hutscape/oak/readme.md

# Oak

> 🌳 Outdoor LoRa-GPS tracker with E-Ink display  🔑

Visit [hutscape.com/oak](https://hutscape.com/oak) for more details.

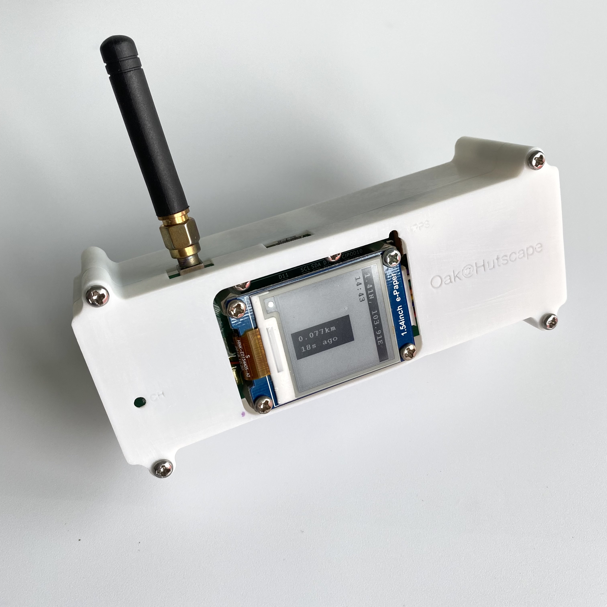
[picture p1: images/prototype/front.jpg]
