hutscape/oak/others.md

---
layout: others
title: Others
permalink: /others
sequence: 7

# Lessons
lessons:
  - title: Lessons learnt
    subtitle: Good practices to continue for future projects
    list:
      - name: Add functional logical blocks in schematic to use similar circuits in future versions or other projects
      - name: Use stencil SMD soldering with SMD components only if it is necessary. Else, use a PCB assembly service.
      - name: Use minimum number of through-hole components
      - name: Check Gerber file format with the PCB manufacturer before rendering them
      - name: Check <code>F.Paste</code> and <code>B.Paste</code> layers for SMD stencil pattern
      - name: Pull out every single MCU pin as a test point for the first version of the project.
      - name: Always buy buffer number of components. Image is from the book Designing Electronics That Work by Hunter Scott.
        image: buffer-components.png

  - title: Enclosure
    subtitle: Next iteration improvements
    list:
      - name: Make the PCB routing symmetrical for LED positions and connector slots
      - name: Ensure the length is not too long to prevent bending of the material
      - name: Use wider ventilation holes with wider spacing between each of them
      - name: Use less clearance for connector slots. Take note of finger access
      - name: Use other shapes for connector slots E.g. rounded corner or trapezoid
      - name: Use shape binder for seperation plane bends
      - name: Use a counter sunk screw head
      - name: Make the screw lug's initial length be wider to contain the screw head so that it can sink into the surface
      - name: Try a snap-fit enclosure

  - title: V2.0
    subtitle: For next iteration
    list:
      - name: Use SMD components only on top layer for one-step manual SMD stencil soldering process
      - name: Place a writable area on the silkscreen to note down LoRa node address, PCB number, frequency or other info
      - name: Add a <a href="https://sg.element14.com/c/test-measurement/test-connectors-ic-clips/pcb-test-points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">surface mount PCB test point</a> for <code>VBAT</code>, <code>VBUS</code>, <code>3.3V</code>, <code>5V</code>, <code>GND</code> and SPI points.
      - name: Use a smaller <code>SSD1306</code> I2C OLED display instead of E-Ink. It's cheaper and easier to source and buy.

  - title: Board bring-up
    list:
      - name: Check with 3 PCBs to conclude whether it is a design issue or a soldering / manufacturing / assembly issue
      - name: Power it with current limiting power supply unit only. Check all the power test points such as <code>VBAT</code>, <code>VBUS</code>, <code>3.3V</code>, <code>5V</code>, <code>GND</code>.

# References
similar:
  - name: LilyGO TTGO T-Beam
    url: https://github.com/Xinyuan-LilyGO/LilyGO-T-Beam
    type: developer
    year: 2019
    cost: 25
    components:
      - type: LoRa
        name: SX1262
        url: https://semtech.my.salesforce.com/sfc/p/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
      - type: battery
        name: 18650
        url: https://datasheetspdf.com/pdf-file/1408721/TENERGY/18650/1
      - type: mcu
        name: ESP32
        url: https://www.espressif.com/en/products/socs/esp32
      - type: GPS
        name: ublox NEO 6M
        url: https://www.u-blox.com/en/product/neo-6-series
      - type: Display
        name: OLED SSD1306
        url: https://cdn-shop.adafruit.com/datasheets/SSD1306.pdf
  - name: a LoraWAN GPS tracker
    url: https://notes.iopush.net/how-to-make-a-lorawan-gps-tracker/
    type: developer
    year: 2016
    components:
      - type: LoRa
        name: RFM95
        url: https://cdn.sparkfun.com/assets/learn_tutorials/8/0/4/RFM95_96_97_98W.pdf
      - type: battery
        name: 18650
        url: https://datasheetspdf.com/pdf-file/1408721/TENERGY/18650/1
      - type: software
        name: node red
        url: https://nodered.org/
  - name: LoRaSensorTile
    url: https://hackaday.io/project/35169-hackable-cmwx1zzabz-lora-devices
    type: developer
    year: 2018
    components:
      - type: LoRa (with MCU STM32L082)
        name: CMWX1ZZABZ-078
        url: https://wireless.murata.com/pub/RFM/data/type_abz.pdf
      - type: mcu
        name: STM32L082
        url: https://www.st.com/resource/en/datasheet/dm00141132.pdf
      - type: accelerometer
        name: BMA280
        url: https://www.bosch-sensortec.com/products/motion-sensors/accelerometers/bma280.html#tab_module_16_1_2
      - type: pressure sensor
        name: BME280
        url: https://www.bosch-sensortec.com/products/environmental-sensors/humidity-sensors-bme280/
      - type: RGBW light sensor
        name: VEML6040
        url: https://www.vishay.com/ppg?84276
      - type: flash memory
        name: MX25L12835FZNI
        url: https://www.macronix.com/Lists/Datasheet/Attachments/7397/MX25L12835F,%203V,%20128Mb,%20v1.6.pdf
  - name: GPS Live Tracking
    type: developer
    url: https://kokonatt.com/embedded/gps-live-tracking
    components:
      - type: microcontroller
        name: ESP8266
        url: https://www.espressif.com/en/products/socs/esp8266
      - type: GPS
        name: u-blox Neo-6M
        url: https://www.u-blox.com/en/product/neo-6-series
      - type: visualization
        name: Grafana
        url: https://grafana.com/docs/grafana/latest/administration/configuration/
      - type: database
        name: Influx DB
        url: https://www.influxdata.com/
      - type: LoRa
        name: SX1278
        url: https://cdn-shop.adafruit.com/product-files/3179/sx1276_77_78_79.pdf
  - name: LoRaWAN GPS Tracker with 9-axis accelerometer-LGT92- 868MHz
    type: developer
    url: https://www.seeedstudio.com/LoRaWAN-GPS-Tracker-with-9-axis-accelerometer-LGT92-p-2922.html
    cost: 39.50
    year: 2020
    components:
      - type: microcontroller
        name: STM32L072
      - type: LoRa
        name: SX1276 / 1278
      - type: battery
        name: 1000mA Li-on
      - type: accelerometer
        name:  MPU-9250
        url: https://invensense.tdk.com/wp-content/uploads/2015/02/PS-MPU-9250A-01-v1.1.pdf
  - name: SAMD21 LoRa Development Board with GPS
    url: https://hackaday.io/project/165646-samd21-lora-development-board-with-gps
    year: 2018
    type: developer
    components:
      - type: microcontroller
        name: ATSAMD21E18A-AU
      - type: GPS
        name: Quectel L80 GPS module
      - type: LoRa
        name: RFM95W
      - type: battery
        name: LiOn

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

  - topic: LoRa Antenna
    list:
      - name: Testing LoRa Antennas at 915MHz
        url: https://medium.com/home-wireless/testing-lora-antennas-at-915mhz-6d6b41ac8f1d

  - topic: GPS
    list:
      - name: Calculate distance between two latitude-longitude points? (Haversine formula)
        url: https://stackoverflow.com/a/27943/496797
      - name: Haversine formula
        url: https://en.wikipedia.org/wiki/Haversine_formula
      - name: Testing out an upcoming STEMMA GPS board for STEMMA SUNDAY
        url: https://www.youtube.com/watch?v=JhquVC3RbZU
      - name: Adafruit Mini GPS PA1010D - UART and I2C - STEMMA QT
        url: https://www.adafruit.com/product/4415
      - name: Adafruit GPS Arduino firmware
        url: https://github.com/adafruit/Adafruit_GPS
      - name: CD-PA1010D GNSS patch antenna module Data Sheet V.02
        url: http://docs.mirifica.eu/CDtop-tech.com/CD-PA1010/CD-PA1010D-datasheet-v02.pdf
      - name: CDTop Technology PA1010Dv2 (CD-PA1010D2)
        url: https://www.mirifica.de/101067-1/cdtop-technology/pa1010daa19220027
      - name: NEO-6M GPS Module — An Introduction
        url: https://www.electroschematics.com/neo-6m-gps-module/
      - name: GPS Nixie Alarm Clock with Ublox NEO-6M GPS module
        url: https://hackaday.io/project/9417-gps-nixie-alarm-clock
      - name: Mini GSM/GPRS GPS Breakout SIM808
        url: http://wiki.seeedstudio.com/Mini_GSM_GPRS_GPS_Breakout_SIM808/
      - name: SIM808 GPS Application Note V1.00
        url: https://cdn-shop.adafruit.com/datasheets/SIM808_GPS_Application_Note_V1.00.pdf
      - name: 66-Channel LS20031 GPS Receiver Module (MT3329 Chipset)
        url: https://www.pololu.com/product/1249
      - name: Adafruit ultimate GPS with MTK3339 chipset
        url: https://www.adafruit.com/product/746
      - name: MEDIATEK - 3329 Datasheet
        url: https://www.puntoflotante.net/MEDIATEK-3329.pdf
      - name: GSM & GPS Car Diagnosis System with MEDIATEK MT3329
        url: https://hackaday.io/project/711-gsm-gps-car-diagnosis-system
      - name: Quectel L30 Compact GPS Module with Super Sensitivity
        url: https://www.quectel.com/UploadFile/Product/Quectel_L30_GPS_Specification_V2.0.pdf
      - name: NEO-7 series u-blox 7 GNSS modules
        url: https://www.u-blox.com/en/product/neo-7-series
      - name: NEO-6 series Versatile u-blox 6 GPS modules
        url: https://www.u-blox.com/en/product/neo-6-series
      - name: NEO-6 u-blox 6 GPS Modules Data Sheet
        url: https://www.u-blox.com/sites/default/files/products/documents/NEO-6_DataSheet_%28GPS.G6-HW-09005%29.pdf
      - name: SkyTraq Venus838LPx-T Timing GPS module breakout
        url: https://www.tindie.com/products/nsayer/skytraq-venus838lpx-t-timing-gps-module-breakout/
      - name: Venus838LPx-T 1cm2 Precision Timing GPS Receiver
        url: https://www.skytraq.com.tw/homesite/Venus838LPx-T_PB_v2.pdf
      - name: MAX-7 series u-blox 7 GNSS modules
        url: https://www.u-blox.com/en/product/max-7-series

  - topic: E-Ink
    list:
      - name: Waveshare 1.54inch e-Paper Module
        url: https://www.waveshare.com/wiki/1.54inch_e-Paper_Module
      - name: Waveshare 200x200, 1.54inch E-Ink raw display panel
        url: https://www.waveshare.com/product/modules/oleds-lcds/e-paper/1.54inch-e-paper.htm
      - name: Waveshare 200x200, 1.54inch E-Ink raw display panel schematic to module
        url: https://www.waveshare.com/w/upload/5/5b/1.54inch_e-Paper_Schematic.pdf
      - name: Waveshare 1.54inch e-Paper Module datasheet
        url: https://www.waveshare.com/w/upload/7/77/1.54inch_e-Paper_Datasheet.pdf

  - topic: Firmware
    list:
      - name: Arduino Core for STM32L0 with LoRaWAN connectivity
        url: https://github.com/GrumpyOldPizza/ArduinoCore-stm32l0

  - topic: SPI
    list:
      - name: How to access multiple SPI interfaces on Arduino
        url: https://arduino.stackexchange.com/questions/8425/how-to-access-multiple-spi-interfaces-on-arduino
      - name: Better SPI BUS design in 3 steps
        url: https://dorkbotpdx.org/blog/paul/better_spi_bus_design_in_3_steps/
      - name: Serial Peripheral Interface (SPI)
        url: https://learn.sparkfun.com/tutorials/serial-peripheral-interface-spi

  - topic: Manufacturing
    list:
      - name: How to Solder Castellated Mounting Holes
        url: https://learn.sparkfun.com/tutorials/how-to-solder-castellated-mounting-holes/all

# Schedule
design_start: '2019-11-05'
design_end: '2021-05-20'
manufacturing_start: '2021-05-24'
manufacturing_end: '2021-06-10'
integration_start: '2021-06-21'
integration_end: '2021-12-31'
deployment_start: '2022-01-01'
deployment_end: '2022-02-15'
---
