hutscape/oak/case/case.md

---
layout: case
title: Case
permalink: /case
sequence: 3
photos:
  - name: case-front.png
    caption: Case front
  - name: case-back.png
    caption: Case back
  - name: case-details-1.png
    caption: Case details 1
  - name: case-details-2.png
    caption: Case details 2
threedprint: true

manufacturing_params_image: manufacturing_params_case.png
manufacturing_params:
  - name: Manufacturer
    value: PCBWay
  - name: Build time
    value: 5 days
  - name: Size
    value: 132.40 mm × 55.80 mm × 23.20 mm
  - name: Material
    value: Resin Standard white material (UTR 8360)
  - name: Color
    value: Matte White
  - name: Process
    value: SLA
---
