hutscape/oak/examples.md

---
layout: default
title: Examples
permalink: /examples
sequence: 2
---

{% if site.examples %}
<section class="section is-small">
  <div class="container">
    <h2 class="title is-1">Examples</h2>
    <div class="content is-medium">
      <ol type="1">
        {% for example in site.examples %}
        <li>
          <a href="{{ site.url }}{{ example.url }}">{{ example.title }}</a>
          <div class="tags is-pulled-right">
            {% for feat in example.features %}
            <span class="tag is-warning is-light">{{ feat }}</span>
            {% endfor %}
            {% for v in example.versions %}
            <span class="tag is-link is-light">{{ v.name }} v{{v.version}}</span>
            {% endfor %}
            <span class="tag">{{ example.difficulty }}</span>
            <!-- TODO -->
            {% if jekyll.environment == "development" %}
            {% if example.images.prototype %}
            {% else %}
            <span class="tag is-danger">TODO Prototype image</span>
            {% endif %}
          {% endif %}
          </div>
        </li>
        {% endfor %}
      </ol>
    </div>
  </div>
</section>
{% endif %}
