hutscape/oak/images/case/case-3dprint-1.jpg

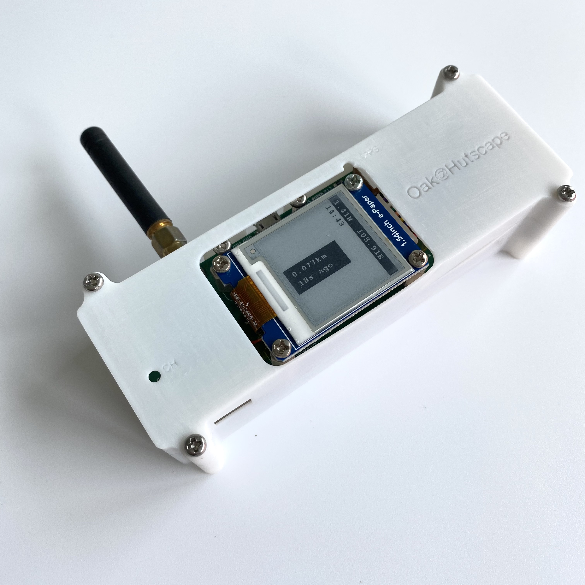
images/case/case-3dprint-1.jpg
