hutscape/oak/images/case/case-3dprint-2.jpg

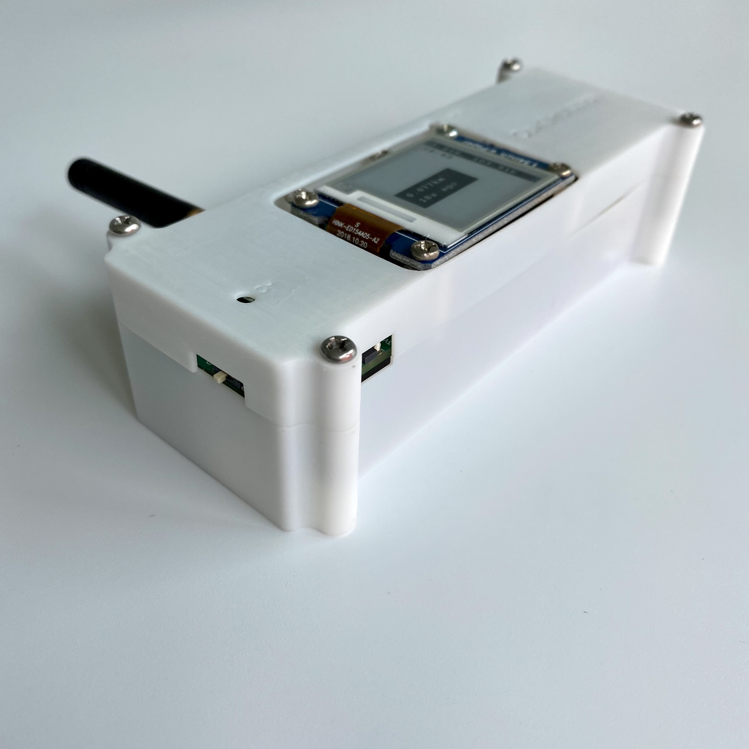
images/case/case-3dprint-2.jpg
