hutscape/oak/images/case/case-3dprint-4.jpg

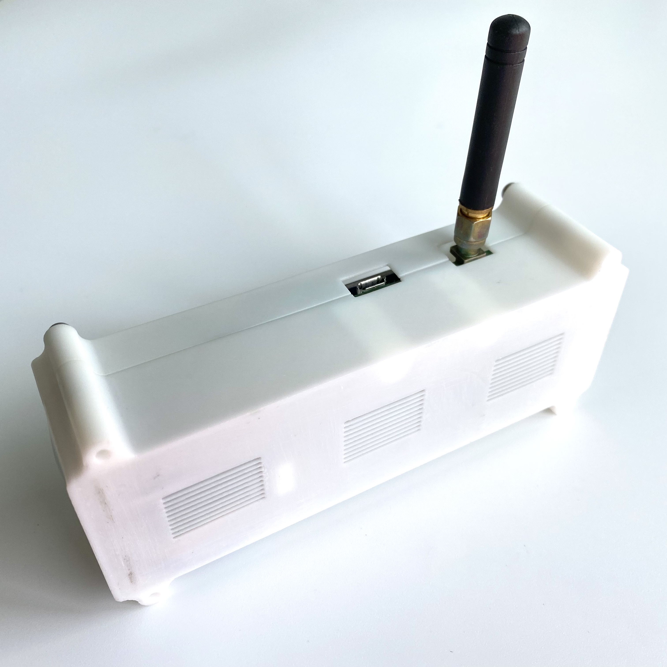
images/case/case-3dprint-4.jpg
