hutscape/oak/images/case/case-electronics.png

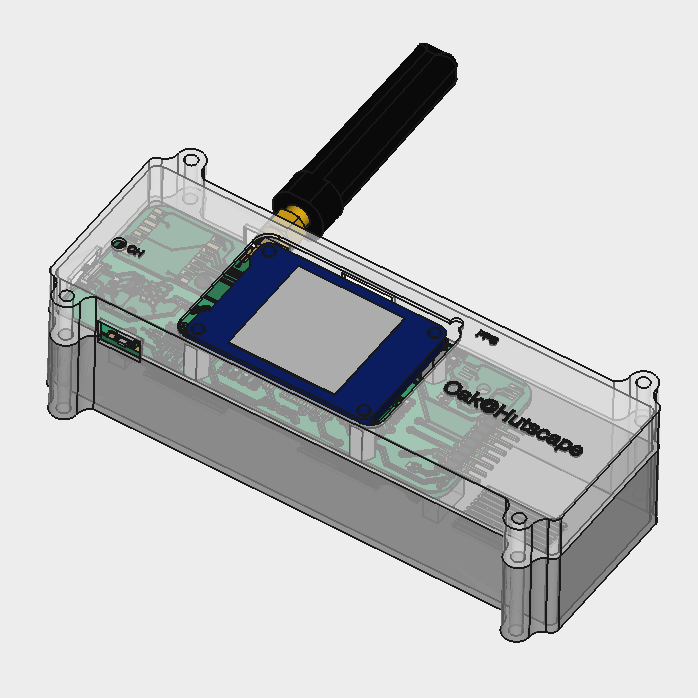
images/case/case-electronics.png
