hutscape/oak/images/case/case.png

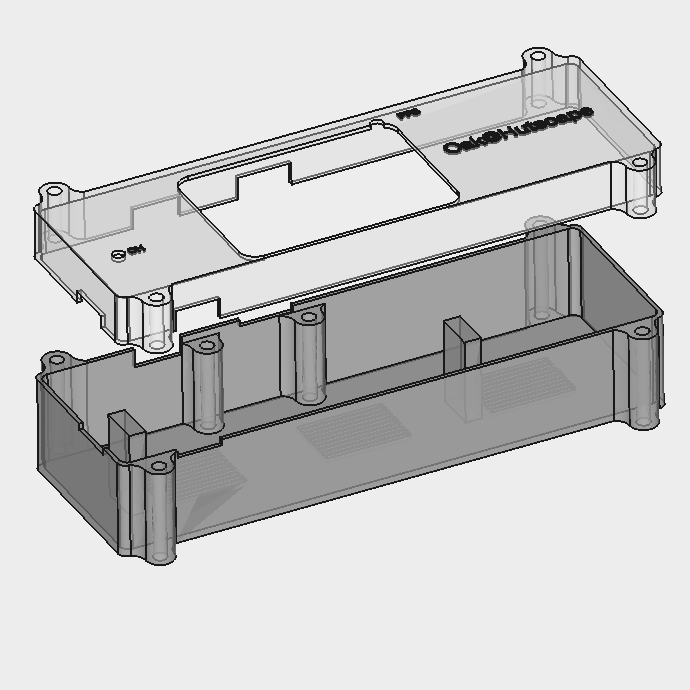
images/case/case.png
