hutscape/oak/images/code/arduino-ide-board.png

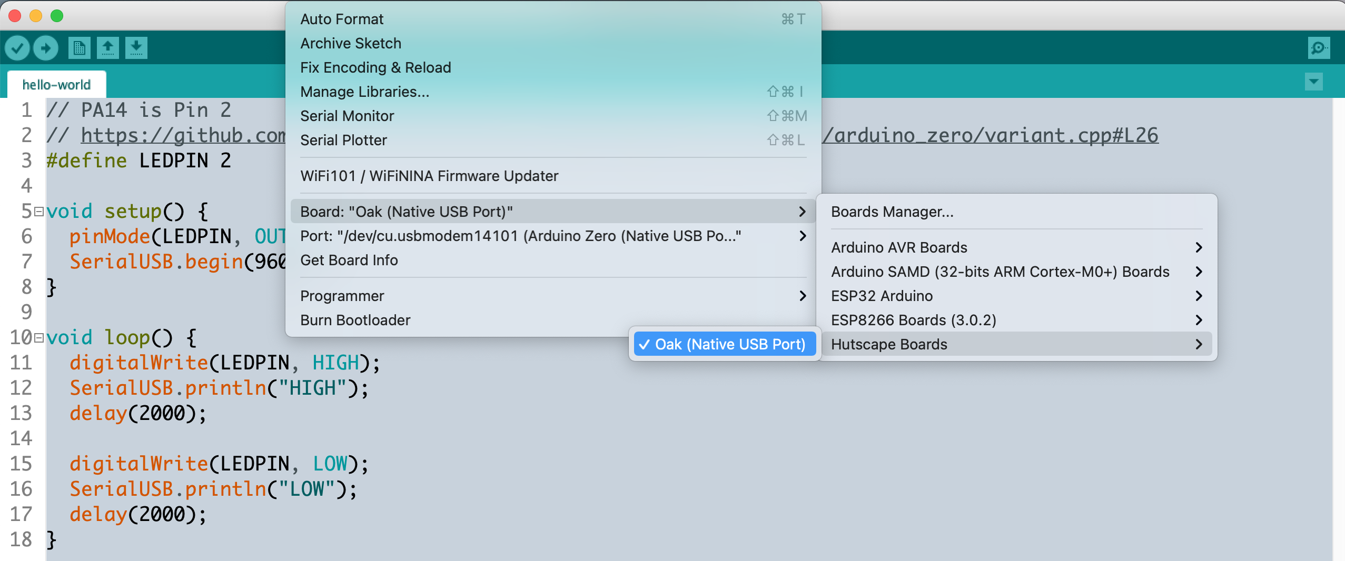
images/code/arduino-ide-board.png
