hutscape/oak/images/code/bootloader-prototype.jpg

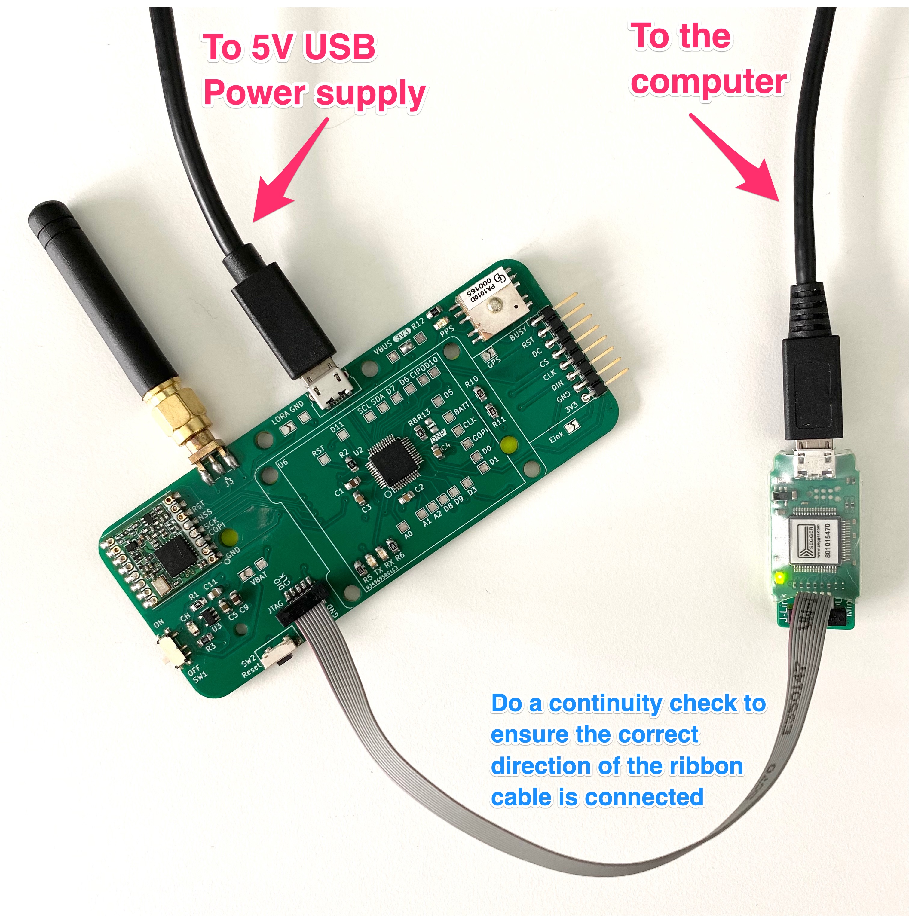
images/code/bootloader-prototype.jpg
