hutscape/oak/images/code/bootloader-schematic.png

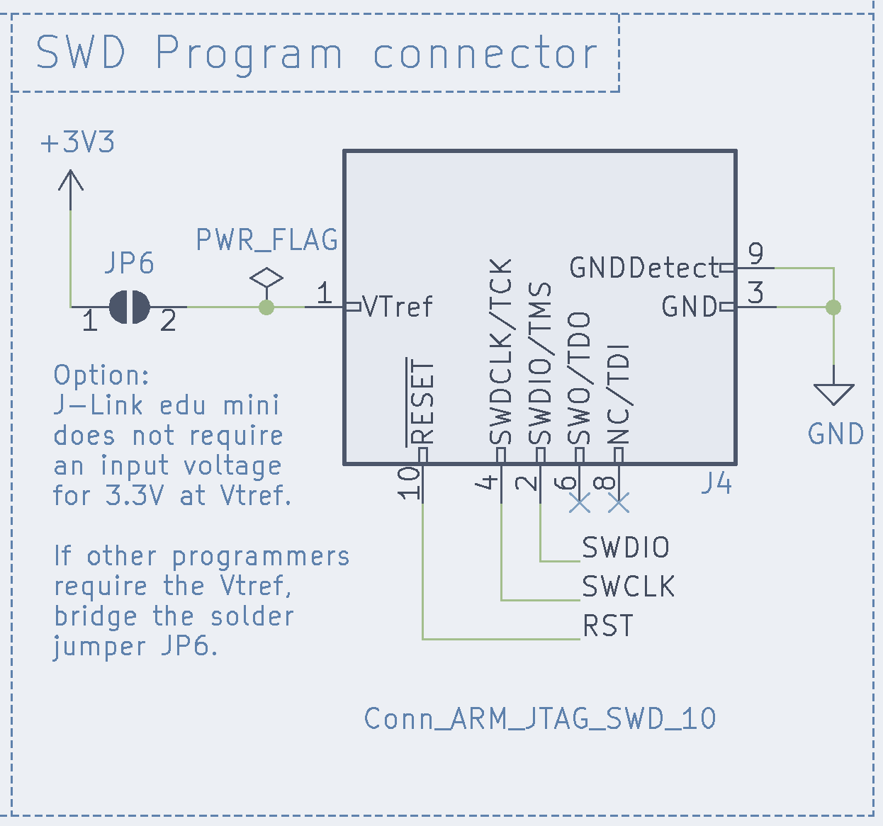
images/code/bootloader-schematic.png
