hutscape/oak/images/code/custom-arduino-prototype.jpg

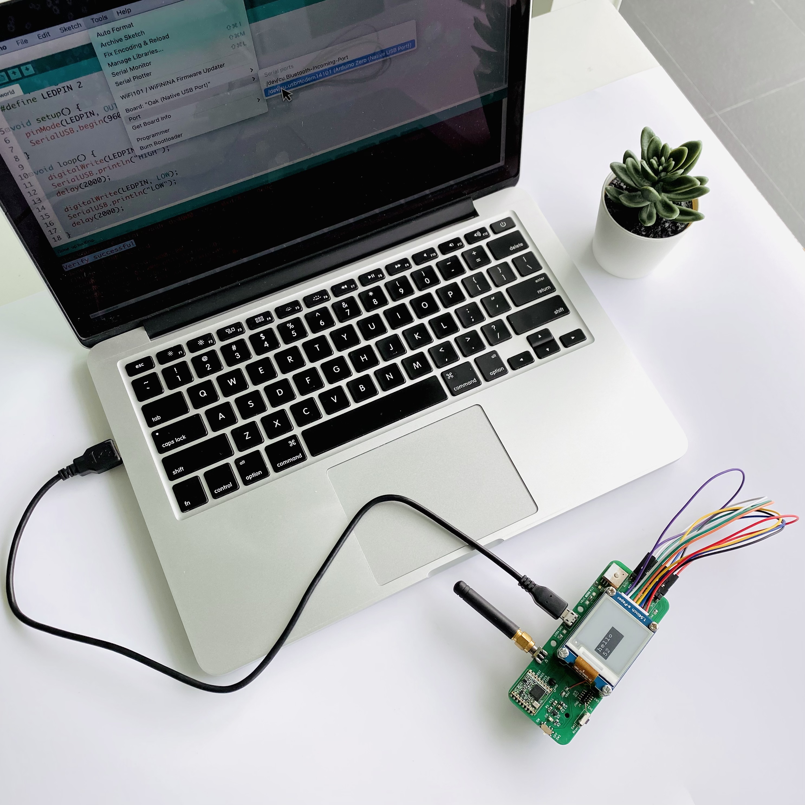
images/code/custom-arduino-prototype.jpg
