hutscape/oak/images/code/demo-console.png

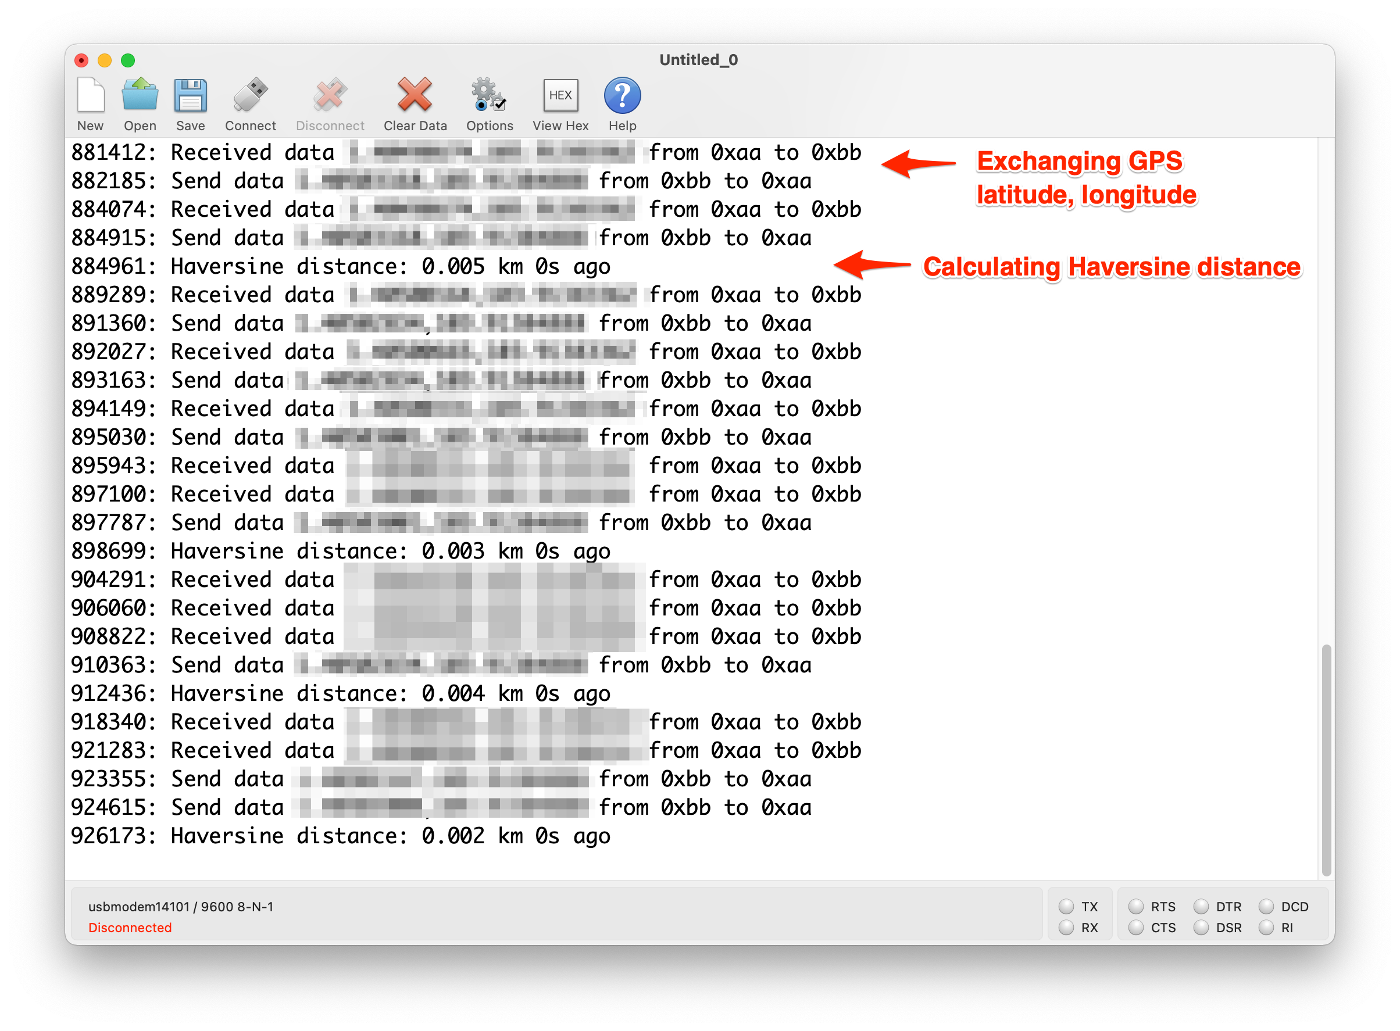
images/code/demo-console.png
