hutscape/oak/images/code/demo-prototype.jpg

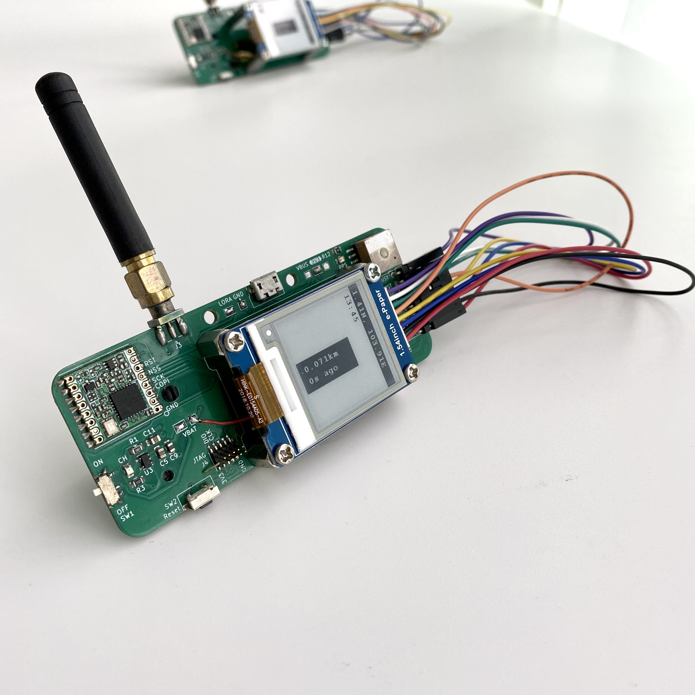
images/code/demo-prototype.jpg
