hutscape/oak/images/code/demo-waiting.jpg

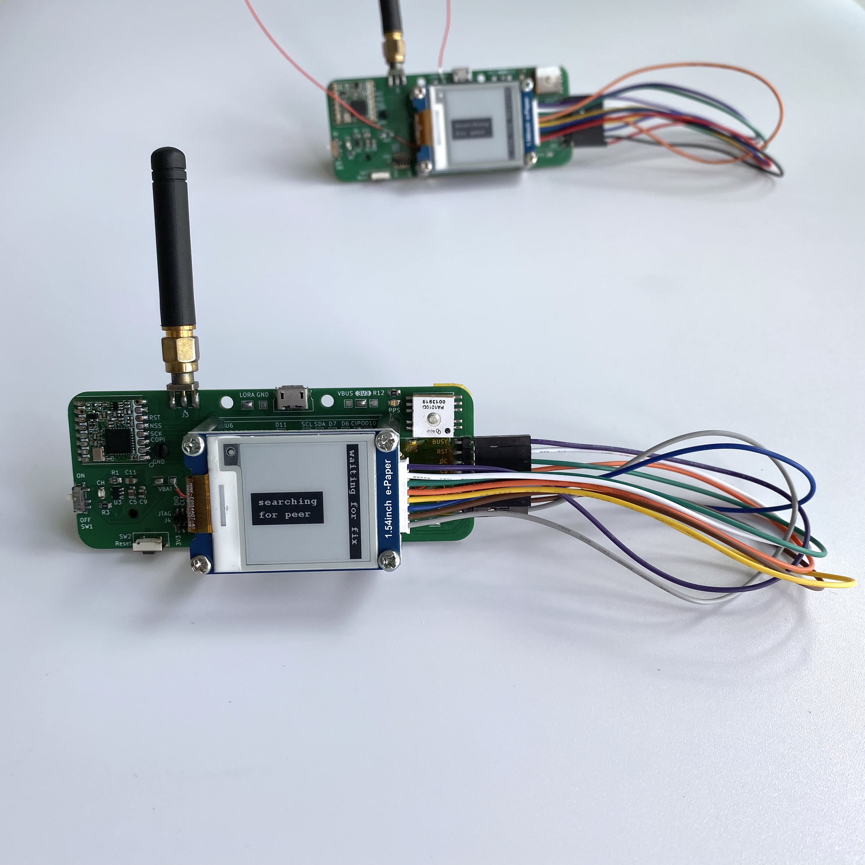
images/code/demo-waiting.jpg
