hutscape/oak/images/code/eink-console.png

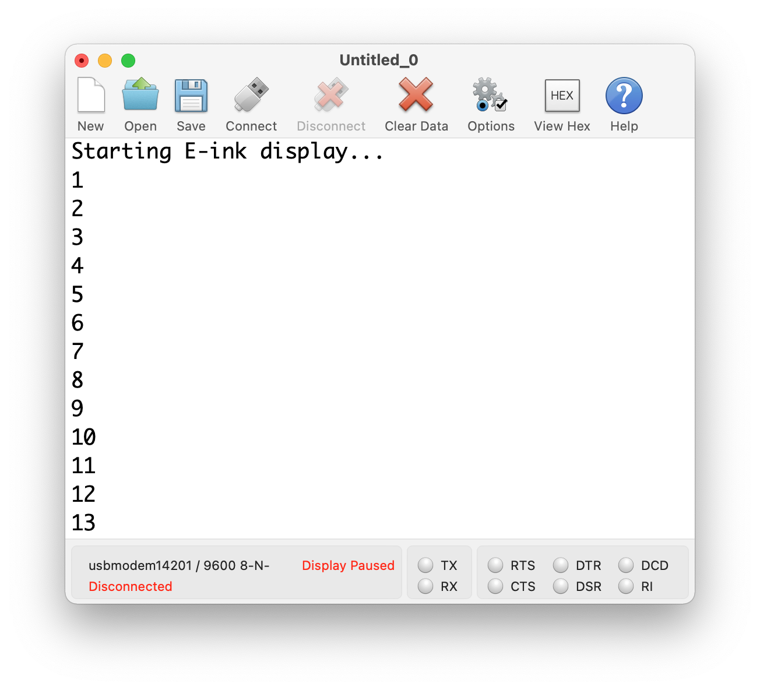
images/code/eink-console.png
