hutscape/oak/images/code/eink-rotated-console.png

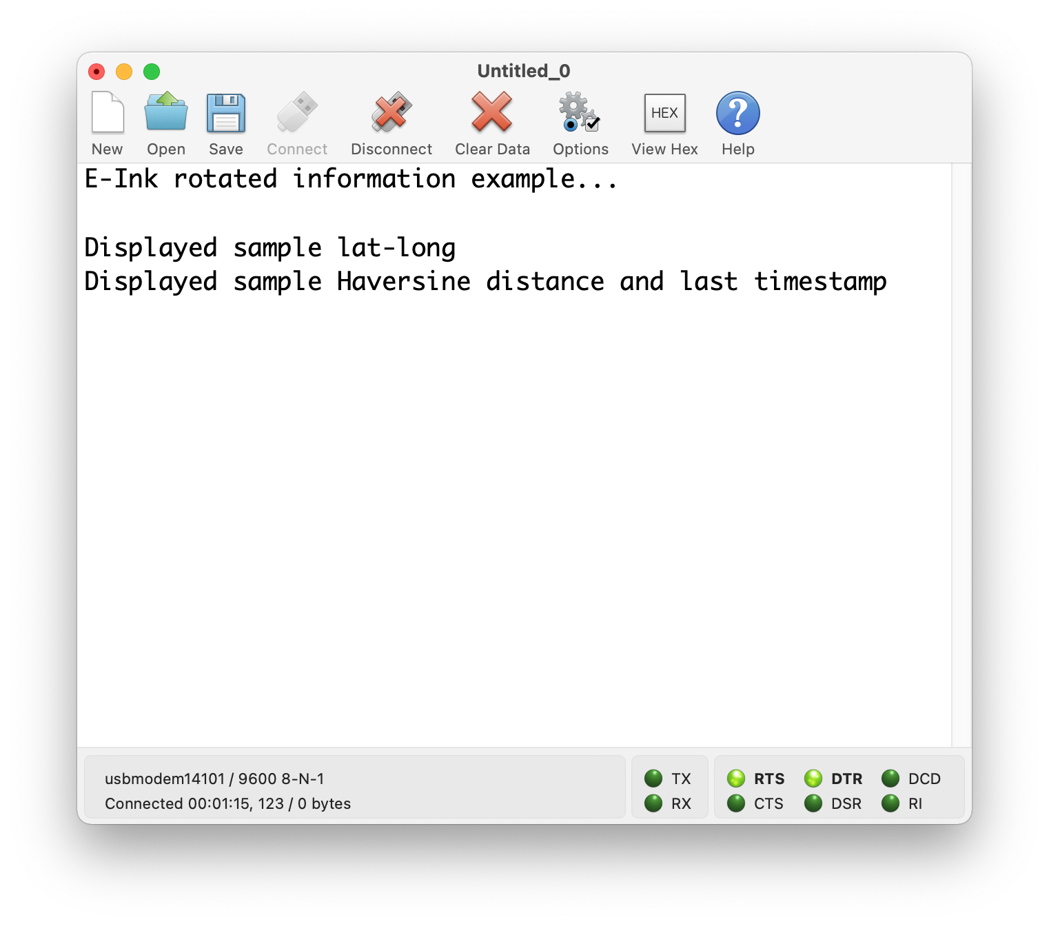
images/code/eink-rotated-console.png
