hutscape/oak/images/code/eink-rotated-prototype.jpg

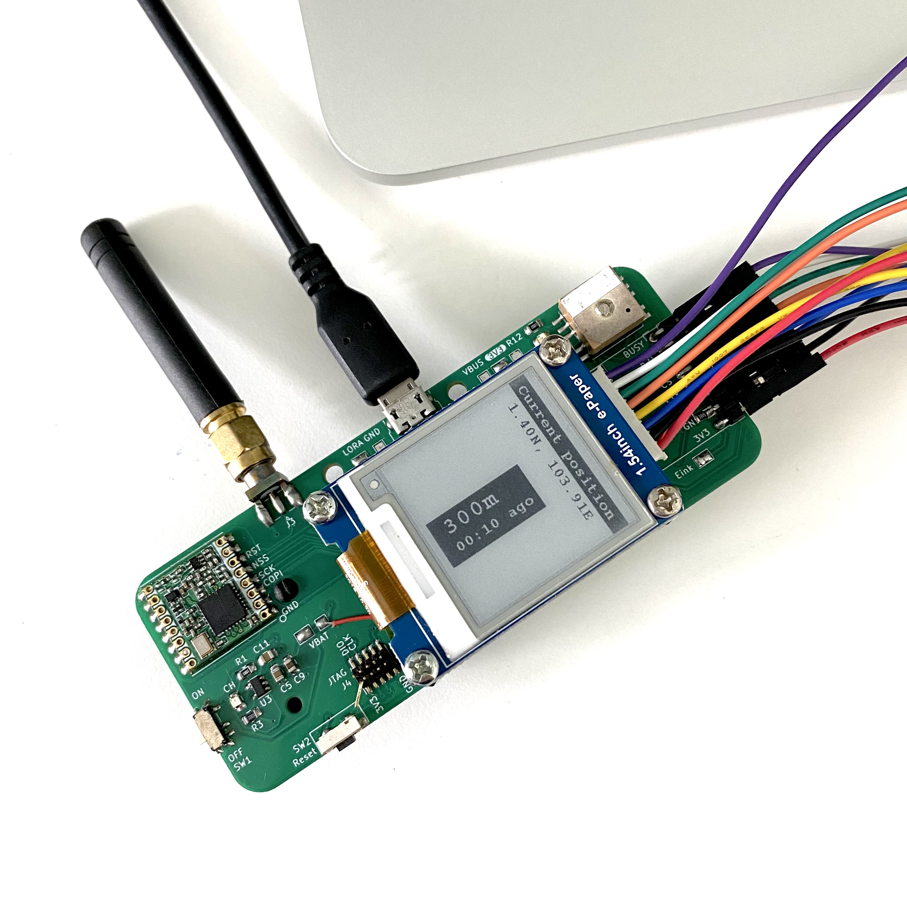
images/code/eink-rotated-prototype.jpg
