hutscape/oak/images/code/eink-schematic.png

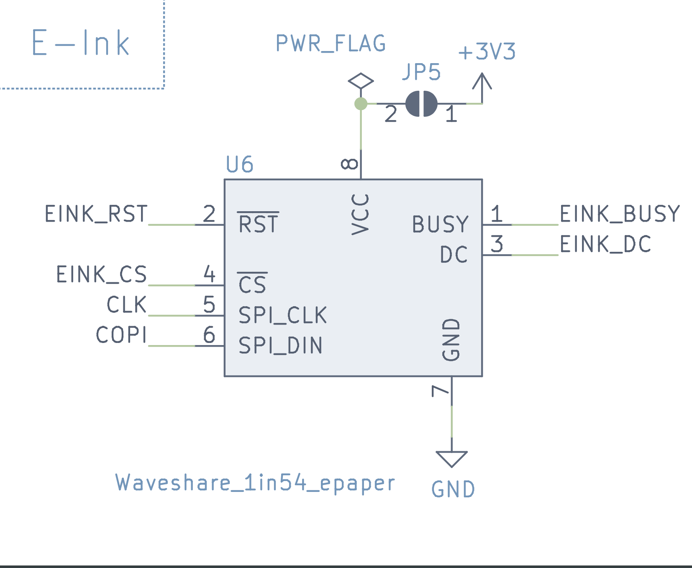
images/code/eink-schematic.png
