hutscape/oak/images/code/eink-v2-console.png

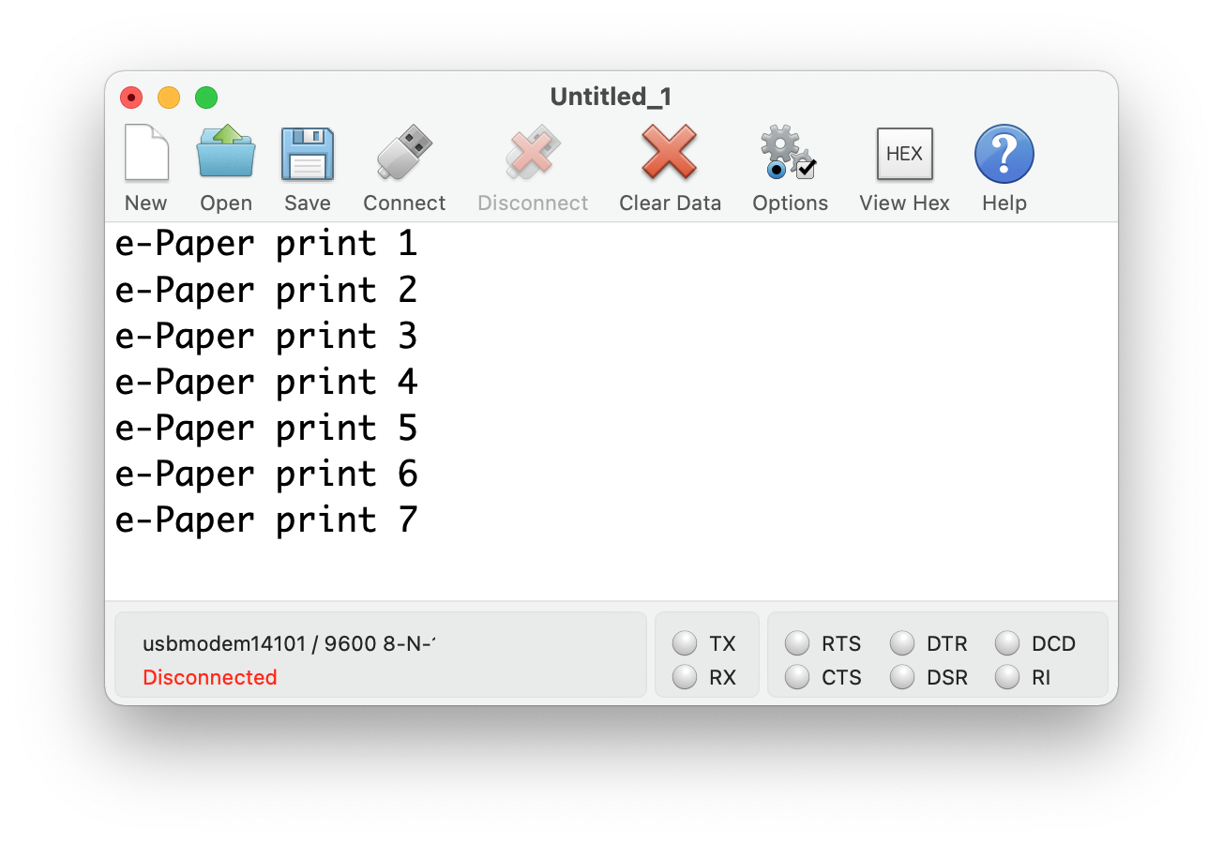
images/code/eink-v2-console.png
