hutscape/oak/images/code/eink-v2-prototype.jpg

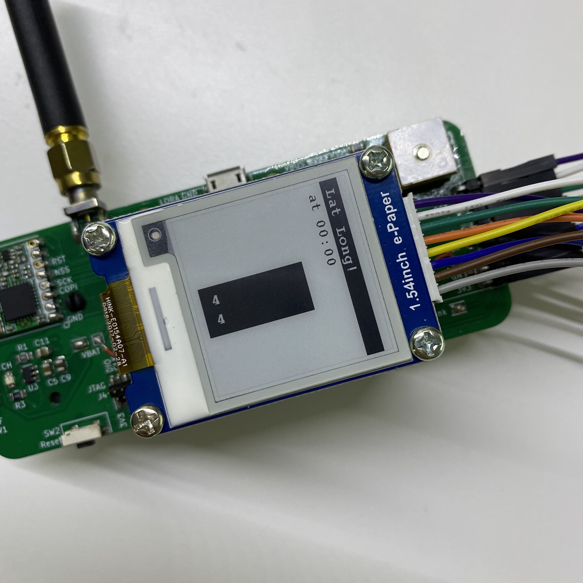
images/code/eink-v2-prototype.jpg
