hutscape/oak/images/code/flash-console.png

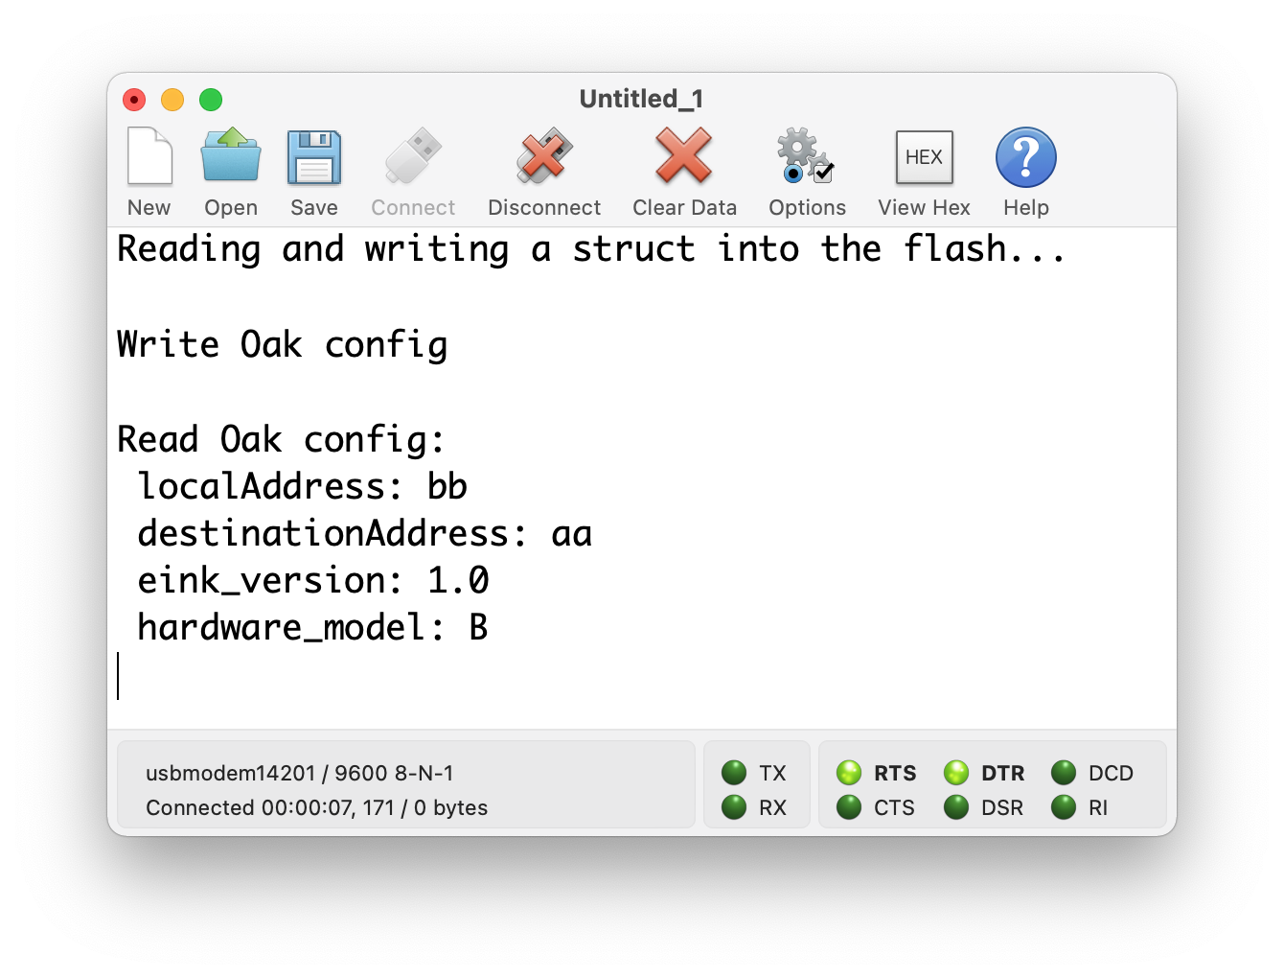
images/code/flash-console.png
