hutscape/oak/images/code/gps-console.png

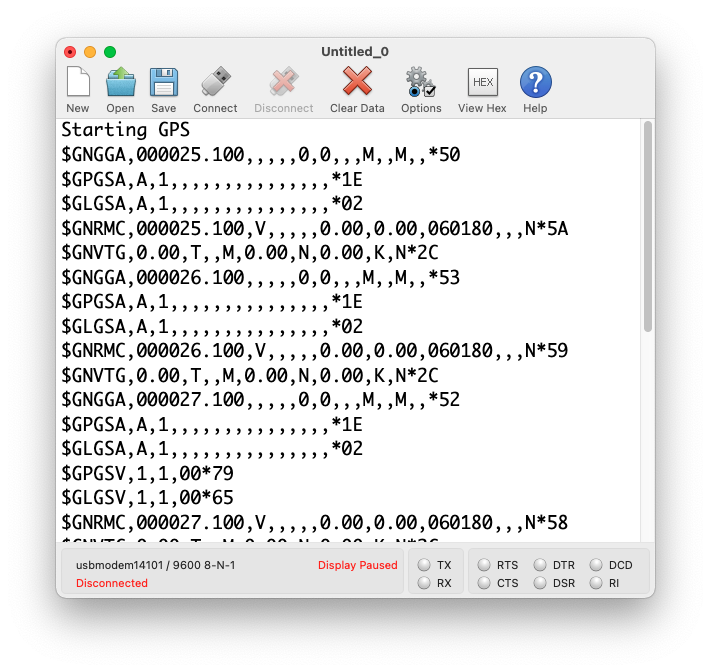
images/code/gps-console.png
