hutscape/oak/images/code/gps-prototype.jpg

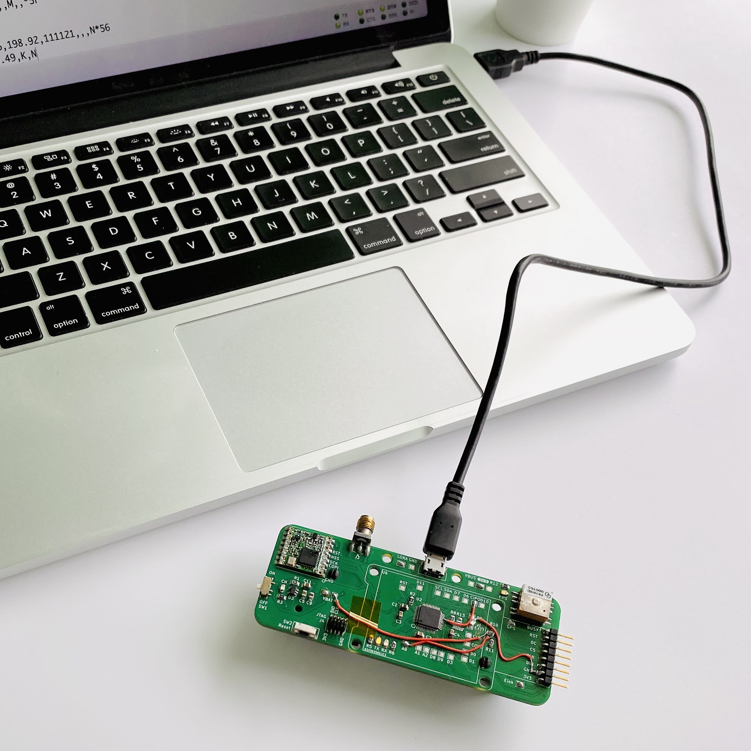
images/code/gps-prototype.jpg
