hutscape/oak/images/code/gps-schematic.png

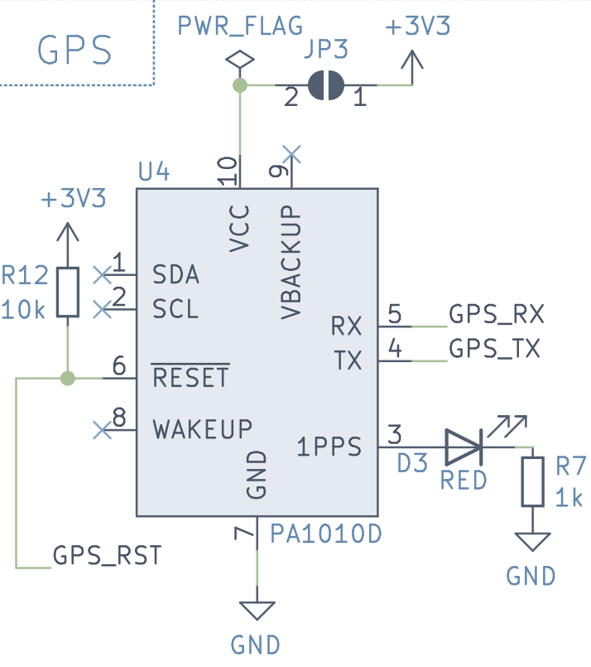
images/code/gps-schematic.png
