hutscape/oak/images/code/hello-world-1.jpg

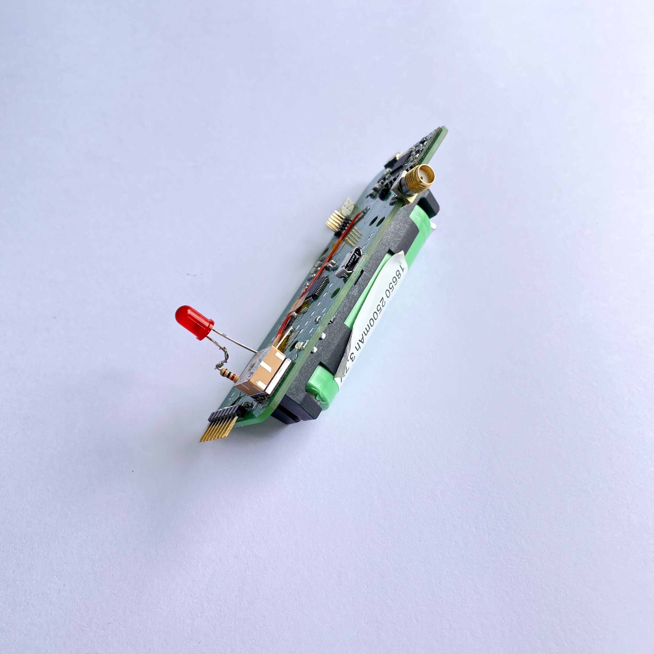
images/code/hello-world-1.jpg
