hutscape/oak/images/code/hello-world-2.jpg

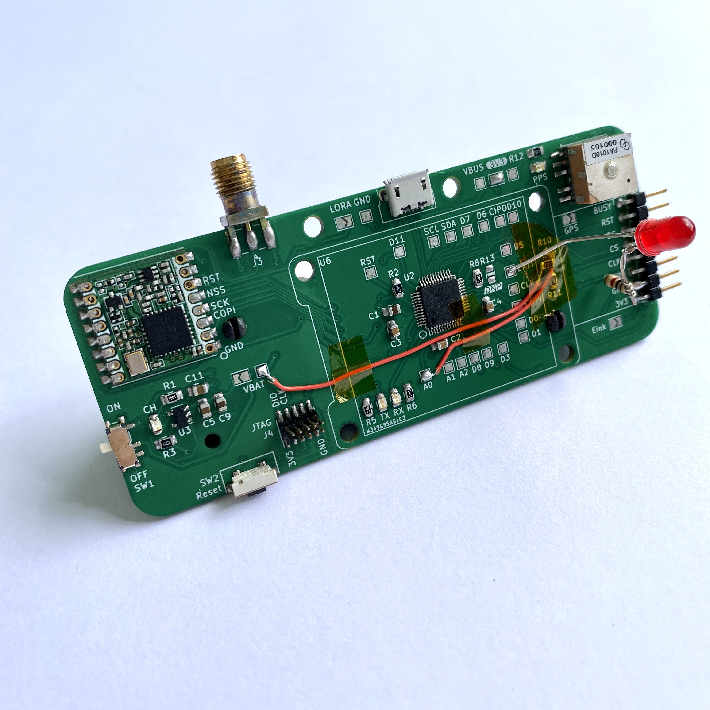
images/code/hello-world-2.jpg
