hutscape/oak/images/code/hello-world-3.jpg

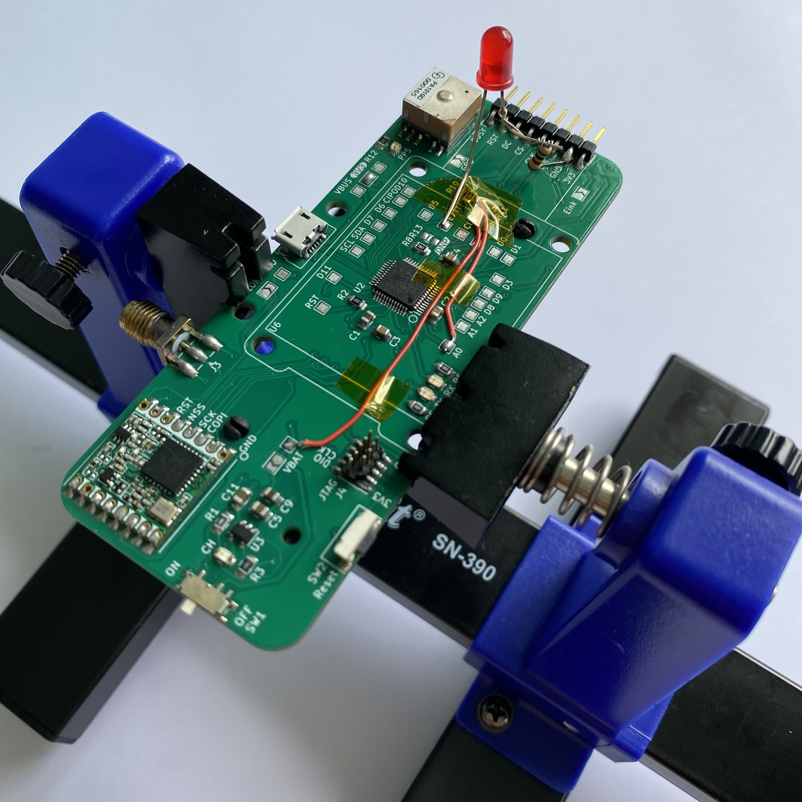
images/code/hello-world-3.jpg
