hutscape/oak/images/code/hello-world-console.png

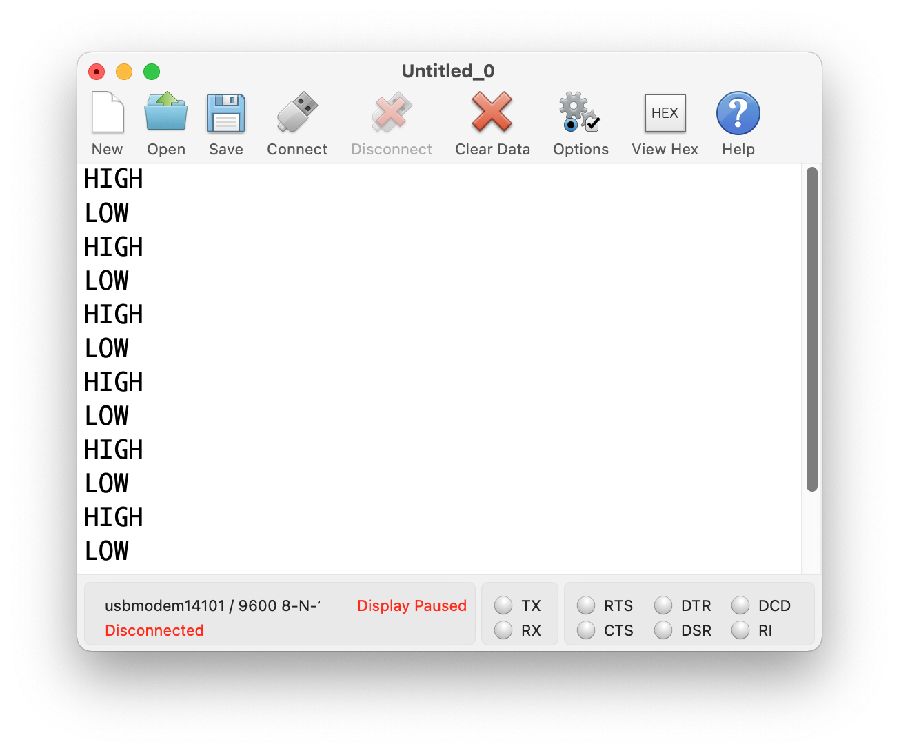
images/code/hello-world-console.png
