hutscape/oak/images/code/hello-world-prototype.jpg

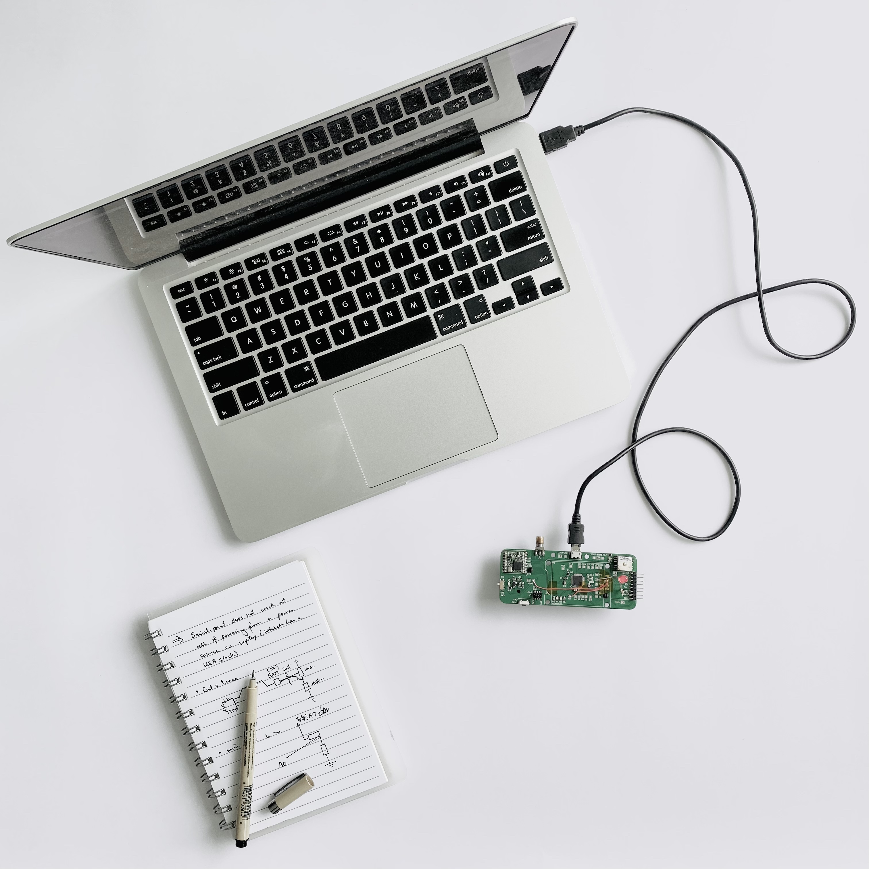
images/code/hello-world-prototype.jpg
