hutscape/oak/images/code/latlong-conversions-console.png

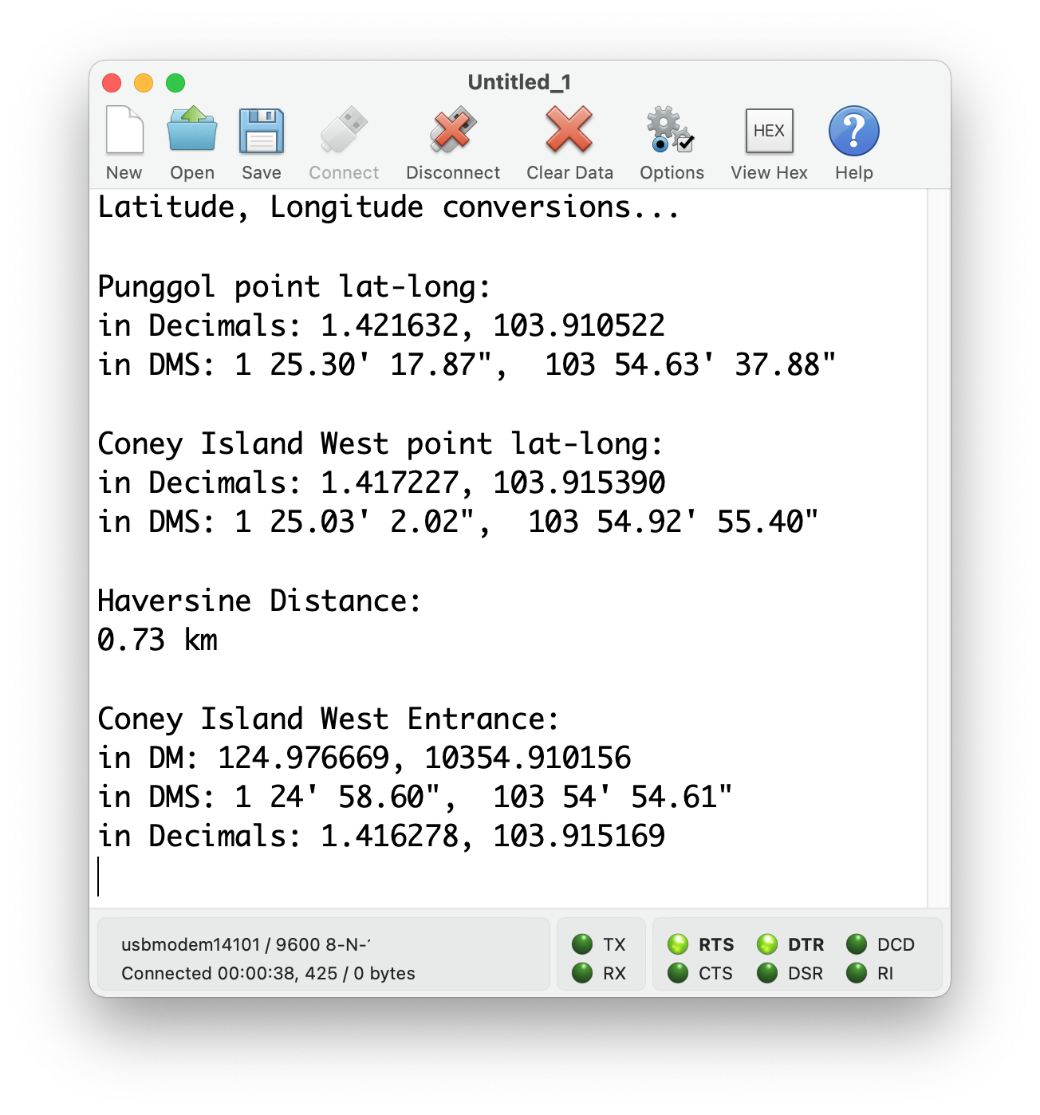
images/code/latlong-conversions-console.png
