hutscape/oak/images/code/lora-duplex-console.png

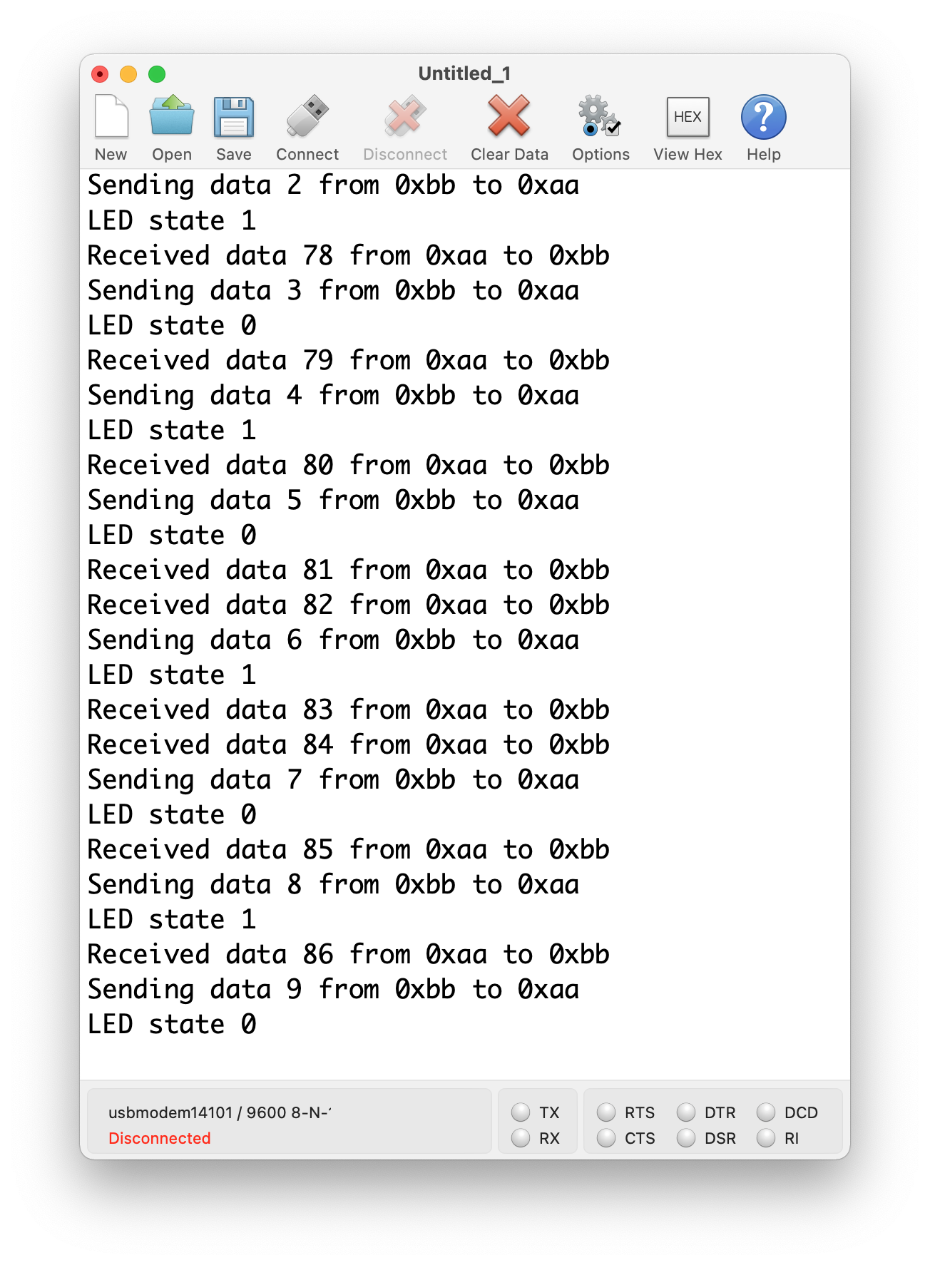
images/code/lora-duplex-console.png
