hutscape/oak/images/code/lora-gps-duplex-console.png

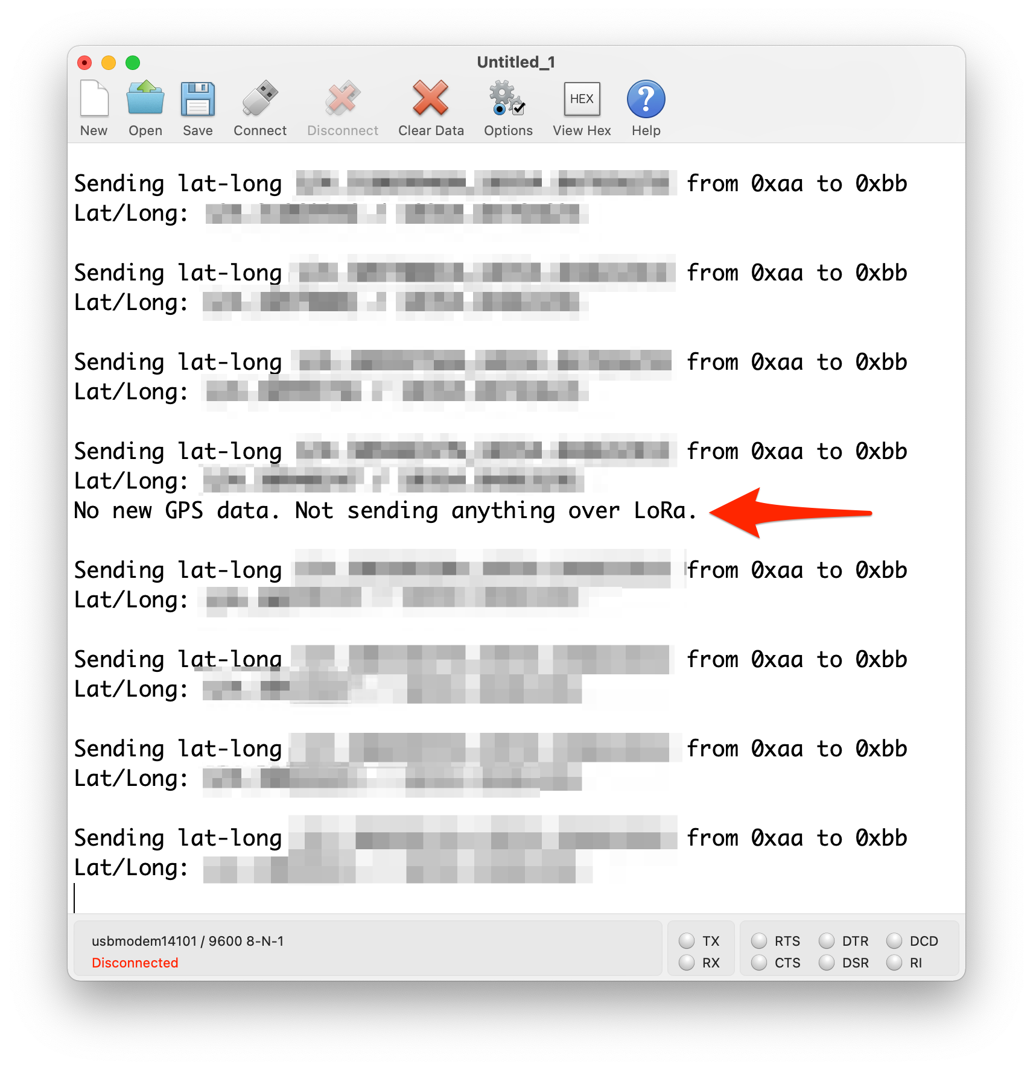
images/code/lora-gps-duplex-console.png
