hutscape/oak/images/code/lora-prototype.jpg

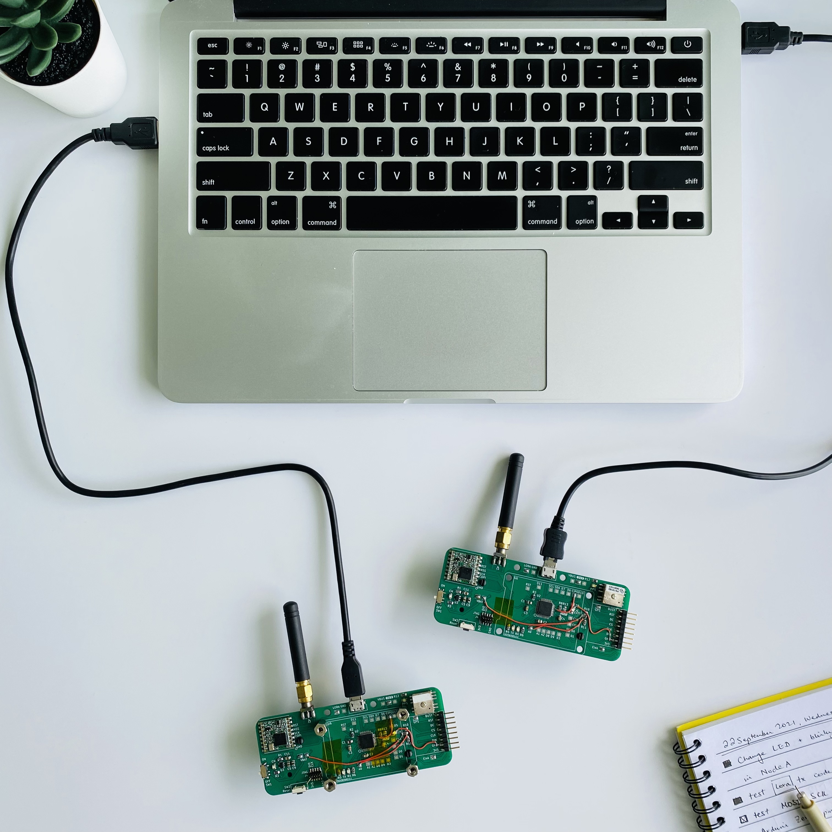
images/code/lora-prototype.jpg
