hutscape/oak/images/code/lora-rx-console.png

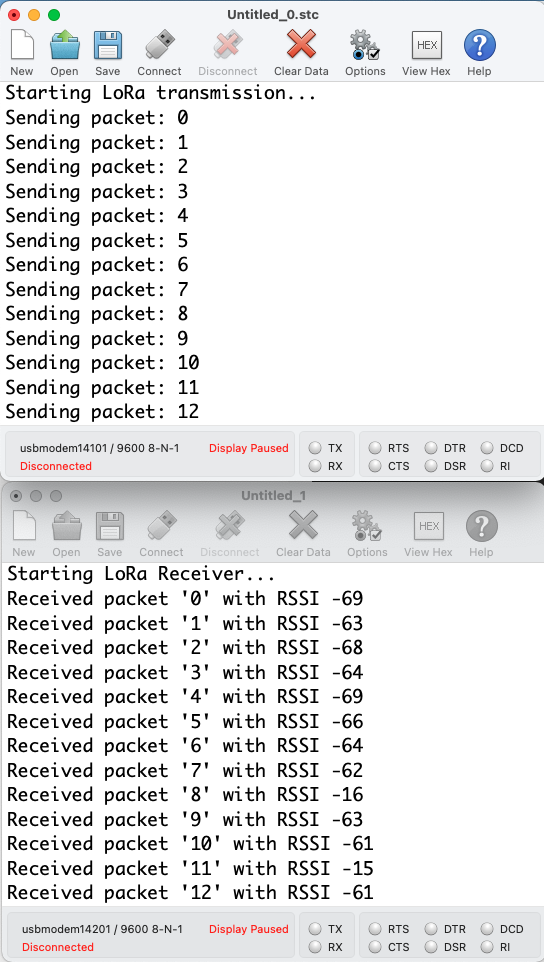
images/code/lora-rx-console.png
