hutscape/oak/images/code/lora-tx-console.png

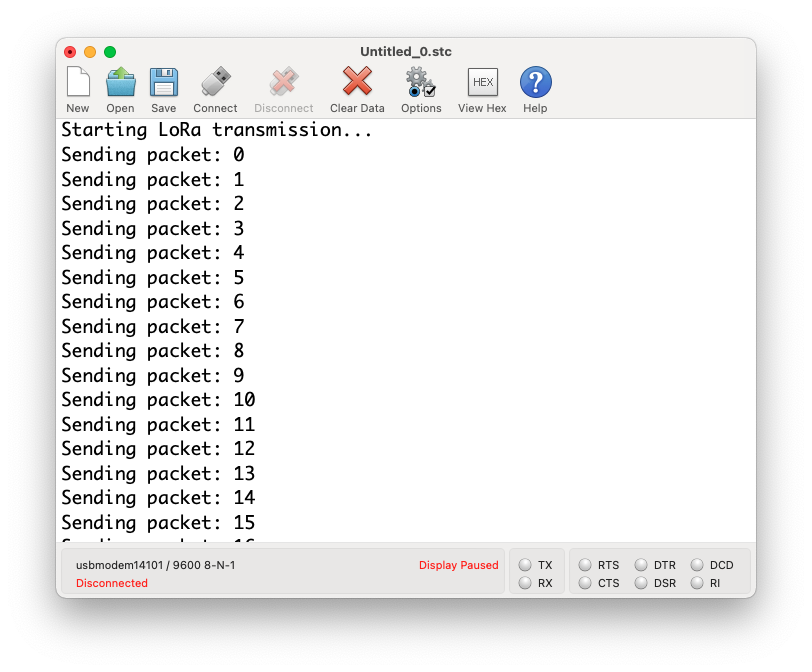
images/code/lora-tx-console.png
