hutscape/oak/images/design/subsystem.png

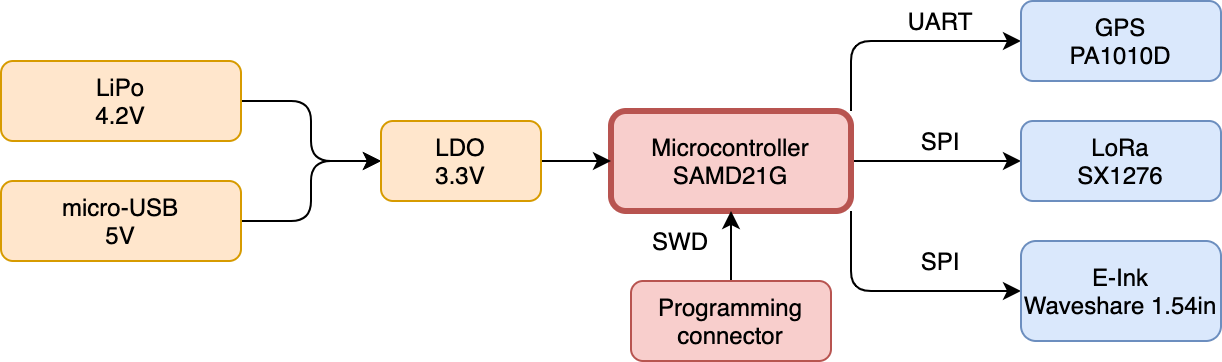
images/design/subsystem.png
