hutscape/oak/images/pcb/3dview-side2.png

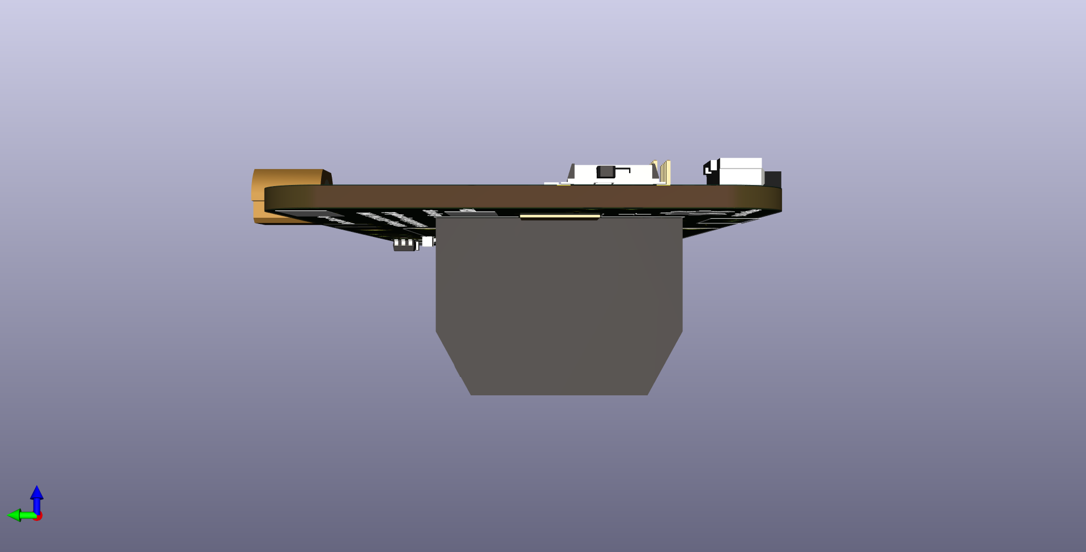
images/pcb/3dview-side2.png
