hutscape/oak/images/pcb/3dview-side3.png

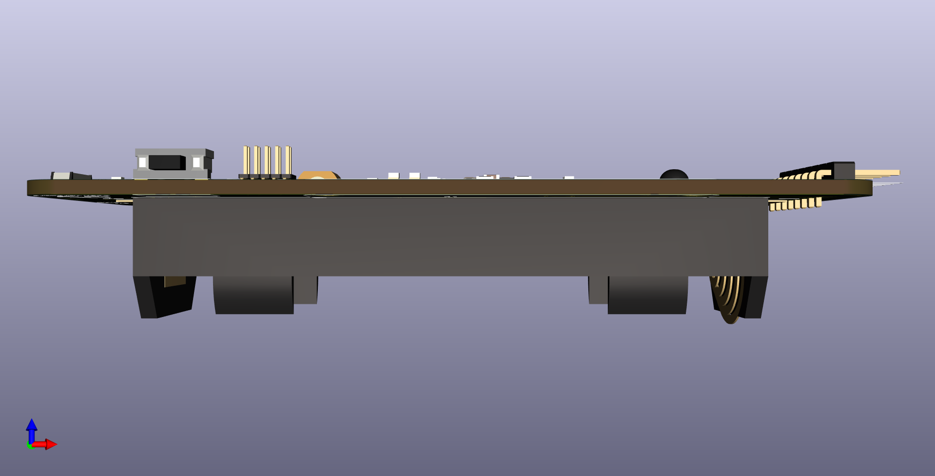
images/pcb/3dview-side3.png
