hutscape/oak/images/pcb/layout-back.png

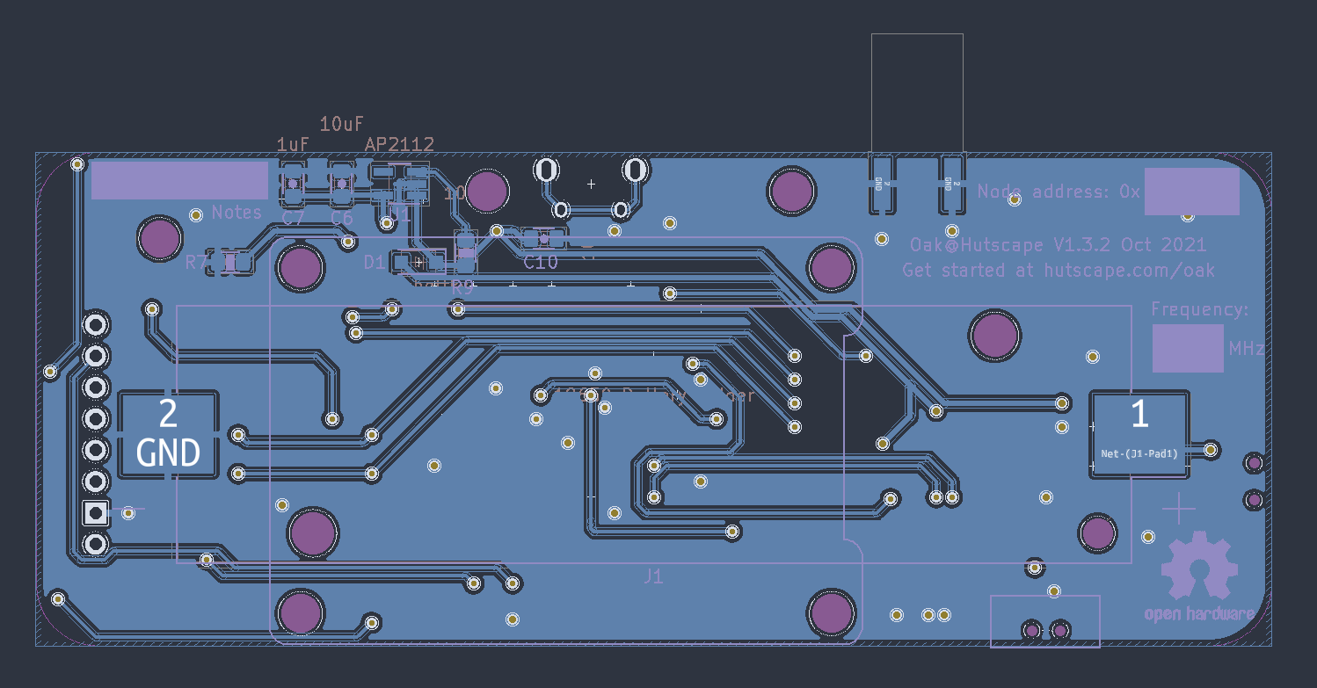
images/pcb/layout-back.png
