hutscape/oak/images/pcb/pcbway.png

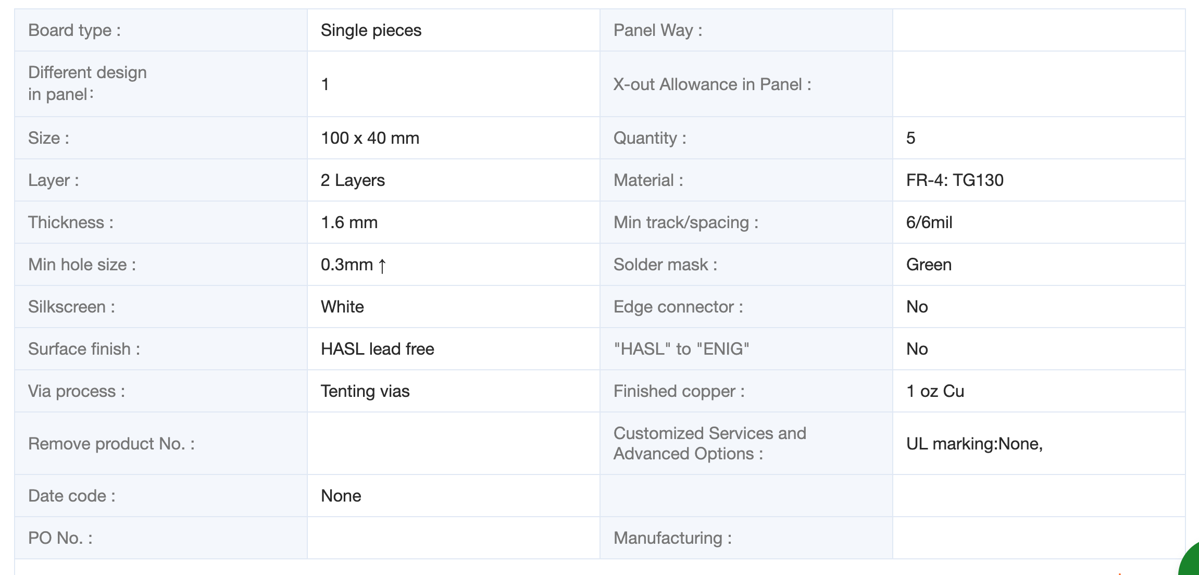
images/pcb/pcbway.png
