hutscape/oak/images/pcb/schematic.png

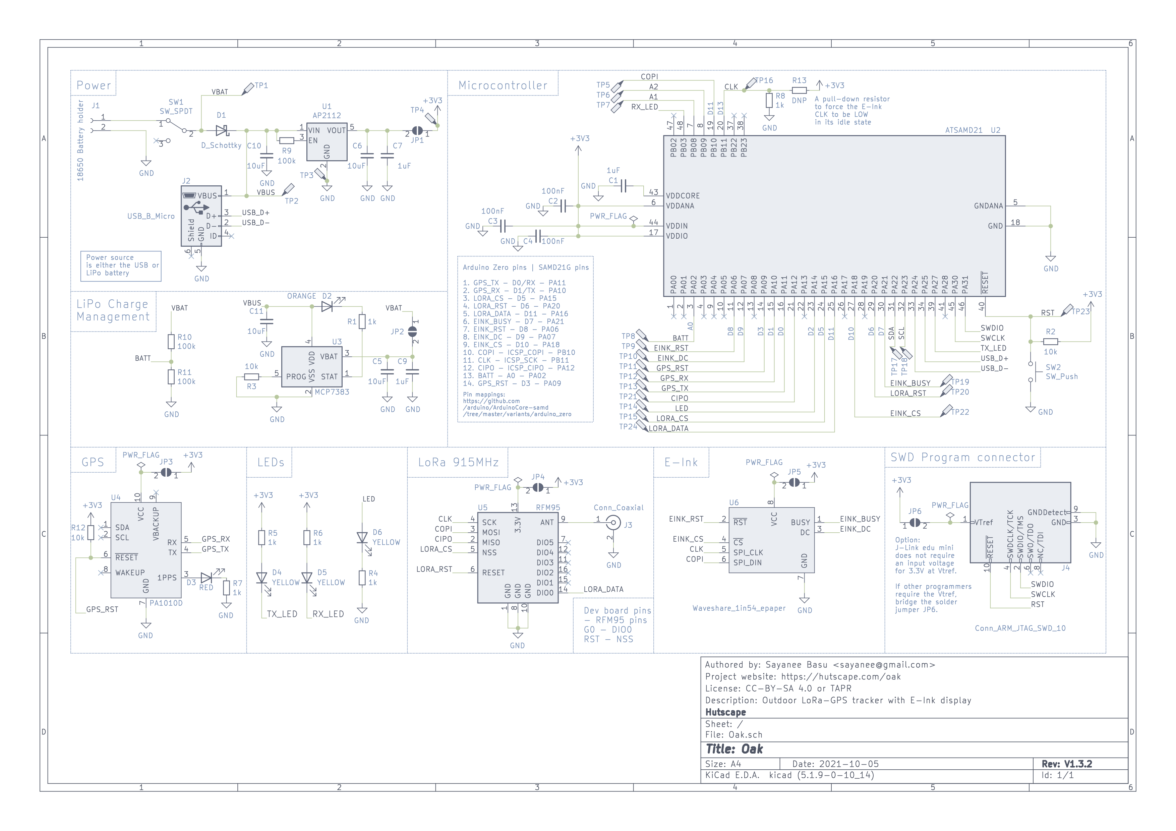
images/pcb/schematic.png
