hutscape/oak/images/prototype/side.jpg

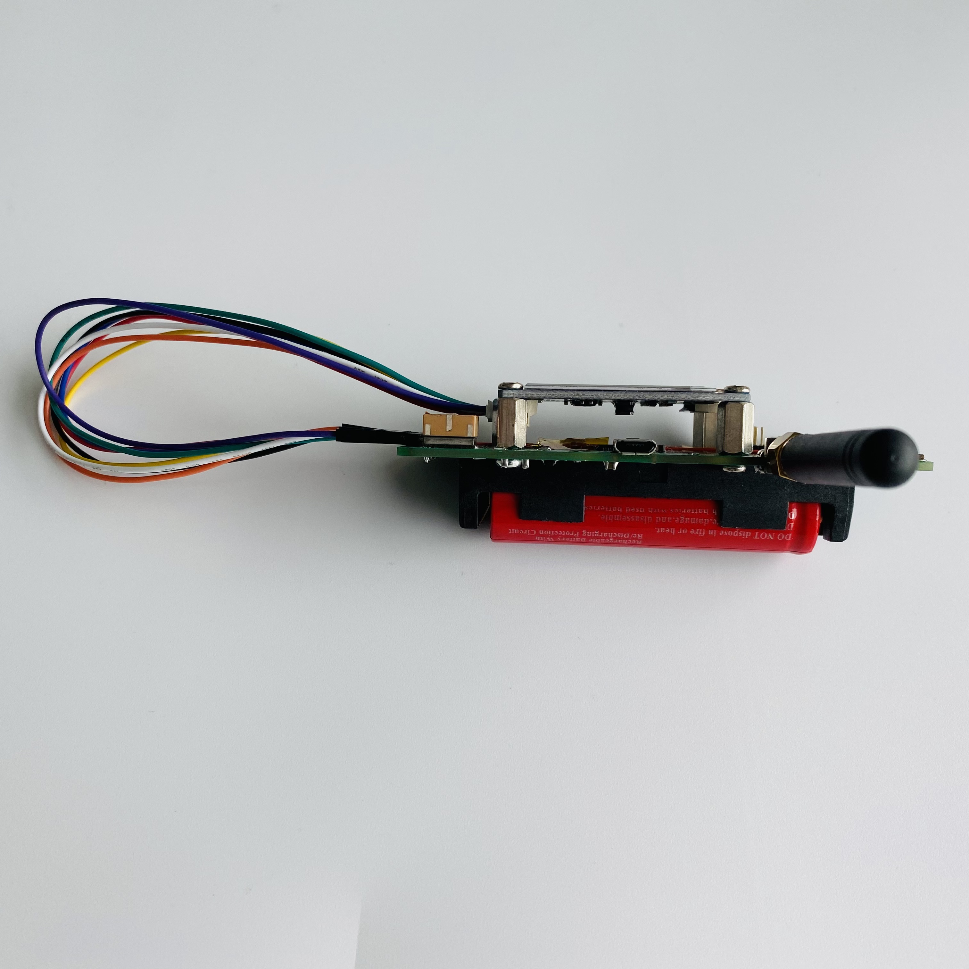
images/prototype/side.jpg
