hutscape/oak/images/prototype/top.jpg

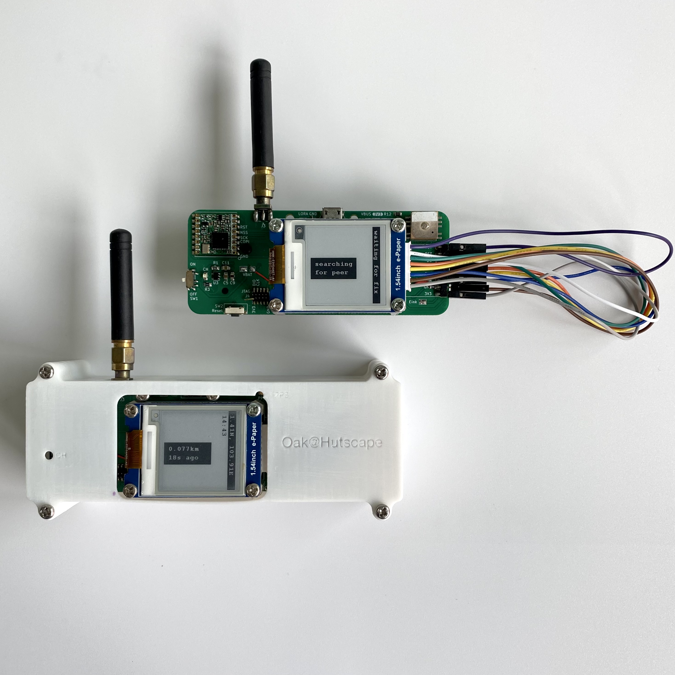
images/prototype/top.jpg
