hutscape/oak/images/lessons/buffer-components.png

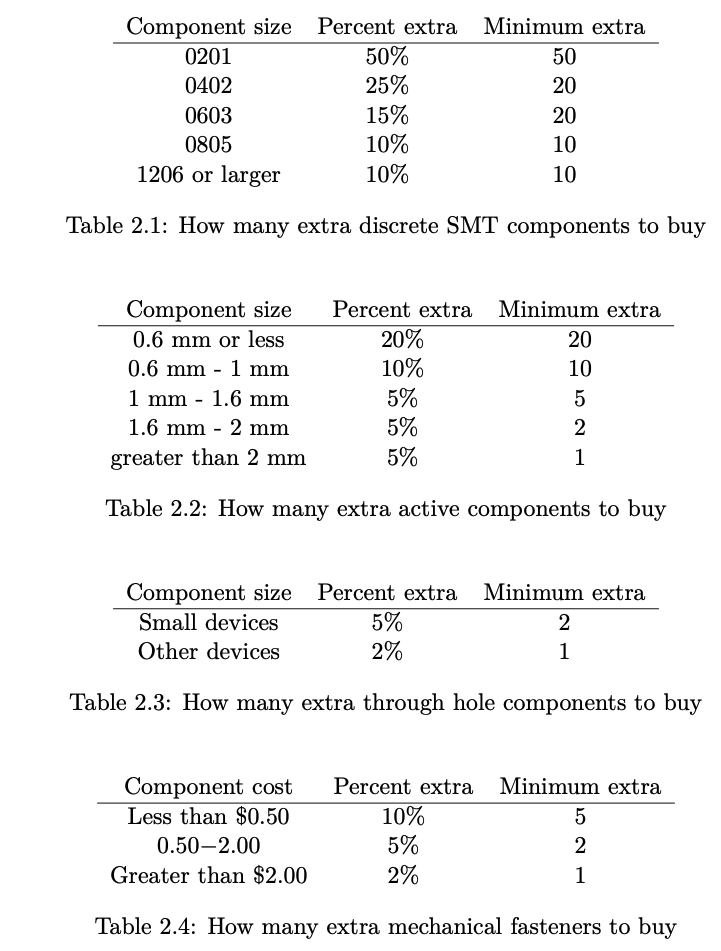
images/lessons/buffer-components.png
