hutscape/oak/case/exports/bottom.stl

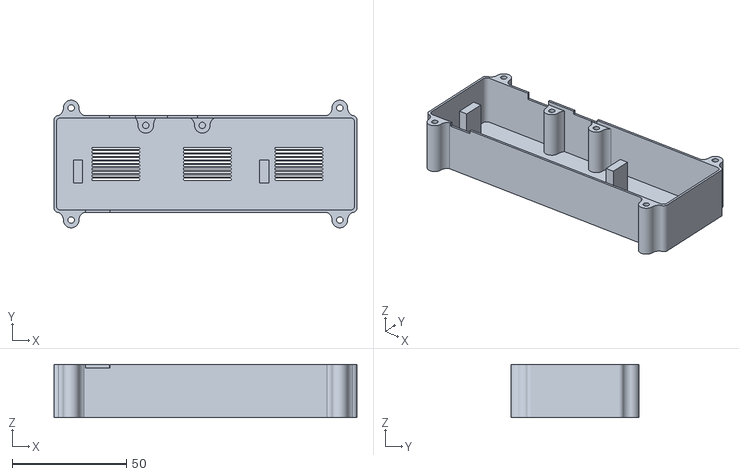
[picture p73: CAD file, 2022-06-06]
case/exports/bottom.stl
132.4 x 55.8 x 23.2
