hutscape/oak/mechanical/oak_case.FCStd

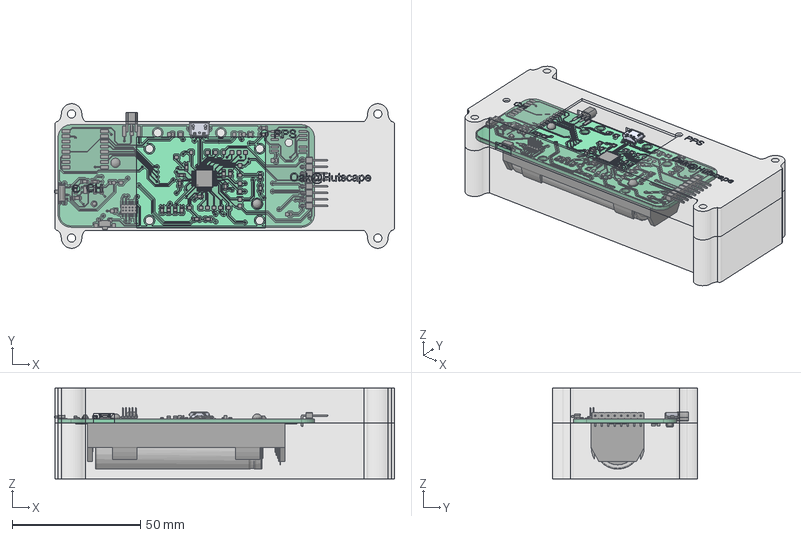
[picture p74: CAD file, 2022-05-18]
mechanical/oak_case.FCStd
132.6 x 56.3 x 35.4 mm
top x 2
bottom x 2
Pcb_d44a
topPads_d44a_cut
topTracks_d44a
topZones_d44a
botPads_d44a
botTracks_d44a
botZones_d44a
C1_C_0805_2012Metric_000060ab49ef x 10
D2_LED_0805_2012Metric_000060ab4be4 x 5
J2_molex_0473460001_000060ab4d59
J3_MMCX_Molex_73415-0961_Horizontal_000060ab4dbf
R1_R_0805_2012Metric_000060ab4f99 x 13
U3_SOT_23_5_000060ab5276 x 2
U2_TQFP_48_7x7mm_P05mm_000060ab539b
SW2_1TS003B v7_000060ab5508
U6_PinHeader_1x08_P254mm_Horizontal_000060ab5610
SW1_Fusion_sp_000060ab5b9a
J4_PinHeader_2x05_P127mm_Vertical_SMD_000060df08b5
D1_D_SOD_123F_0000608a719a
J1_Keystone_1042_1x18650_000060ab4cef
J1_18650_Generic_000060ab4cef[2]
