hutscape/oak/case/exports/case.stl

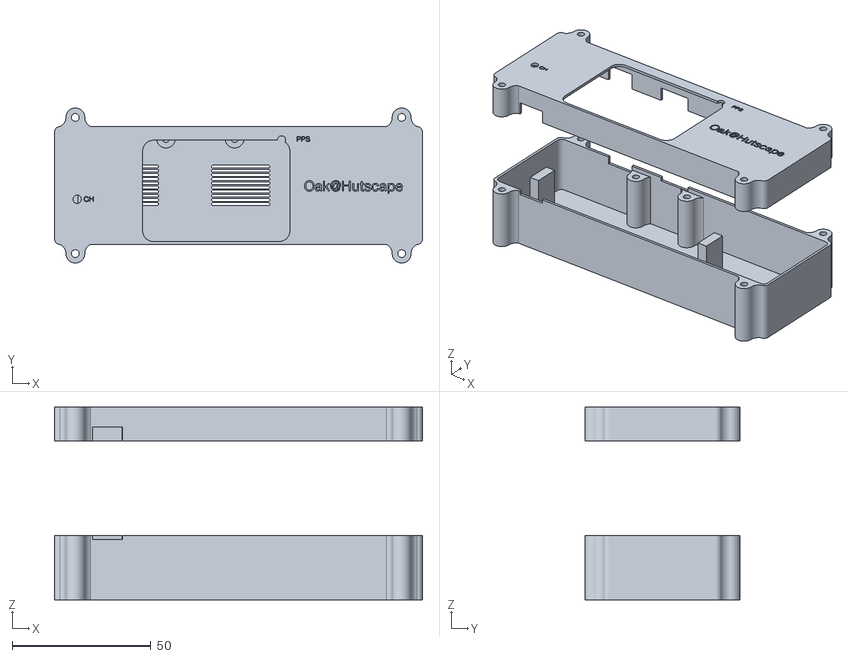
[picture p75: CAD file, 2022-06-03]
case/exports/case.stl
132.4 x 55.8 x 69.4
