hutscape/oak/case/exports/top.stl

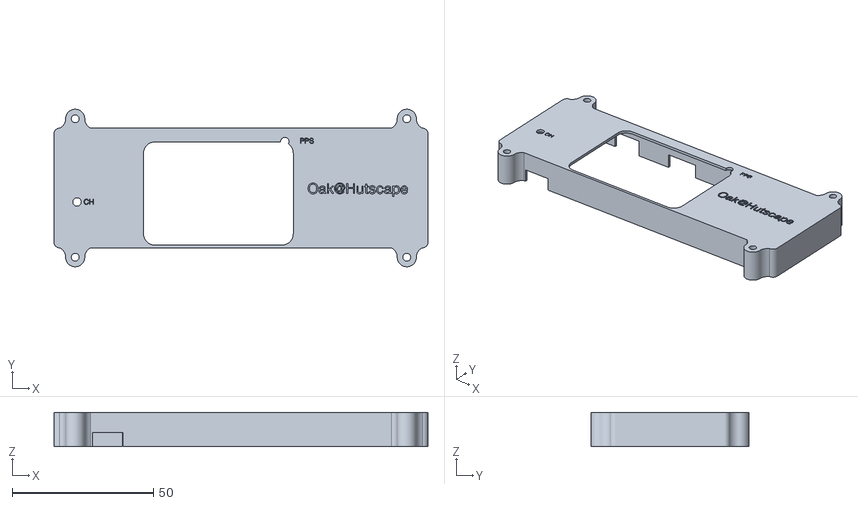
[picture p76: CAD file, 2022-06-03]
case/exports/top.stl
132.4 x 55.8 x 12.2
