hutscape/oak/start/step1.md

## Assemble the components

Screw in the E-Ink screen, the LoRa antenna and insert the 18650 battery at the back.

Final assembly

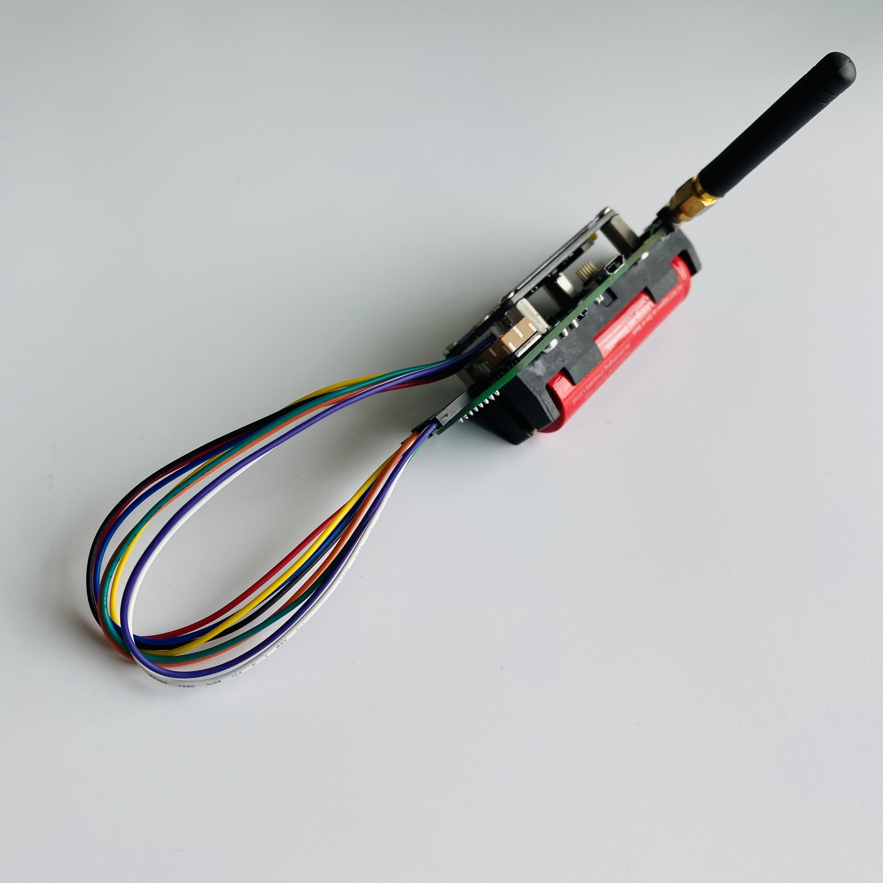
[picture p77: images/prototype/back.jpg]
With the battery
