hutscape/oak/start/step2.md

**[Option A]: Install new board in Arduino IDE**

[Copy and paste the JSON URL](https://raw.githubusercontent.com/hutscape/arduino-board-index/main/package_hutscape_index.json) into the File > Preferences > "Additional Boards Manager" textbox in Arduino IDE

Paste board URL

Restart Arduino IDE. Go to Tools > Boards Manager > Search for Hutscape or Oak

Install custom board

Installation of custom board is successful

**[Option B]: Use Makefile**

Run `make` to upload the sketch to the board.

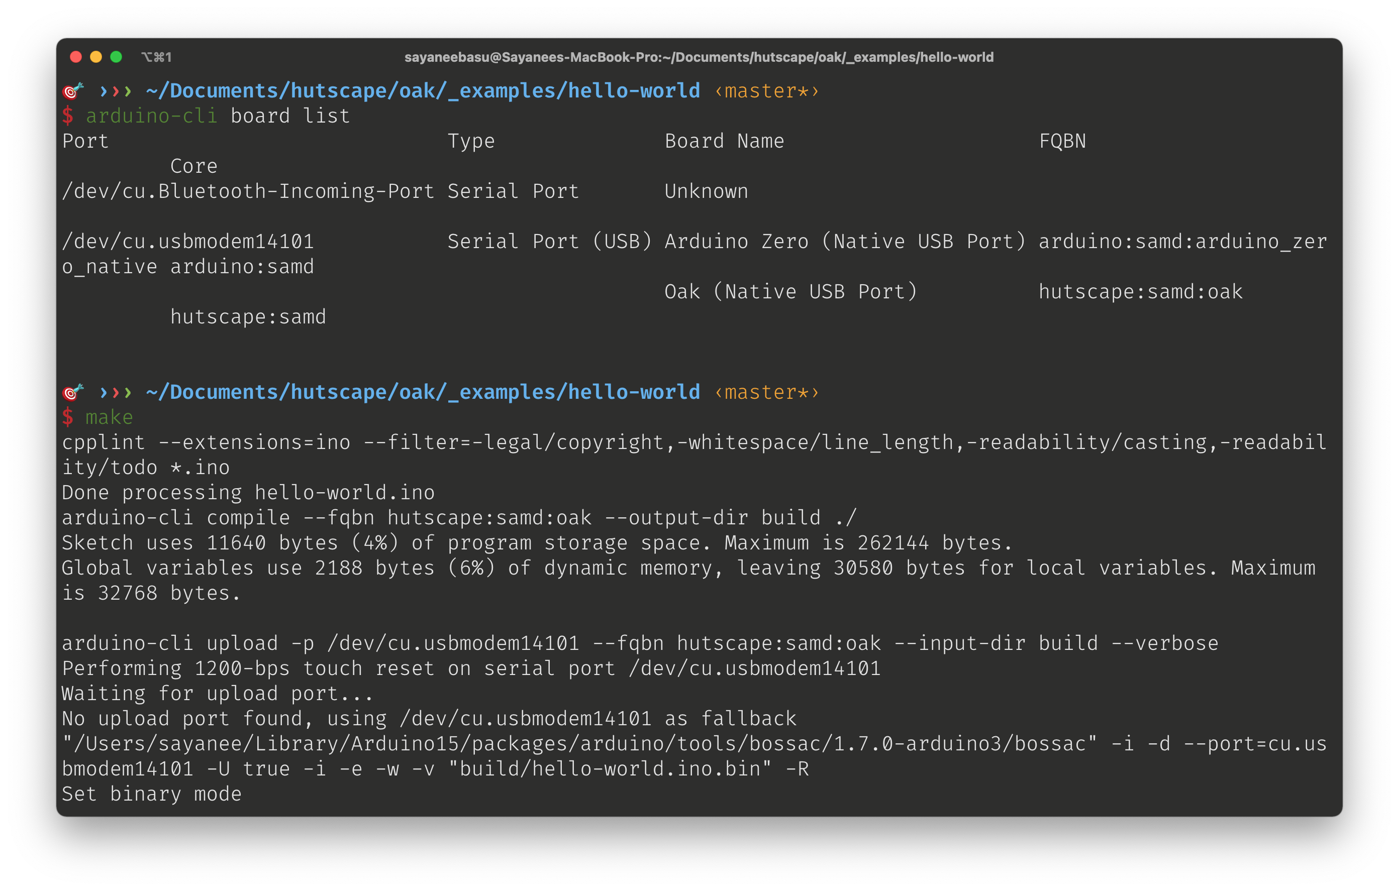
[picture p78: images/code/make-to-install.png]
Run the command make to upload the code to the board


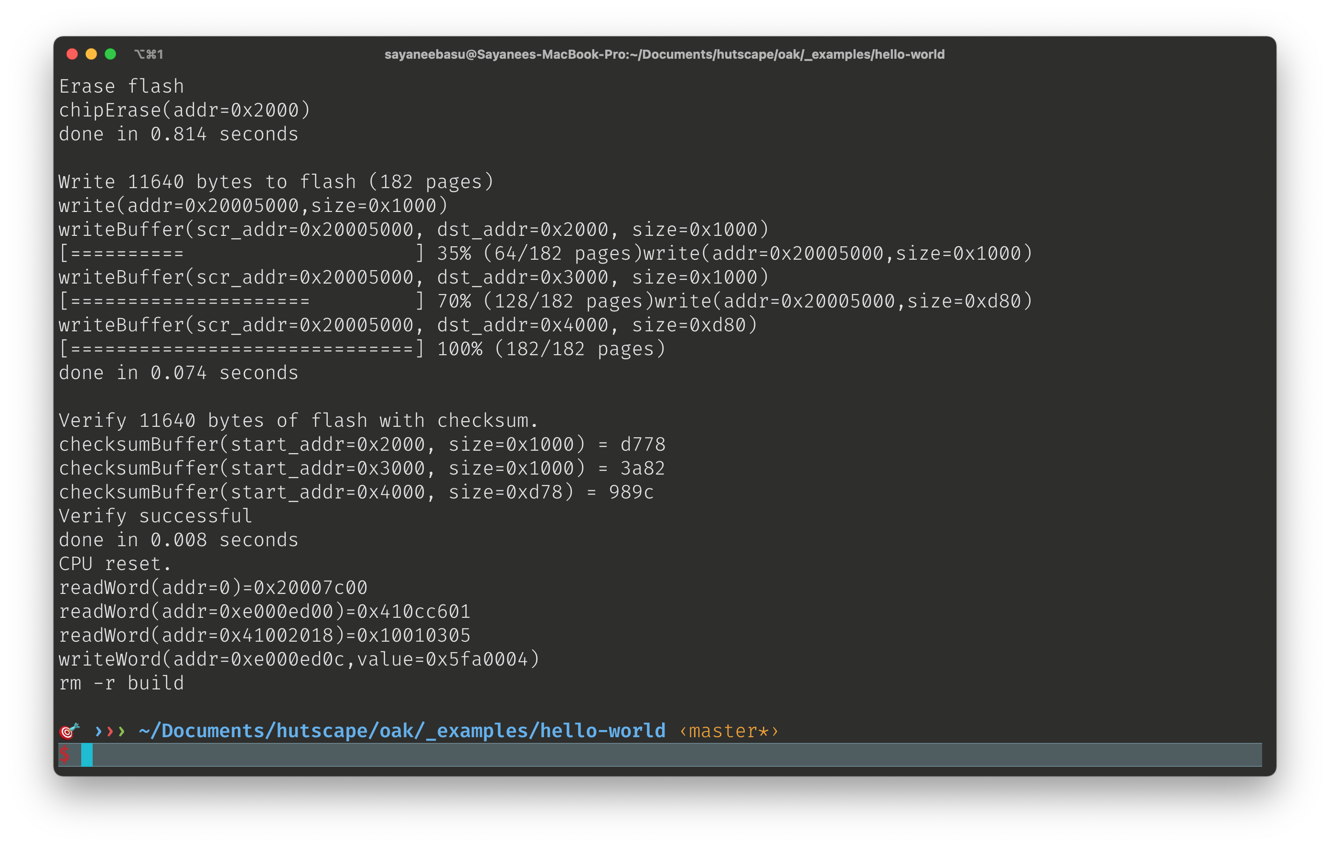
[picture p79: images/code/make-successful.png]
Successfully uploaded the code to the board
