hutscape/oak/start/step3.md

Try the [Blinky LED code]({{ site.url }}/code/hello-world) or other [code examples]({{ site.url }}/code).

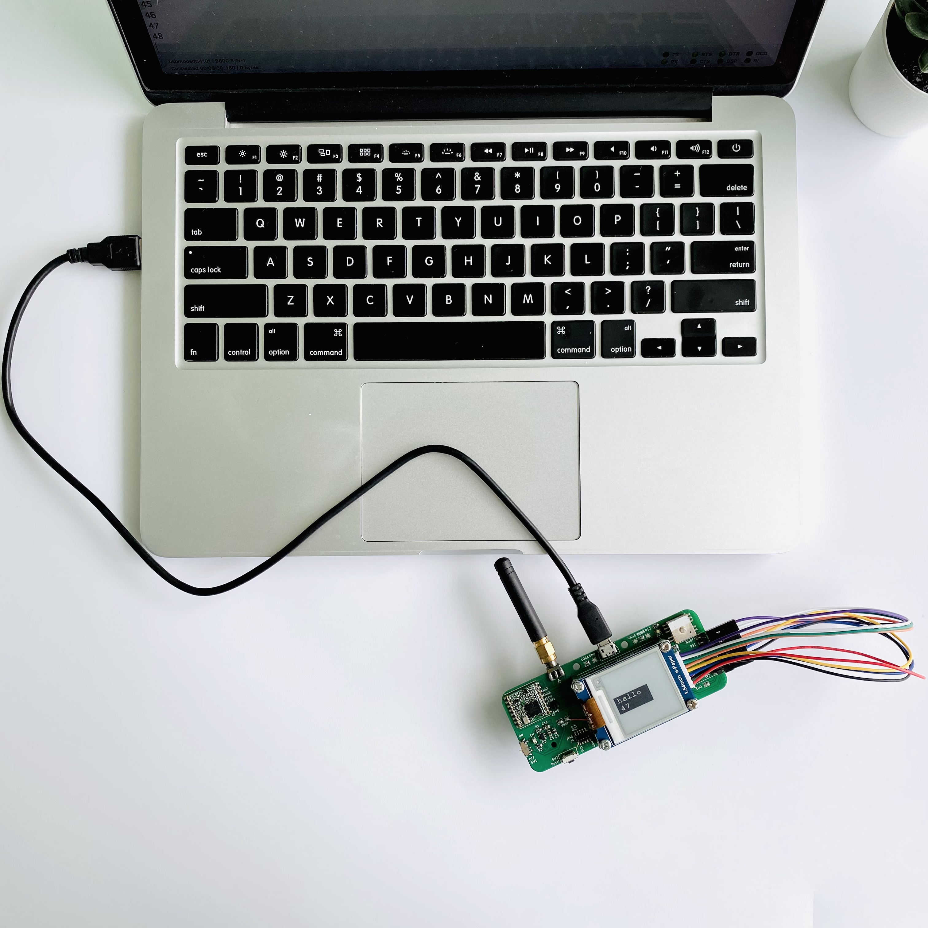
[picture p80: images/code/eink-prototype.jpg]
Typical setup


**[Option A]: Use Arduino IDE**

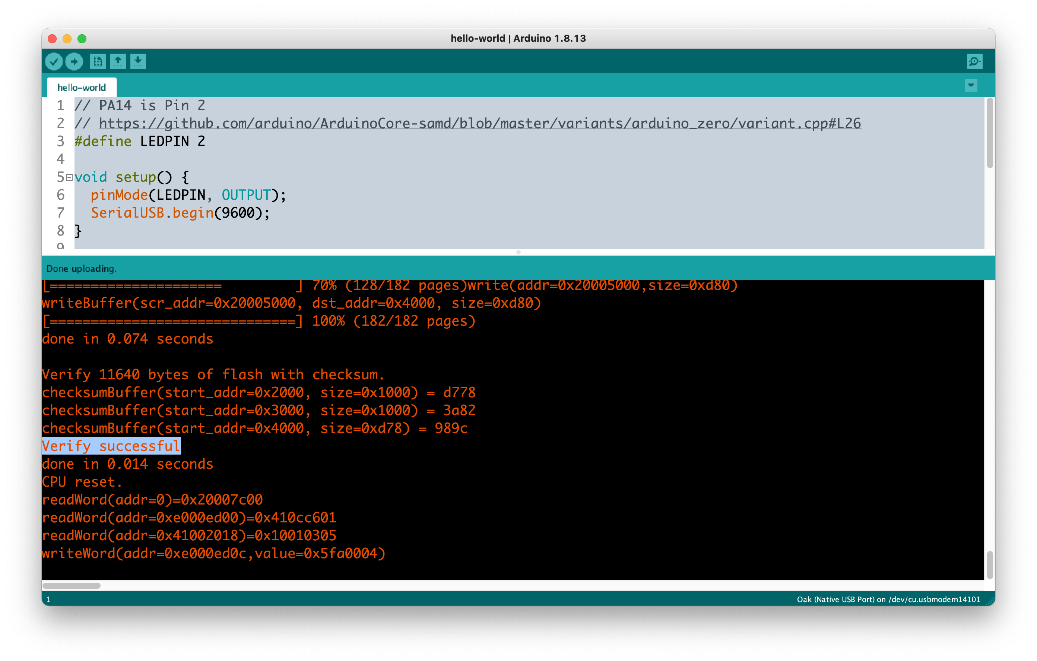
[picture p81: images/code/option-a-ide-blinky.png]
Use Arduino IDE to upload blinky firmware


**[Option B]: Use Makefile**

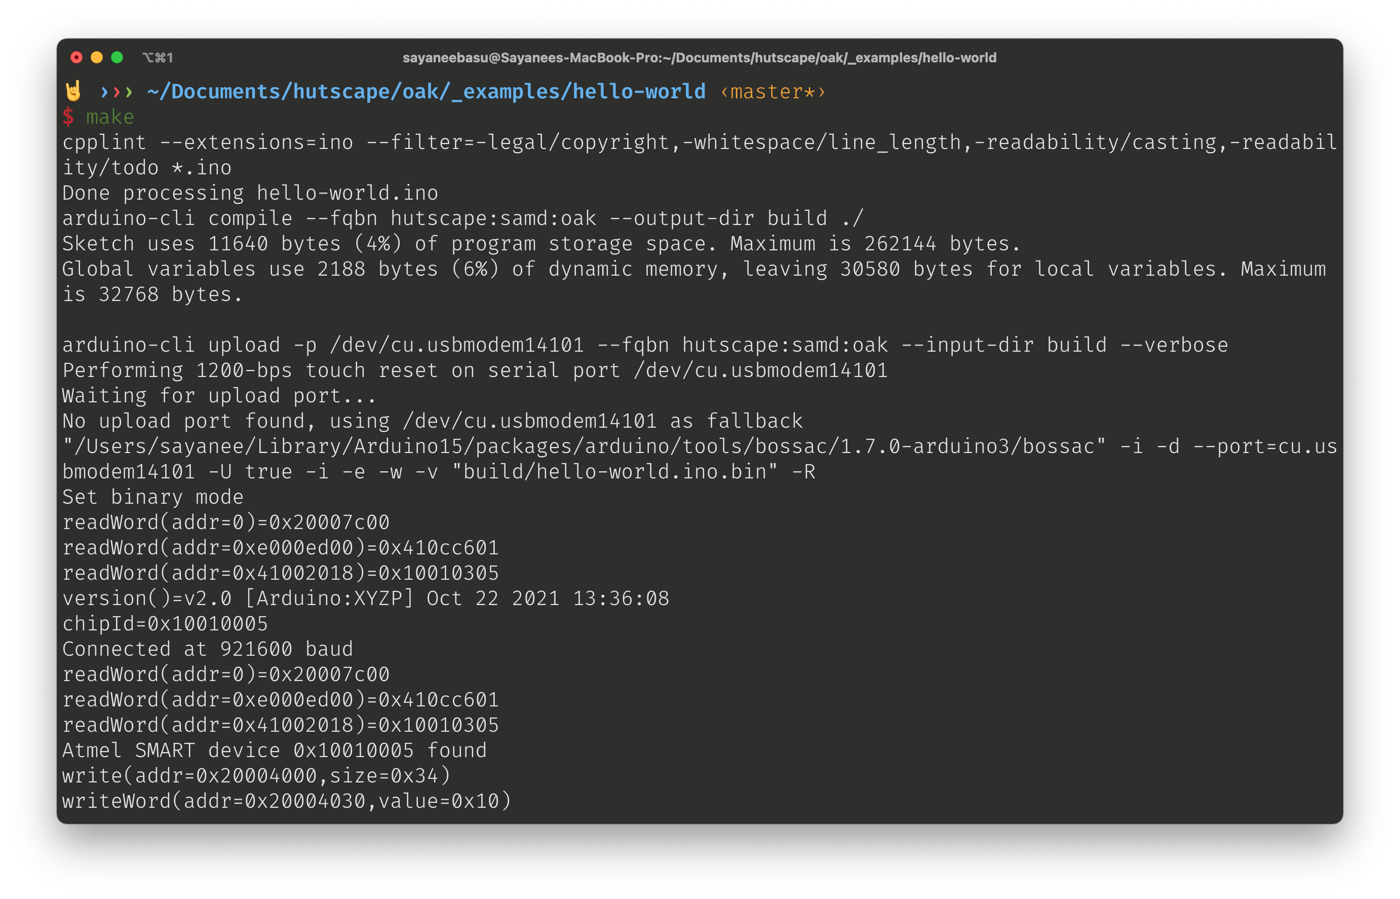
[picture p82: images/code/option-b-makefile-blinky.png]
Use Makefile to upload the blinky firmware
