hutscape/oak/images/case/manufacturing_params_case.png

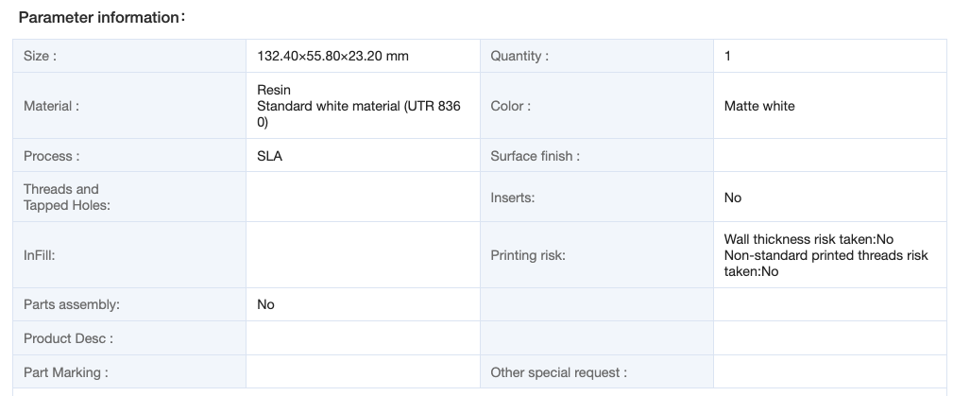
images/case/manufacturing_params_case.png
