hutscape/oak/images/code/print-hello-check.png

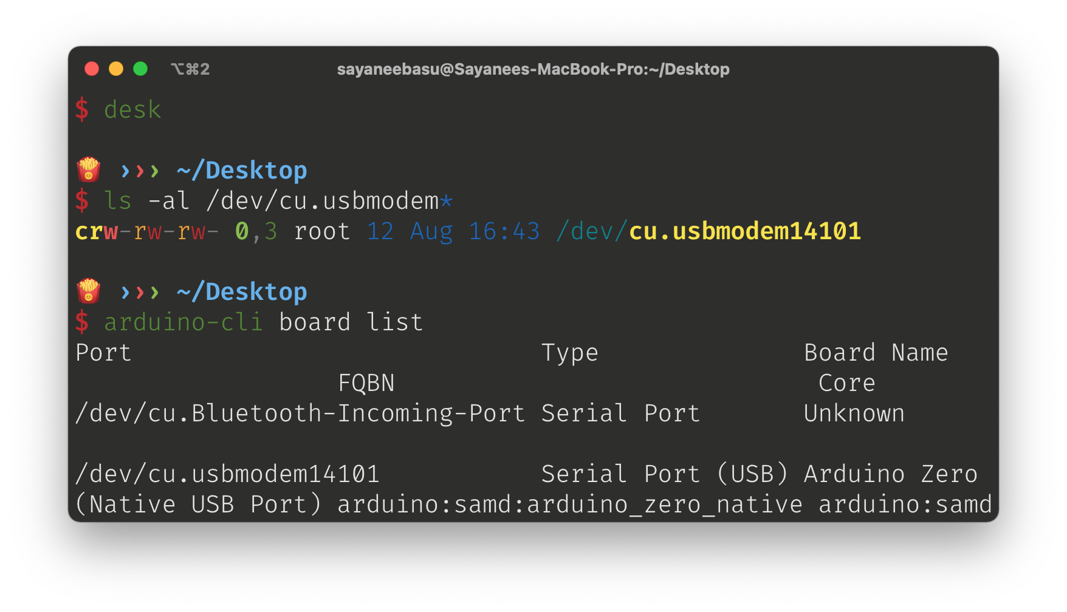
images/code/print-hello-check.png
