hutscape/oak/images/code/print-hello-console.jpg

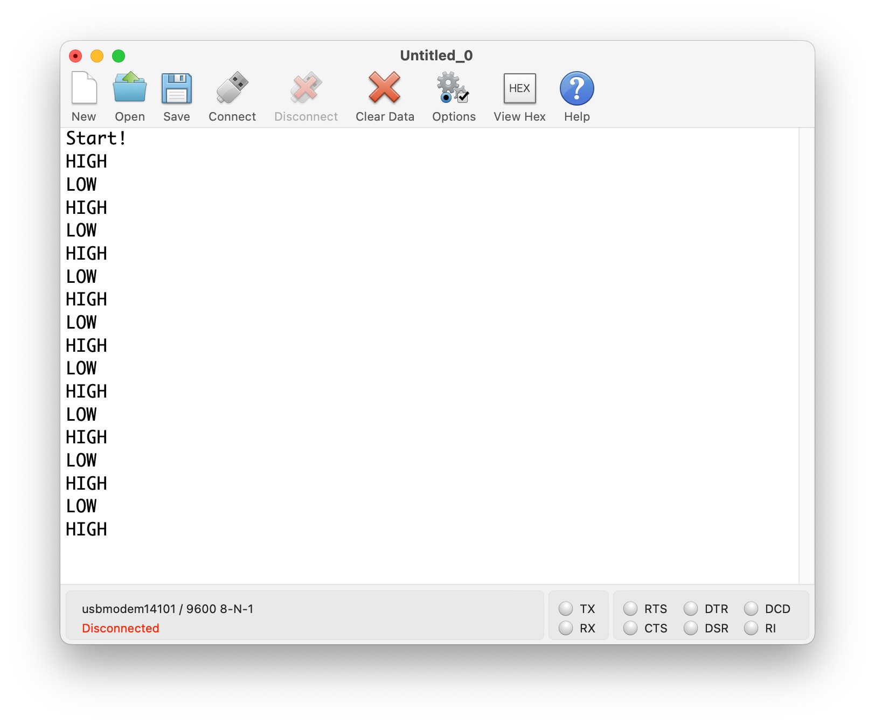
images/code/print-hello-console.jpg
