hutscape/oak/images/code/print-hello-prototype.jpg

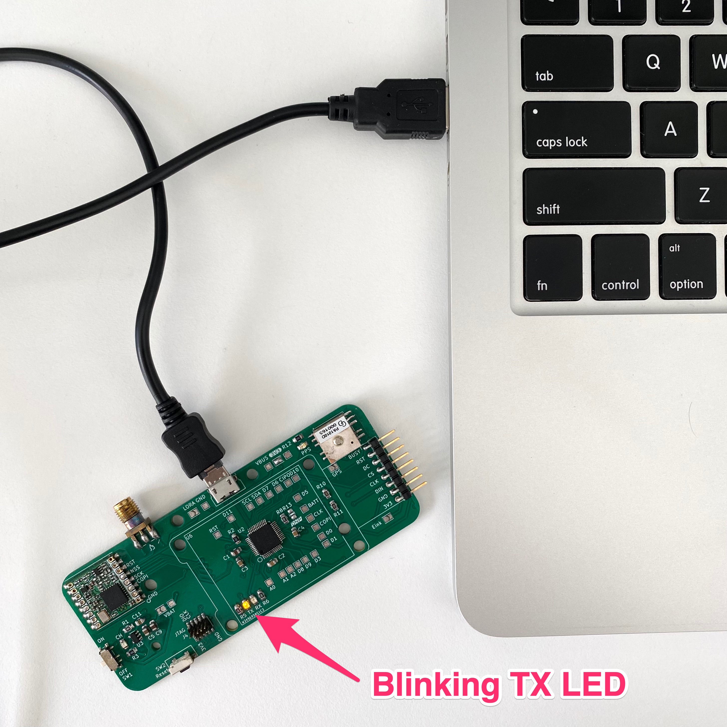
images/code/print-hello-prototype.jpg
