hutscape/oak/images/code/measure-batt-console.png

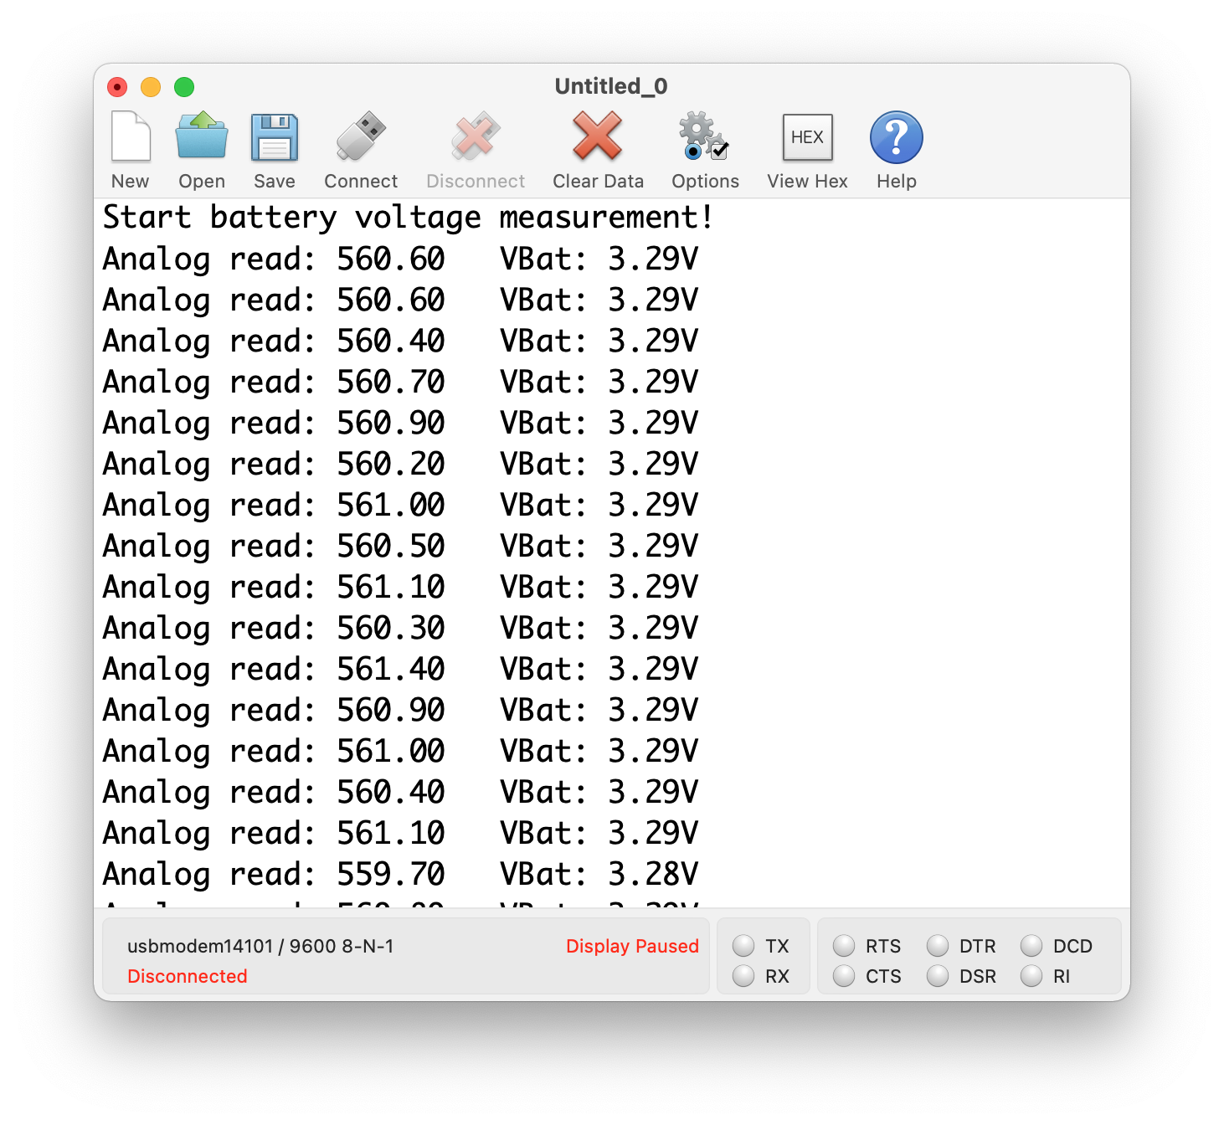
images/code/measure-batt-console.png
