hutscape/oak/images/code/measure-batt-prototype.jpg

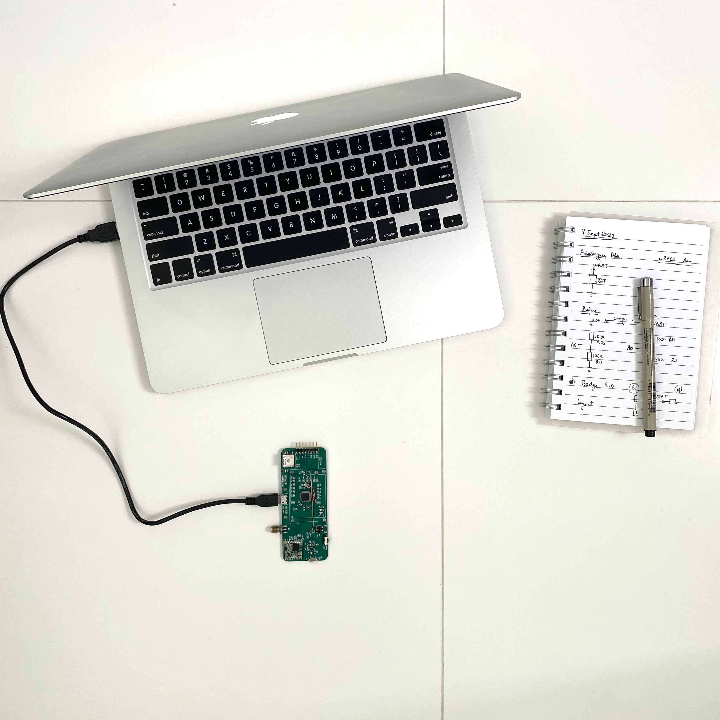
images/code/measure-batt-prototype.jpg
