hutscape/oak/images/code/demo-fix.jpg

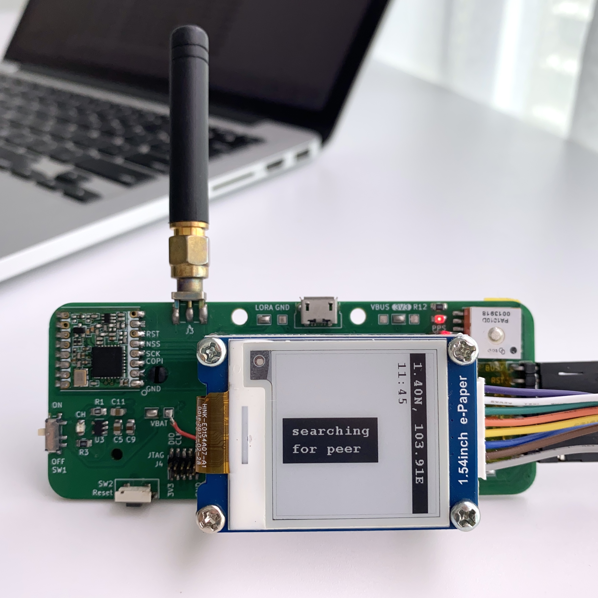
images/code/demo-fix.jpg
