hutscape/oak/images/code/gps-fix-parsed-console.png

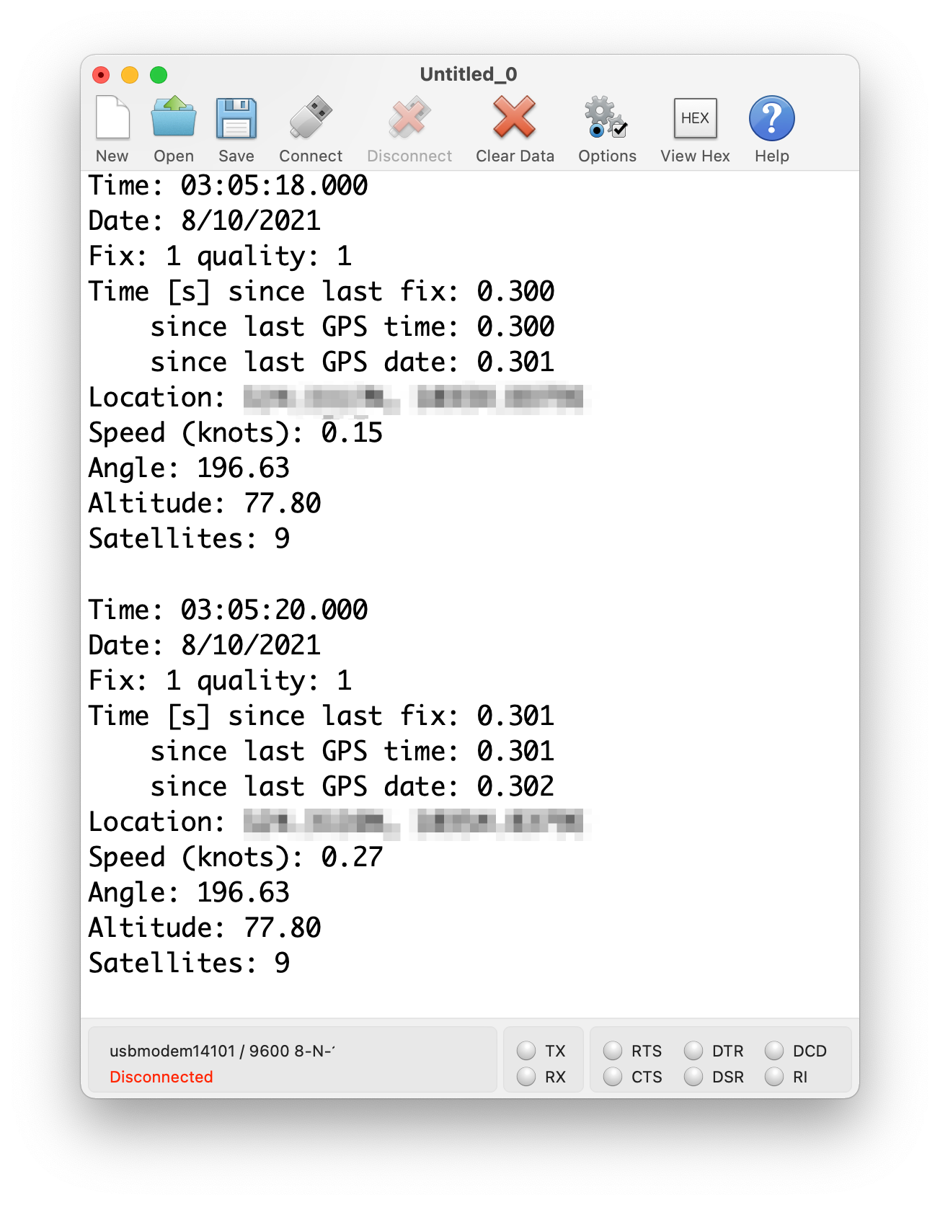
images/code/gps-fix-parsed-console.png
