hutscape/oak/images/code/gps-fix-pps-prototype.jpg

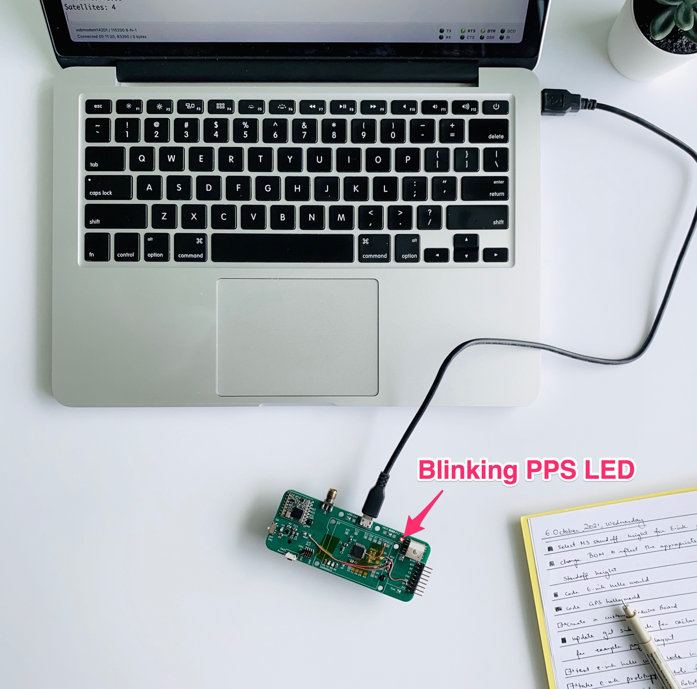
images/code/gps-fix-pps-prototype.jpg
