hutscape/oak/images/code/gps-fix-prototype.jpg

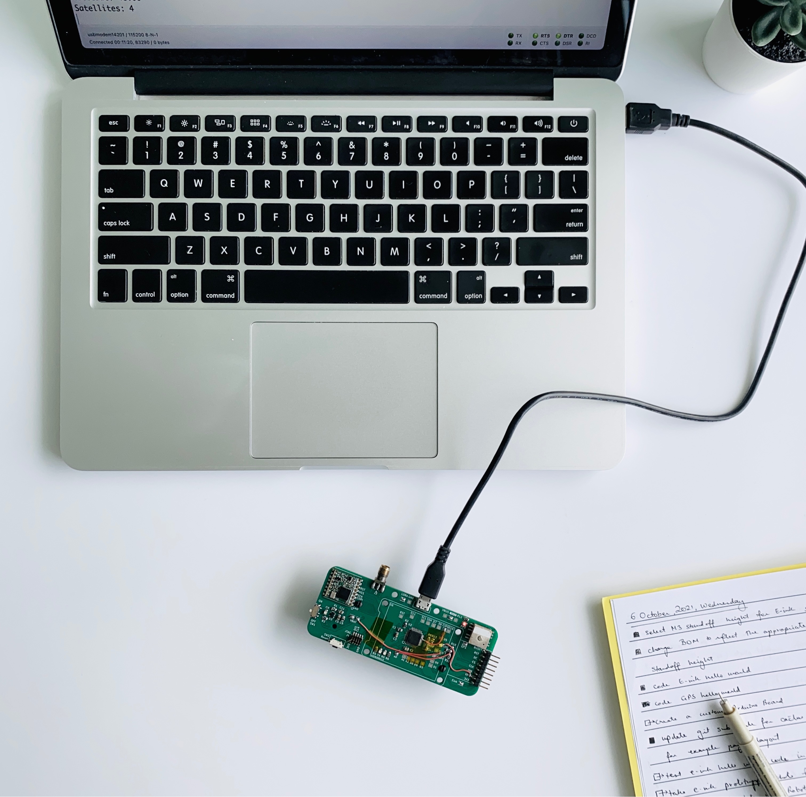
images/code/gps-fix-prototype.jpg
