hutscape/oak/(threads)

Thread 1 (2019-11-06):

Procure prototyping modules

sayanee, 2019-11-06:
- [x] e-Paper from **WaveShare** 🛍 [200x200, 1.54inch E-Ink display module](https://www.waveshare.com/product/modules/oleds-lcds/e-paper/1.54inch-e-paper-module.htm)
- [x] GPS from **CDtop** 🛍  [https://www.cdtop-tech.com/products/pa1010d](https://www.cdtop-tech.com/products/pa1010d)
- [x] LoRaWAN `433 MHz` module **2x**
- [x] Stub Antenna `433 MHz`**2x**

Closed 2019-11-14.

Thread 3 (2019-11-09):

Create KiCad symbols

sayanee, 2019-11-09:
- [ ] `SAMD21e` 32 pin MCU
- [x]  `PA1010D` GPS module https://github.com/hutscape/kicad-library/commit/a38da440d54bb685b3f3de71e0b6b5261362bc27
- [x] Waveshare E-Ink module
- [x] [Adafruit `RFM9x` module for `915MHz`](https://www.adafruit.com/product/3072) https://github.com/hutscape/kicad-library/commit/a48d0e883d3dca34b235705255e738e60b203e11

sayanee, 2020-11-17:
SAMD21E won'tbe used!

Closed 2020-11-17.

Thread 6 (2020-10-14):

LoRa module and E-Ink modules are not working together with SPI protocol

sayanee, 2020-10-14:
# Problem

LoRa module `RFM9x` and E-Ink module `Waveshare 1.54in` when connected together with the Arduino Zero board has an SPI conflict. Both the modules work with Arduino Zero separately, but not together.

Upon inspection, when the SPI CLK of the E-ink is removed, at the start of the firmware running, and then put back, both the modules work.

# Investigation

## LoRa init

### ❌  FAIL with connected E-Ink `CLK`

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

### ✅  PASS without E-Ink `CLK`

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

## LoRa Send once

### ❌  FAIL with connected E-Ink `CLK`

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

### ✅  PASS without E-Ink `CLK`

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

## Comparing Clocks

- MCU Clock
- LoRa Clock
- E-Ink Clock
- LoRa CS

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

## Solution

E-Ink SPI Clock is pulled down in its idle state.

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

Closed 2020-11-04.

Thread 8 (2020-11-17):

Improve schematic

sayanee, 2020-11-17:
- [x] add expansion headers
- [x] add decoupling capacitors
- [x] add open solder jumpers
- [ ] search for antenna
- [x] add both a pull-up and pulldown resistor to the `CLK` pin for SPI. Pullup can be a `DNP` option.
- [x] check SWD pin cable
- [ ] check resistor values for LEDs chosen by the part number

sayanee, 2020-11-24:
Add both pullup and pulldown resistor for `CLK` in SPI:

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

Closed 2021-08-28.

Thread 9 (2020-11-25):

Mechanical Design inspirations

sayanee, 2020-11-25:
## With display module

> From [JLCPCB Instagram](https://www.instagram.com/p/CHpVZnkrw62/)

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

## LoRa-Tracker

[LoRa Tracker](http://www.iot-partners.com/portfolio-view/lora-tracker/)

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

## LoRa Tracker Elektro Mag

[Electromag](urlhttps://www.elektormagazine.com/labs/lora-gps-tracker)

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

Closed 2022-02-07.

Thread 12 (2020-12-16):

Range test with LilyGO T-Beam

sayanee, 2020-12-16:
2 paths are being considered which are fairly under the open skies and line-of-sight communication is possible. Each ⚫   dot represents approximately `100m`.

- Node A: @sayanee
- Node B: @notthetup

## Path 1: 1km

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

## Path 2: 1.5km

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

sayanee, 2021-05-07:
Success ✅

Closed 2021-05-07.

Thread 16 (2021-05-07):

PCB Layout inspirations

sayanee, 2021-05-07:
1. E-Ink connector at the edge of PCB [[Voltlink](https://www.tindie.com/products/voltlog/voltlink-cp2104-usb-serial-adapter-programmer/)]
    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
1. Test pads right after the pins coming out of the MCU [[Teensy 3.6](https://www.pjrc.com/store/teensy36.html)]
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

sayanee, 2021-05-09:
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

Closed 2021-05-10.

Thread 18 (2021-05-12):

Create inverted background silkscreen labels

sayanee, 2021-05-12:
- [x] power
- [x] DNP

Using [KiBuzzard Plugin](https://github.com/gregdavill/KiBuzzard)

Closed 2021-05-13.

Thread 19 (2021-05-16):

PCB Layout last checks

sayanee, 2021-05-16:
- [x] Check `M3` screws and nuts availability 78b7137
- [x] JTAG cable connector availability - add in Partsbox
- [x] Use functional net labels on pads instead of Arduino Pin labels E.g. `LORA_CS` instead of `D3` a0e2b9b
- [x] Connect GPS `RX` for future extendability to `D1`. Use `D11` for `LORA_G0` instead. 7a5d818e5c7436708e9b4367bcd1ab8668949390 23f86b7b3f3c032da03c17efea6ce284f1aae85e 42659f1 42659f11b0c06addcae4dcf8d6b4f21eb892f04c
- [x] Export BOM
- [x] Add 4 `M3` screws, spacers and nuts, and battery 18650 to the BOM manually
- [x] Regenerate `bom.json` without `bom.py` / `make bom` b76ca47
- [x] Element14 parts are all available -  add component designators, internal stock references, vendor URLs in the order list
- [x] Put 2 M3 holes to hang the PCB 9c968f0
- [x] Check ON-OFF Silkscreen annotation from [the previous project](https://hutscape.com/pine/hardware)
https://github.com/hutscape/oak/issues/19#issuecomment-846532516
- [x] Collate all feedback from public forums
- [x] Generate Gerbers and add a stencil to the PCB Manufacturing order

sayanee, 2021-05-16:
Create courtyards around the 4 `M3` screws and ensure the DRC pass:

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

sayanee, 2021-05-16:
# JTAG Connector

1. J-Link Edu
2. 2x05 JTAG SMD pin connector
3. Breakout board from JTAG SMD pin connector to breadboard

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

sayanee, 2021-05-23:
# ON-OFF switch

- single-pole, dual throw `SPDT`
- Pin `2` and `1` are `ON`
- Pin `2` and `3` are `OFF`

## Current circuit

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

## Pine

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

## Palm

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

Closed 2021-05-24.

Thread 20 (2021-05-24):

Manufacturing and Ordering

sayanee, 2021-05-24:
- [x] Check PCBWay order for PCB manufacturing and stencil
- [x] Git tag as `V1.0` and cut a release with the Gerber files [V1.0 release tag](https://github.com/hutscape/oak/releases/tag/V1.0)
- [x] Consolidate / schedule Element14 order
- [x] Buy [solder paste](https://www.youtube.com/watch?v=hDb5f7cqqFY&t=343s) `Mechanic XGZ40`

Closed 2021-05-31.

Thread 24 (2021-06-29):

Bootloading SAMD21G MCU

sayanee, 2021-06-29:
## References

Tutorial on [Burning Arduino bootloader on MCU SAMD21G with J-Link Segger](https://hutscape.com/pine/examples/arduino-bootloader-samd21g)

## Tried

1. 2 PCBs
2. Programmer: J-Link Edu mini and J-Link Segger
3. Power supply: µUSB

## To test

- [x] Ensure MCU placement on the PCB is correct by cross-checking with the datasheet. Check the placement for all the 5 required `SWD` pins `SWDIO`, `SWDCLK`, `NREST`, `3.3V`, `GND`
- [x] Power the board with the *µUSB* and check the voltage for `3.3V` and `GND` at the MCU pins
- [x] Power the board with the *power supply* and check the voltage for `3.3V` and `GND` at the MCU pins. Note down the current draw.
    - One of the 2 boards will draw more as it already has some firmware loaded
- [x] Power the board externally and do not connect pin `1`, `Vtref` and try to upload the bootloader again with both the J-Links
- [x] Reflow the board with the hot air gun

## After the success

- [x] Fix the PCB layout to add an open solder jumper option for connecting the `Vtef` pin on SWD https://github.com/hutscape/oak/commit/e99ad76a2488326ad66329fad5527c1d7461702f
- [x] Create tutorial for burning Arduino Zero bootloader on SAMD21G with J-Link Edu Mini

sayanee, 2021-06-30:
## Node A

- `SWCLK` does not pass the continuity test
- Measured slightly lower current `0.024A` with the power supply
    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

## Node B

- Measure slightly higher current `0.075A` with the power supply
    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
- Intermittently passed in downloading the bootloader code
    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
- Intermittently detected serial port `/dev/cu.usbmodem*`
    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

sayanee, 2021-06-30:
# Action

- Node A - reflow MCU and check `SWCLK` continuity
- Node B - reflow USB connector and check continuity for `USB+` and `USB-`

sayanee, 2021-07-01:
Burning the Arduino Zero bootloader on the board with J-Link Edu Mini is successful ✅

- [ ] Fix the PCB layout to add an open solder jumper option for connecting the `Vtef` pin on SWD

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

Closed 2021-10-07.

Thread 28 (2021-09-10):

Create a new custom Arduino board

sayanee, 2021-09-10:
## References

1. [Creating Custom Boards](https://www.instructables.com/Arduino-IDE-Creating-Custom-Boards/)
2. [Arduino CLI platform specifications](https://arduino.github.io/arduino-cli/0.19/platform-specification/)

sayanee, 2021-10-11:
# Steps

1. Find the variant location on Mac which is the same as the [GitHub repository](https://github.com/arduino/ArduinoCore-samd/tree/master/variants/arduino_zero)
    ```
    ~/Library/Arduino15/packages/arduino/hardware/samd/1.8.11/variants/arduino_zero
    ```

sayanee, 2021-10-12:
Close with new repositories created:

1. [hutscape-arduino-boards](https://github.com/hutscape/hutscape-arduino-boards)
2. [arduino-board-index](https://github.com/hutscape/arduino-board-index)

Thread 29 (2021-10-07):

WaveShare Version 2.1 does not work

sayanee, 2021-10-07:
## Background

| Board with SAMD21G | WaveShare module | Works?
| ------ | ------ | ------ |
| RobotDyn M0 Mini | Rev 1 | [Yes](https://hutscape.com/tutorials/waveshare-1in54-e-paper-samd21g)
| RobotDyn M0 Mini | Rev 2.1 | [Yes](https://hutscape.com/tutorials/waveshare-1in54-v2-e-paper-samd21g)
| Oak | Rev 1 | [Yes](https://hutscape.com/oak/examples/eink)
| Oak | Rev 2.1 | No

## Possible steps to debug

- [ ] Check [RobotDyn M0 Mini's schematic](https://robotdyn.com/pub/media/0G-00005516==SAMD21-MINI/DOCS/Schematic==0G-00005516==SAMD21-MINI.pdf) to see whether any of the used pins are connected differently
- [ ] Add the LoRa module on the RobotDyn setup to test the SPI pins
- [ ] Probe the `CLK` lines with logic analyzer on the RobotDyn setup and then Oak

sayanee, 2022-02-07:
Works

Closed 2022-02-07.

Thread 31 (2021-11-22):

Intermittent errors in PCB A

sayanee, 2021-11-22:
# PCB A

These errors do not happen in PCB `B`

- [x] Serial monitor stops after printing the first line in LoRa P2P demo code
    - Change to a good data + power uUSB cable
- [x] ~~`CH` Charging Red LED flickers even when there is no battery attached~~
    - Happens for both the PCBs
- [x] `PPS` LED for GPS does not light up even after a fix
    - `1PPS` pin from the module `PA1010D` was not soldered properly
    - A reflow work fixed it ✅

Closed 2021-12-09.

Thread 33 (2022-02-07):

Range test

sayanee, 2022-02-07:
# Before going

<details>
  <summary>Checklist</summary>

- [ ]  Charge 2x 18650
- [ ]  Reset 2x E-Ink screens to blank
- [ ]  Mount and test 1x PCB onto the cycle 🚲
- [ ]  Charge laptop
- [ ]  Charge iPhone
- [ ]  Clear iPhone space for videos and photos
- [ ]  Set VS Code to high contrast theme
- [ ]  Set CoolTerm to high contrast theme
- [ ]  Set screen recording dimensions
</details>

# Packlist

<details>
  <summary>Project</summary>

- [ ] 1x Laptop 💻
- [ ] 2x Oak PCB
- [ ] 2x USB cables
- [ ] 1x pen
- [ ] 1x logbook
- [ ] 1x box to place `PCB #A`
- [ ] 1x Cycle with PCB mount for `PCB #B`
</details>

<details>
  <summary>Personal</summary>

- [ ]  2x Water Bottle 🍼
- [ ]  2x Hat + UV gear 🎩 👕
- [ ]  2x Sports shoes 👟
- [ ]  1x backpack 🎒
</details>

# On-site

<details>
  <summary>Sequence of events</summary>

- [ ]  📝  Start a manual logbook with timestamps
- [ ]  Initial switch on from “blank” screen to “waiting for GPS fix”
    - [ ]  🎥 Video of both PCBs
    - [ ]  🖼️ Photo of both PCBs
- [ ]  Received GPS fix and connected with peer node
    - [ ]  🎥 Video of the remaining PCB
    - [ ]  🖼️ Photo of PCB
- [ ]  Connect via serial console
- [ ]  Start recoding data to textfile in CoolTerm
- [ ]  Start cycling away with peer node `PCB #B`
- [ ]  Peer node going into the trees
    - [ ]  🎥 Video of the remaining PCB
    - [ ]  🖼️ Photo of PCB
    - [ ]  💻 Screencast of NOT receiving GPS with increasing time difference
- [ ]  At the highest distance at the bend
    - [ ]  🎥 Video of the remaining PCB
    - [ ]  🖼️ Photo of PCB
    - [ ]  💻 Screencast of receiving GPS with high distance
- [ ]  At the highest distance at the dam
    - [ ]  🎥 Video of the remaining PCB
    - [ ]  🖼️ Photo of PCB with the dam
    - [ ]  💻 Screencast of receiving GPS with the highest distance from the dam
</details>

sayanee, 2022-02-09:
## Future improvements

1. Hoist the stationary PCB on a tripod above the ground
2. Get a black lanyard
3. Get a small Gorillapod to mount onto random rods and poles on-site
4. Use a longer USB cable

sayanee, 2022-02-09:
## Log captured

[CoolTerm-Capture 2022-02-09 09-51-11.txt](https://github.com/hutscape/oak/files/8029119/CoolTerm-Capture.2022-02-09.09-51-11.txt)

Thread 34 (2022-02-09):

Ignore invalid GPS data sent from peer node

sayanee, 2022-02-09:
## Actual data

Example of corrupted GPS data received:

```
282820: Received data 1.49 04 ���ҙ �?0
�� <3 from 0xbb to 0xaa
284130: Send data 1.40841162,103.91712189 from 0xaa to 0xbb
284135: Haversine distance: 11384.310 km 0s ago
```

Haversine distance of `11384.310` km is invalid

## Possible solution

Use [CRC library](https://github.com/RobTillaart/CRC) with format `latitude,longitude,CRC`
