hutscape/oak/pcb/docs/schematic.pdf

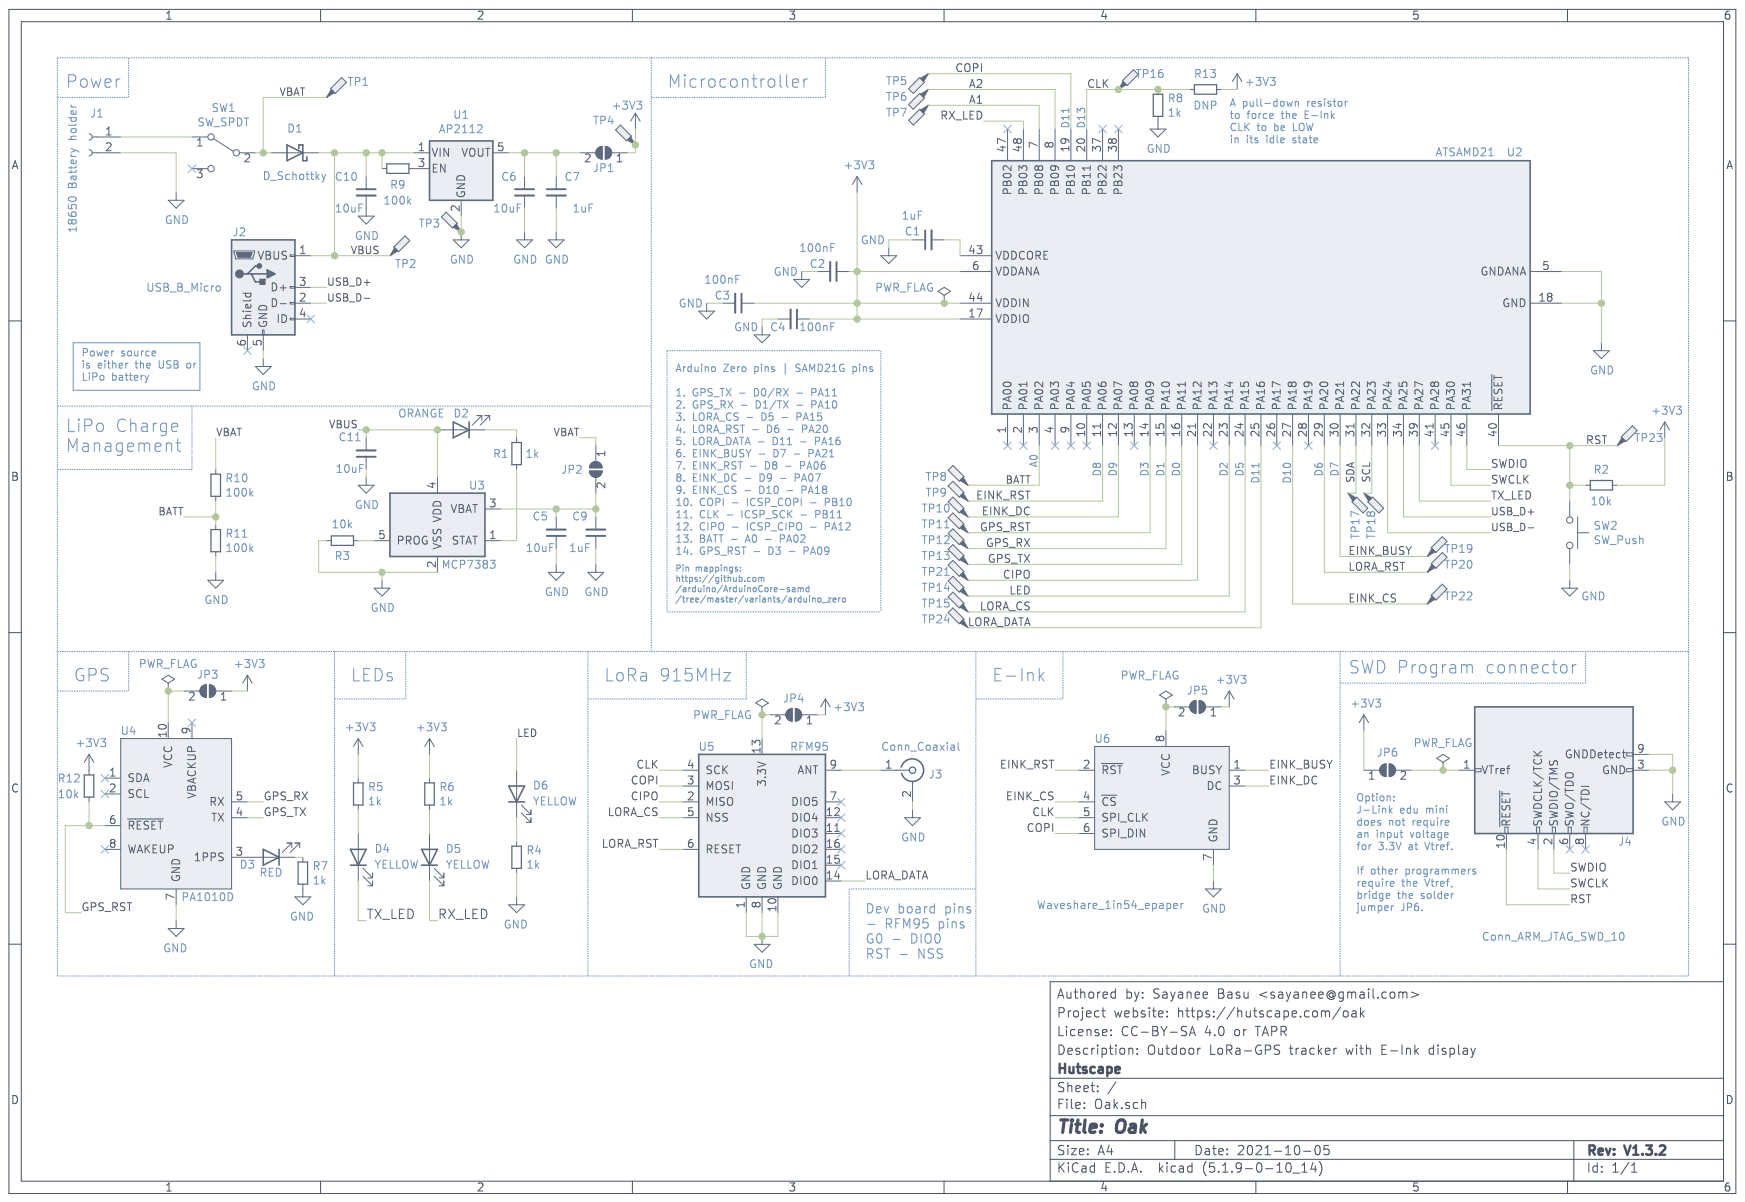
[picture p93: page 1]
