hutscape/oak/pcb/docs/layout.pdf

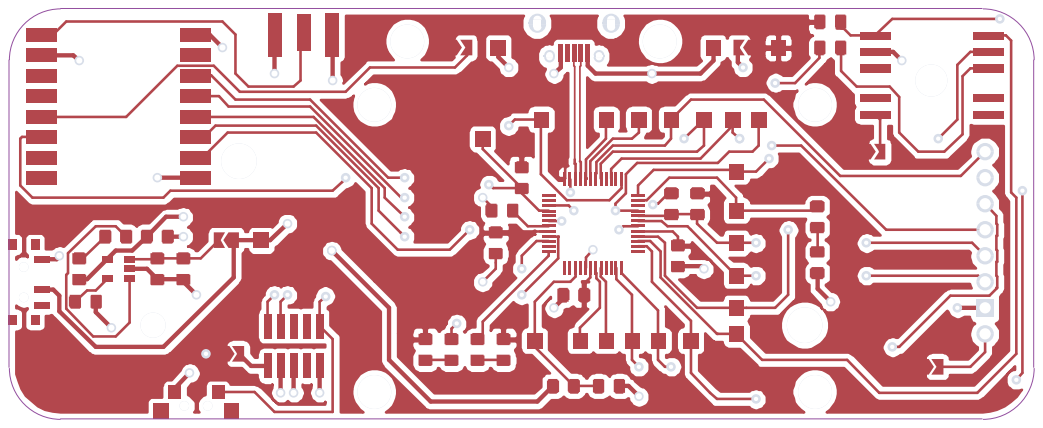
[picture p94: page 1]

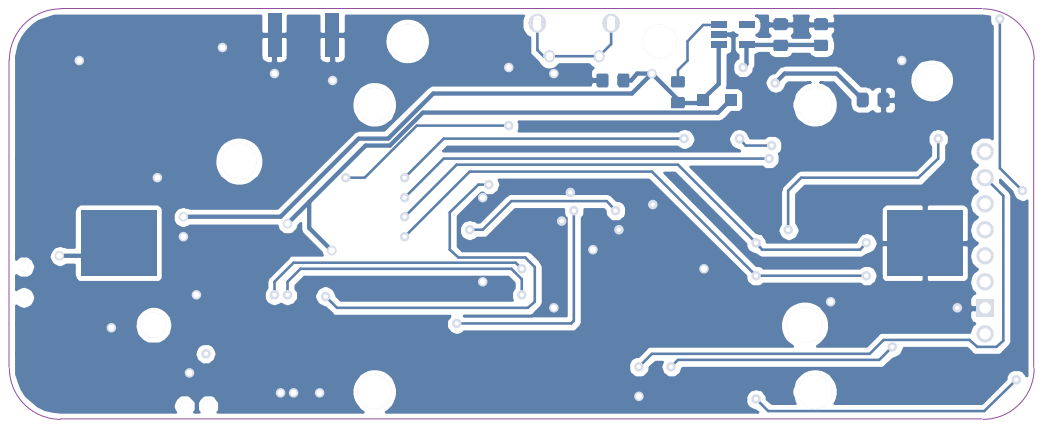
[picture p95: page 2]

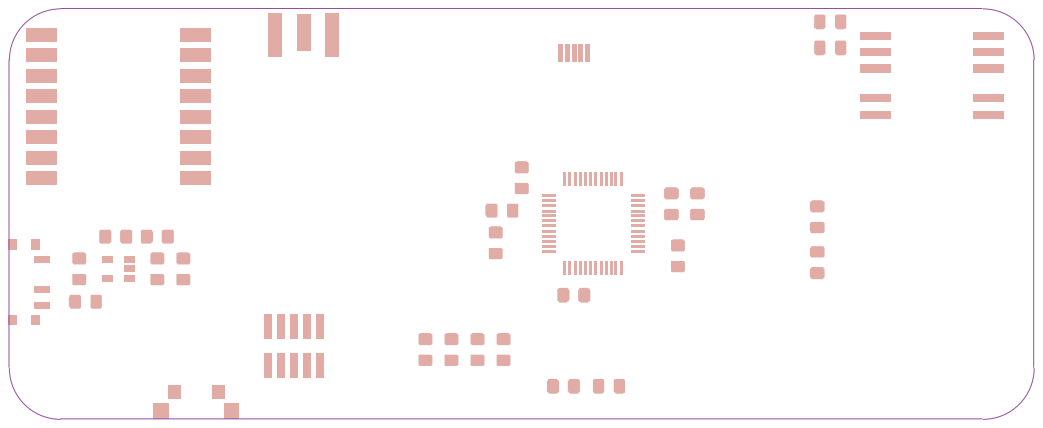
[picture p96: page 3]

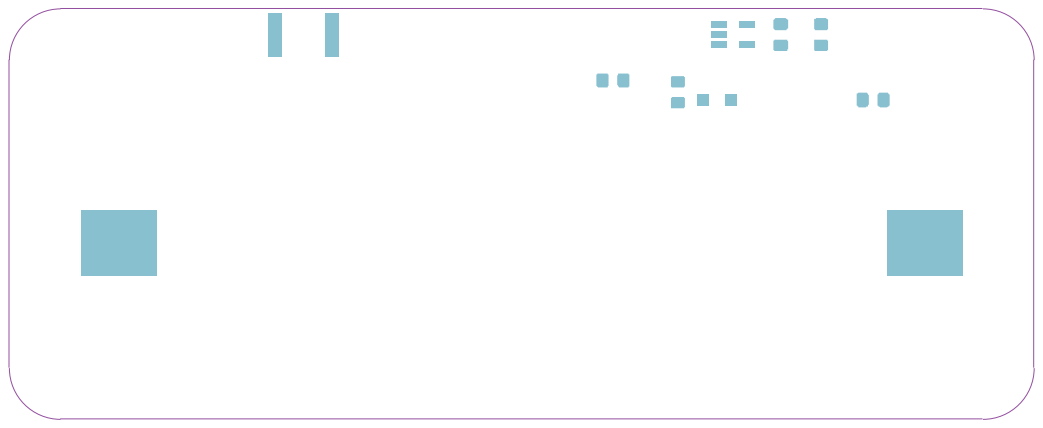
[picture p97: page 4]

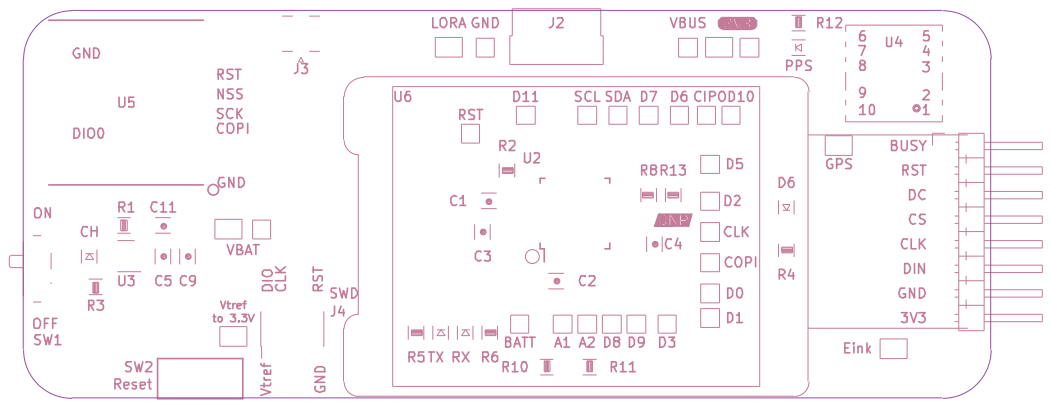
[picture p98: page 5]

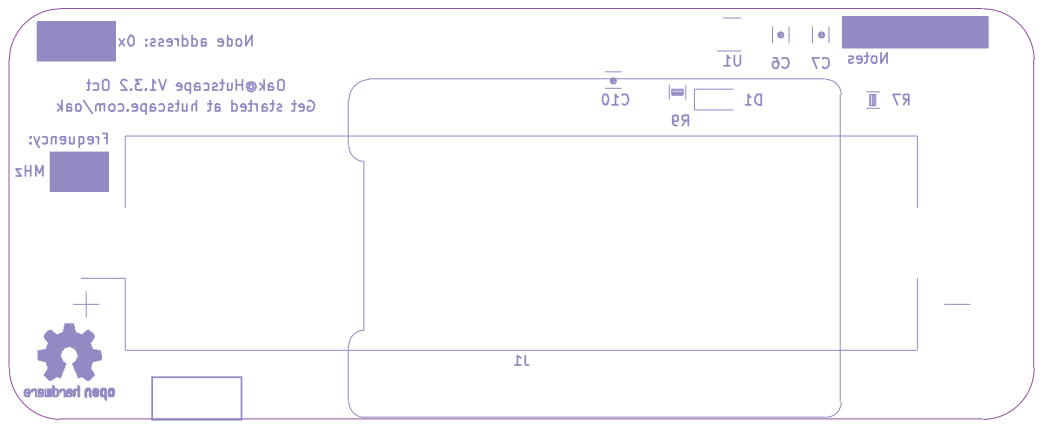
[picture p99: page 6]

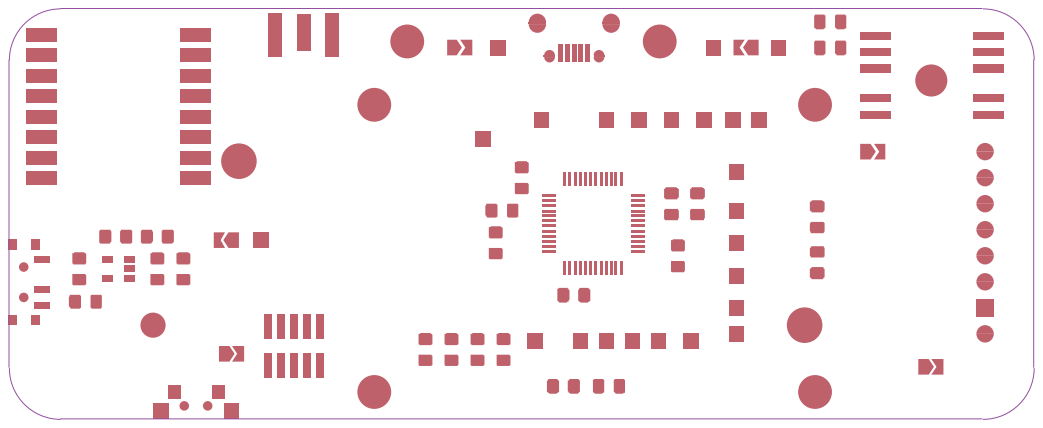
[picture p100: page 7]

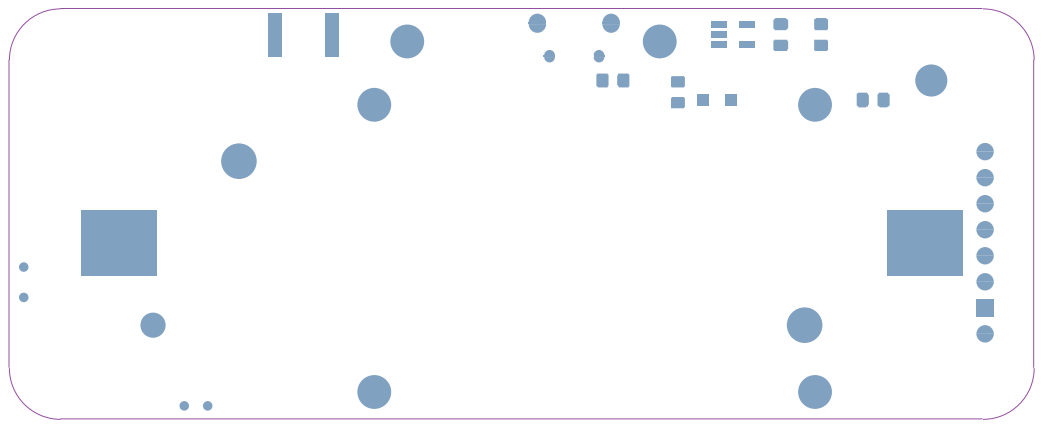
[picture p101: page 8]

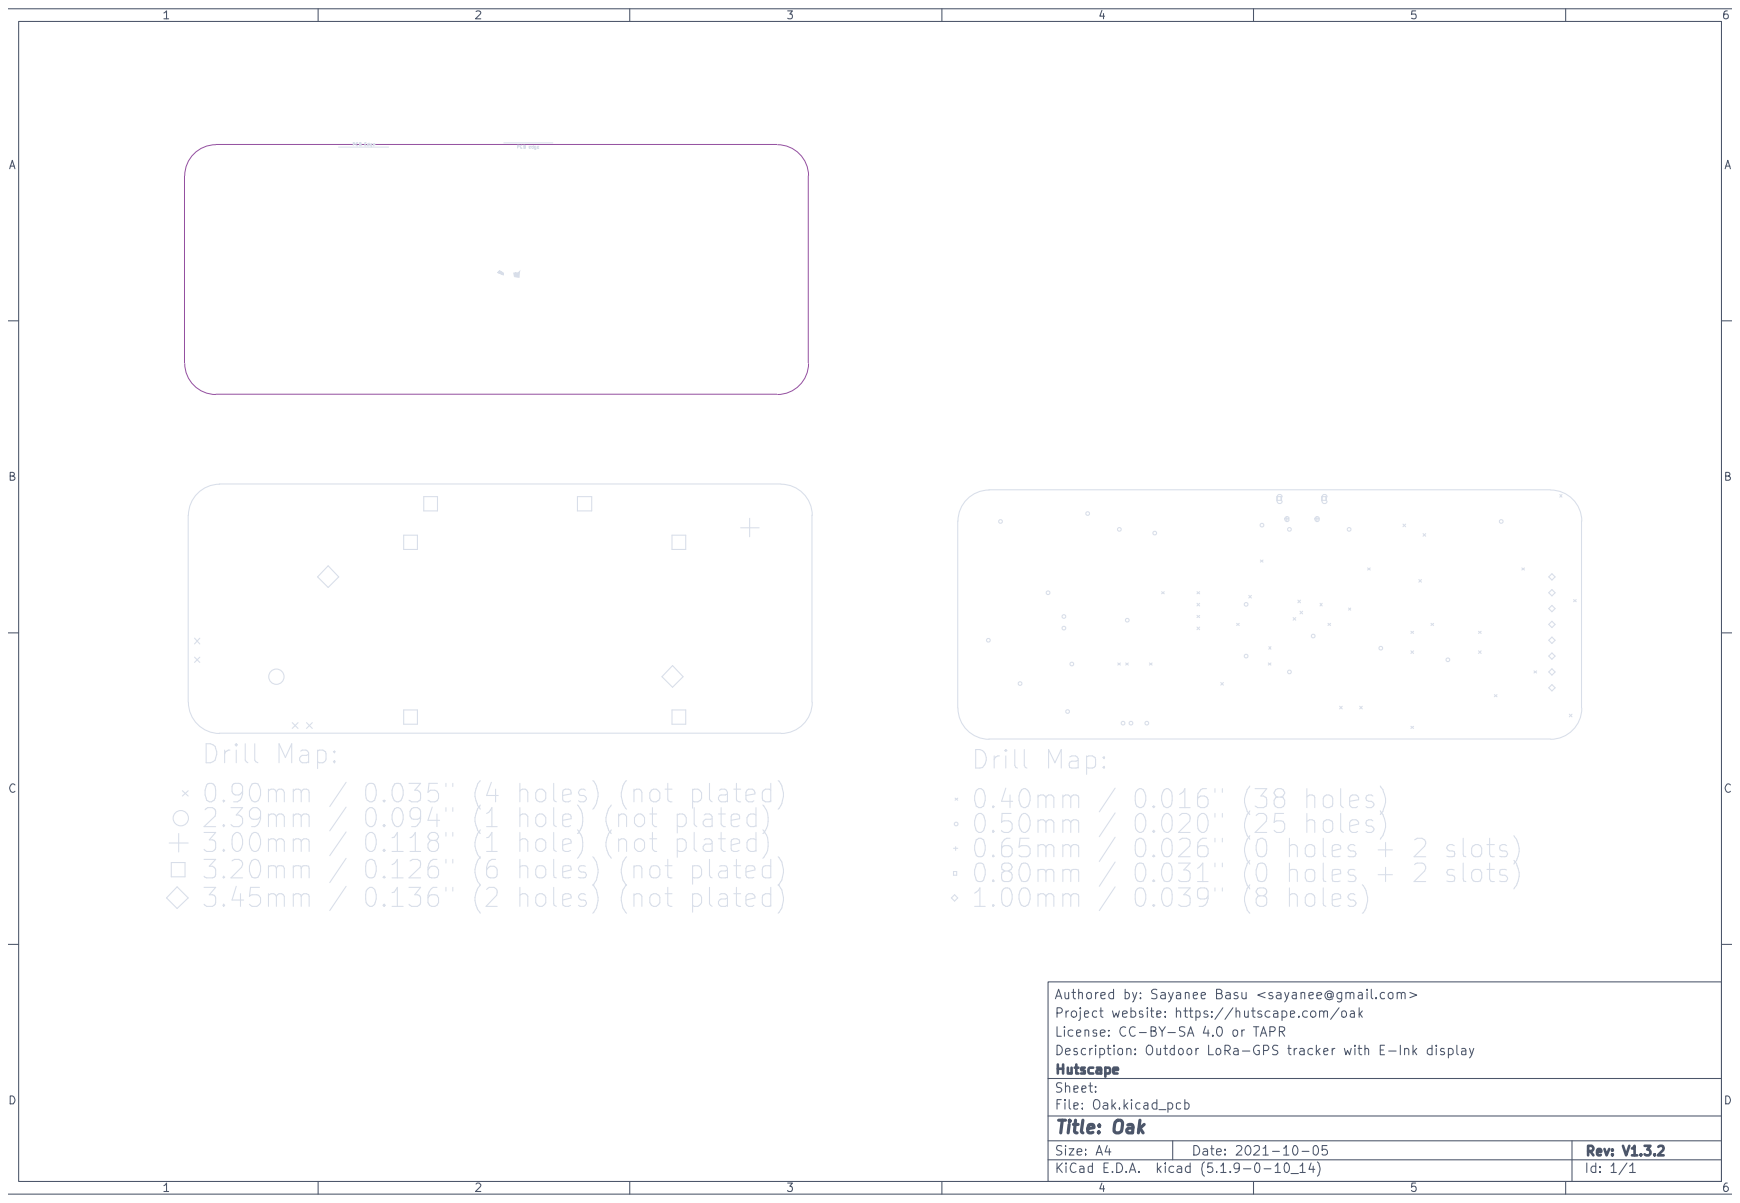
[picture p102: page 9]

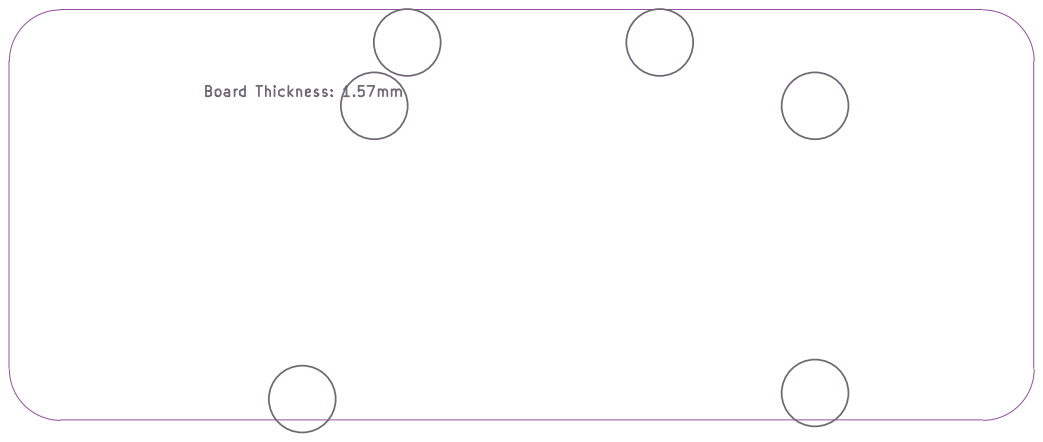
[picture p103: page 10]

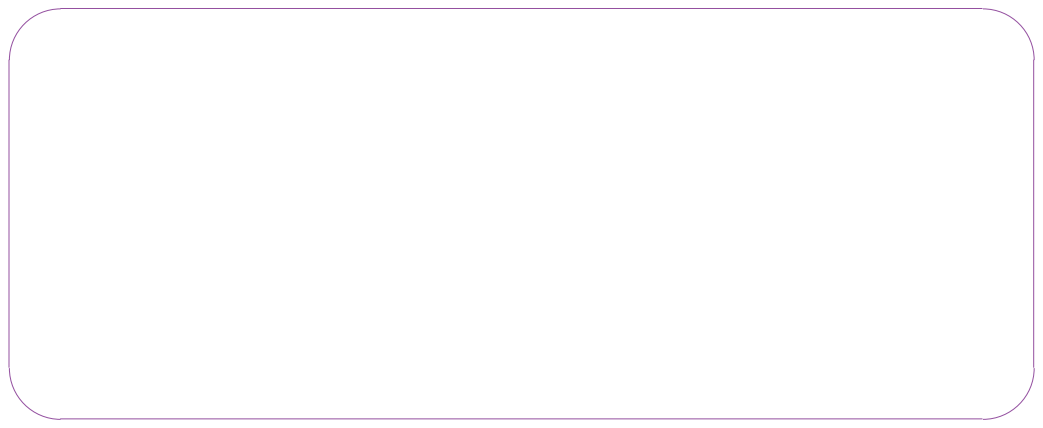
[picture p104: page 11]

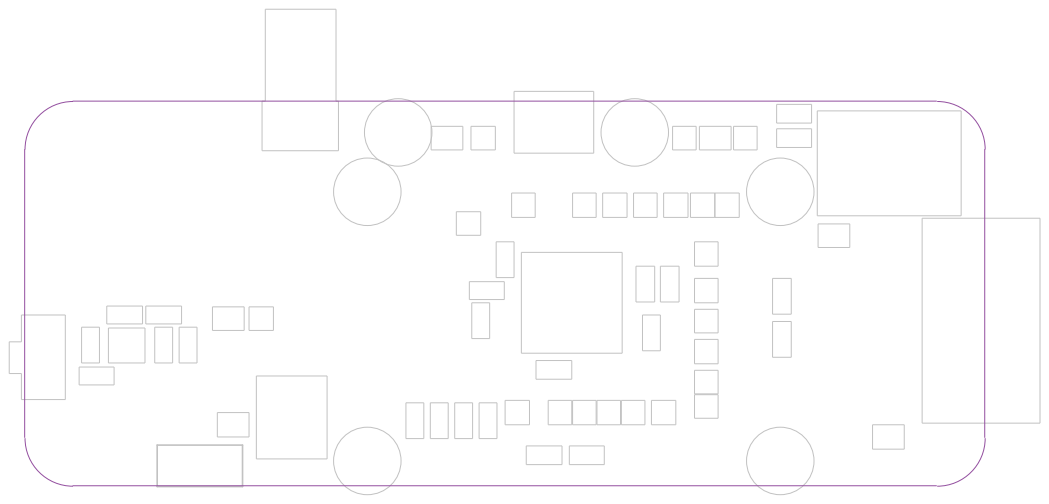
[picture p105: page 12]

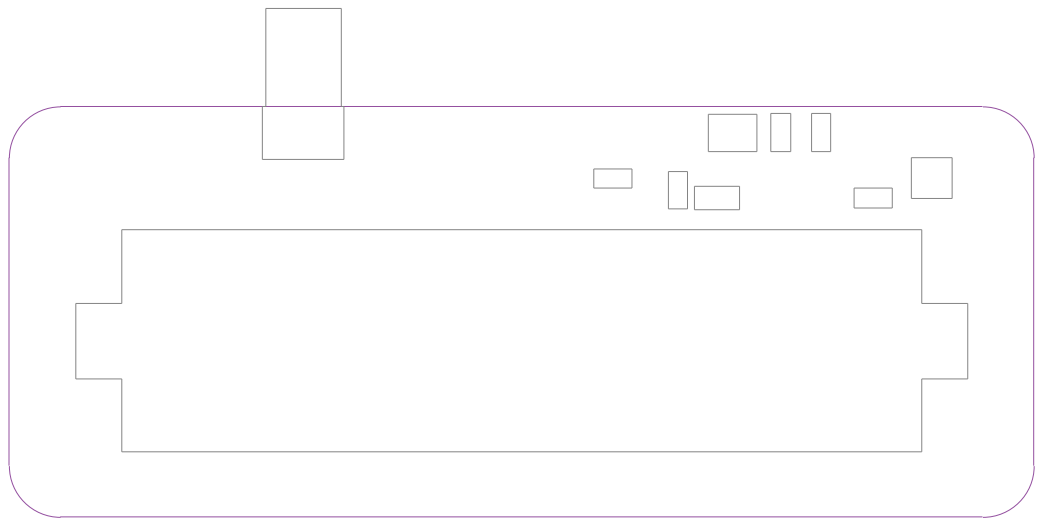
[picture p106: page 13]

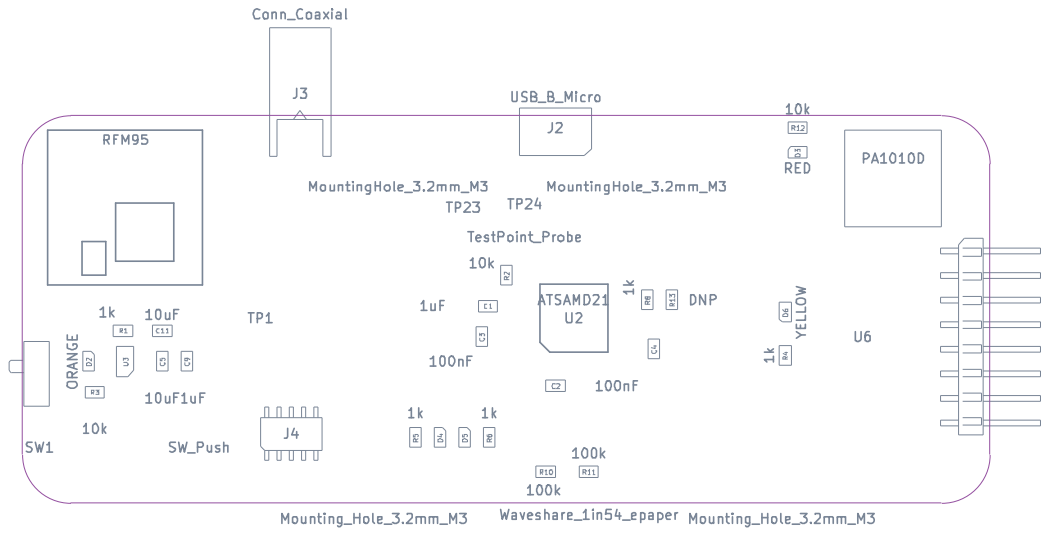
[picture p107: page 14]

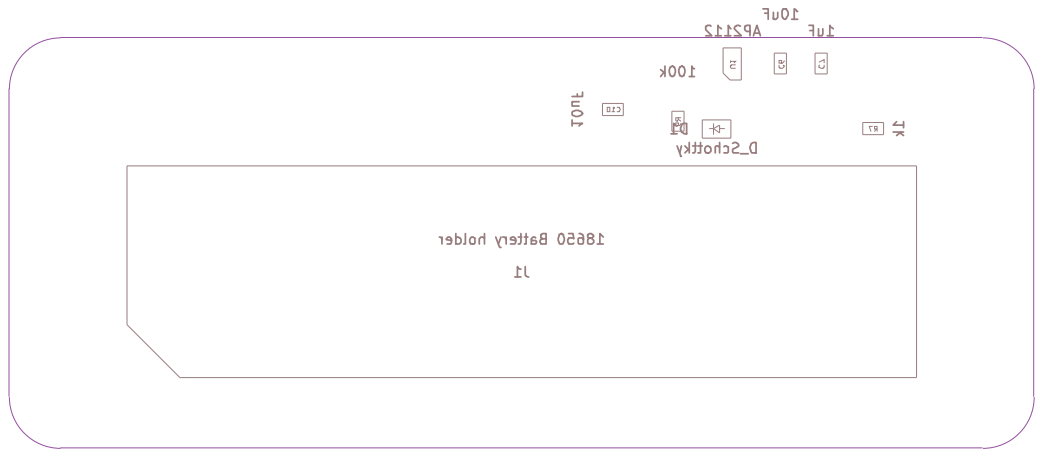
[picture p108: page 15]
