hutscape/oak/pcb/Oak.kicad_pcb

## KiCad design pcb/Oak.kicad_pcb (2022-05-19)

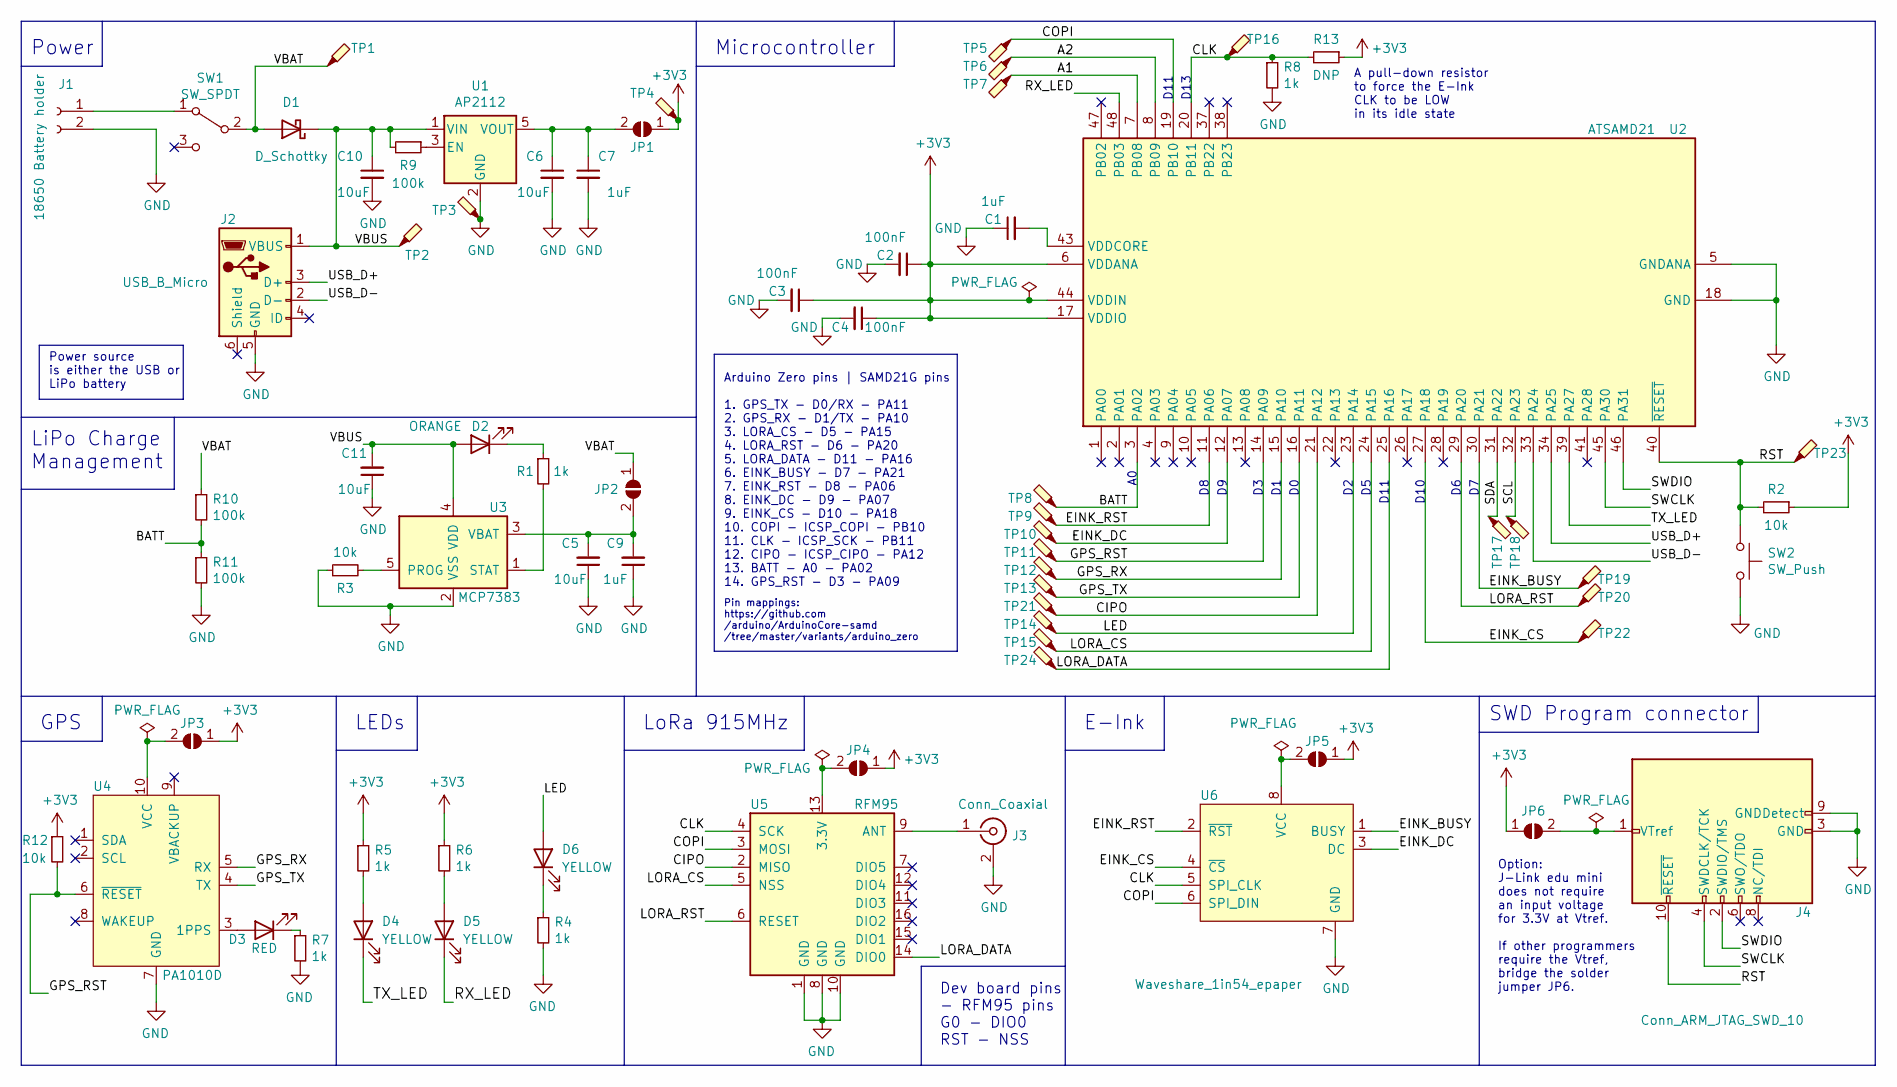
[picture p109: schematic Oak.kicad_sch]

Parts:
C1, C7, C9: 1uF; C_0805_2012Metric_Pad1.15x1.40mm_HandSolder; MPN C0805C105K3RACTU
C2, C3, C4: 100nF; C_0805_2012Metric_Pad1.15x1.40mm_HandSolder; MPN GCM21BR72A104KA37L
C5, C6, C10, C11: 10uF; C_0805_2012Metric_Pad1.15x1.40mm_HandSolder; MPN LMK212ABJ106KGHT
D1: D_Schottky; D_SOD-123F; MPN PMEG3020EH,115
D2: ORANGE; LED_0805_2012Metric_Pad1.15x1.40mm_HandSolder; MPN SML-D15DWT86
D3: RED; LED_0805_2012Metric_Pad1.15x1.40mm_HandSolder; MPN MCL-S270SRC
D4, D5, D6: YELLOW; LED_0805_2012Metric_Pad1.15x1.40mm_HandSolder; MPN 17-215UYC/S530-A3/TR8
J1: 18650 Battery holder; BatteryHolder_Keystone_1042_1x18650; MPN 1042P
J2: USB_B_Micro; USB_Micro-B_Horizontal-U254-051T-4BH23-S2B; MPN U254-051T-4BH23-S2B
J3: Conn_Coaxial; SMA_Samtec_SMA-J-P-X-ST-EM1_EdgeMount; MPN MP-19-70-4-TGG
J4: Conn_ARM_JTAG_SWD_10; PinHeader_2x05_P1.27mm_Vertical_SMD; MPN FTSH-105-01-L-DV
JP1, JP2, JP3, JP4, JP5, JP6: SolderJumper_2_Open; SolderJumper-2_P1.3mm_Open_TrianglePad1.0x1.5mm
R1, R4, R5, R6, R7, R8: 1k; R_0805_2012Metric_Pad1.15x1.40mm_HandSolder; MPN MCWR08X1001FTL
R2, R3, R12: 10k; R_0805_2012Metric_Pad1.15x1.40mm_HandSolder; MPN CRCW080510K0FKEAC
R9, R10, R11: 100k; R_0805_2012Metric_Pad1.15x1.40mm_HandSolder; MPN RTT051003BTP
R13: DNP; R_0805_2012Metric_Pad1.15x1.40mm_HandSolder
SW1: SW_SPDT; SW_SPDT_PCM12; MPN CUS-12TB
SW2: SW_Push; Tactile_pushbutton; MPN RTLECS Tactile side-actuated switch
TP1, TP2, TP3, TP4, TP5, TP6, TP7, TP8, TP9, TP10, TP11, TP12, TP13, TP14, TP15, TP16, TP17, TP18, TP19, TP20, TP21, TP22, TP23, TP24: TestPoint_Probe; TestPoint_Pad_1.5x1.5mm
U1: AP2112; SOT-23-5_HandSoldering; MPN AP2112K-3.3TRG1
U2: ATSAMD21; TQFP-48_7x7mm_P0.5mm; MPN ATSAMD21G18A-AU
U3: MCP7383; SOT-23-5; MPN MCP73831T-2ACI/OT
U4: PA1010D; CDTop_MT3333_PA1010D; MPN PA1010D
U5: RFM95; HopeRF_RFM9X-SMD; MPN RFM95W-915S2
U6: Waveshare_1in54_epaper; Waveshare_1.54_E-Ink; MPN 614961950511

Connections:
+3V3: C2.1, C3.1, C4.1, JP1.1 (A), JP3.1 (A), JP4.1 (A), JP5.1 (A), JP6.1 (A), R2.1, R5.1, R6.1, R12.1, R13.1, TP4.1, U2.6 (VDDANA), U2.17 (VDDIO), U2.36 (VDDIO), U2.44 (VDDIN)
/A1: TP7.1, U2.7 (PB08)
/A2: TP6.1, U2.8 (PB09)
/BATT: R10.2, R11.1, TP8.1, U2.3 (PA02)
/CIPO: TP21.1, U2.21 (PA12), U5.2 (MISO)
/CLK: R8.1, R13.2, TP16.1, U2.20 (PB11), U5.4 (SCK), U6.5 (SPI_CLK)
/COPI: TP5.1, U2.19 (PB10), U5.3 (MOSI), U6.6 (SPI_DIN)
/EINK_BUSY: TP19.1, U2.30 (PA21), U6.1 (BUSY)
/EINK_CS: TP22.1, U2.27 (PA18), U6.4 (~CS)
/EINK_DC: TP10.1, U2.12 (PA07), U6.3 (DC)
/EINK_RST: TP9.1, U2.11 (PA06), U6.2 (~RST)
/GPS_RST: R12.2, TP11.1, U2.14 (PA09), U4.6 (~RESET)
/GPS_RX: TP12.1, U2.15 (PA10), U4.5 (RX)
/GPS_TX: TP13.1, U2.16 (PA11), U4.4 (TX)
/LED: D6.2 (A), TP14.1, U2.23 (PA14)
/LORA_CS: TP15.1, U2.24 (PA15), U5.5 (NSS)
/LORA_DATA: TP24.1, U2.25 (PA16), U5.14 (DIO0)
/LORA_RST: TP20.1, U2.29 (PA20), U5.6 (RESET)
/RST: J4.10 (~RESET), R2.2, SW2.1, TP23.1, U2.40 (~RESET)
/RX_LED: D5.1 (K), U2.48 (PB03)
/SCL: TP18.1, U2.32 (PA23)
/SDA: TP17.1, U2.31 (PA22)
/SWCLK: J4.4 (SWDCLK/TCK), U2.45 (PA30)
/SWDIO: J4.2 (SWDIO/TMS), U2.46 (PA31)
/TX_LED: D4.1 (K), U2.39 (PA27)
/USB_D+: J2.3 (D+), U2.34 (PA25)
/USB_D-: J2.2 (D-), U2.33 (PA24)
/VBAT: D1.2 (A), JP2.1 (A), R10.1, SW1.2 (B), TP1.1
/VBUS: C10.1, C11.2, D1.1 (K), D2.2 (A), J2.1 (VBUS), R9.2, TP2.1, U1.1 (VIN), U3.4 (VDD)
GND: C1.1, C2.2, C3.2, C4.2, C5.1, C6.2, C7.2, C9.1, C10.2, C11.1, J1.2, J2.5 (GND), J3.2 (Ext), J4.3 (GND), J4.5 (GND), J4.9 (GNDDetect), R3.1, R4.2, R7.2, R8.2, R11.2, SW2.2, TP3.1, U1.2 (GND), U2.5 (GNDANA), U2.18 (GND), U2.35 (GND), U2.42 (GND), U3.2 (VSS), U4.7 (GND), U5.1 (GND), U5.8 (GND), U5.10 (GND), U6.7 (GND)
unnamed: C1.2, U2.43 (VDDCORE)
unnamed: C5.2, C9.2, JP2.2 (B), U3.3 (VBAT)
unnamed: C6.1, C7.1, JP1.2 (B), U1.5 (VOUT)
unnamed: D2.1 (K), R1.1
unnamed: D3.1 (K), R7.1
unnamed: D3.2 (A), U4.3 (1PPS)
unnamed: D4.2 (A), R5.2
unnamed: D5.2 (A), R6.2
unnamed: D6.1 (K), R4.1
unnamed: J1.1, SW1.1 (A)
unnamed: J3.1 (In), U5.9 (ANT)
unnamed: J4.1 (VTref), JP6.2 (B)
unnamed: JP3.2 (B), U4.10 (VCC)
unnamed: JP4.2 (B), U5.13 (3.3V)
unnamed: JP5.2 (B), U6.8 (VCC)
unnamed: R1.2, U3.1 (STAT)
unnamed: R3.2, U3.5 (PROG)
unnamed: R9.1, U1.3 (EN)

Notes on the sheet:
LoRa 915MHz
Power
Arduino Zero pins | SAMD21G pins 1. GPS_TX - D0/RX - PA11 2. GPS_RX - D1/TX - PA10 3. LORA_CS - D5 - PA15 4. LORA_RST - D6 - PA20 5. LORA_DATA - D11 - PA16 6. EINK_BUSY - D7 - PA21 7. EINK_RST - D8 - PA06 8. EINK_DC - D9 - PA07 9. EINK_CS - D10 - PA18 10. COPI - ICSP_COPI - PB10 11. CLK - ICSP_SCK 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
Dev board pins - RFM95 pins G0 - DIO0 RST - NSS
SWD Program connector
Microcontroller
Power source is either the USB or LiPo battery
A pull-down resistor to force the E-Ink CLK to be LOW in its idle state
D13
Pin mappings: https://github.com /arduino/ArduinoCore-samd /tree/master/variants/arduino_zero
GPS
LEDs
LiPo Charge Management
E-Ink
Option: J-Link edu mini does not require an input voltage for 3.3V at Vtref. If other programmers require the Vtref, bridge the solder jumper JP6.
D10
D11

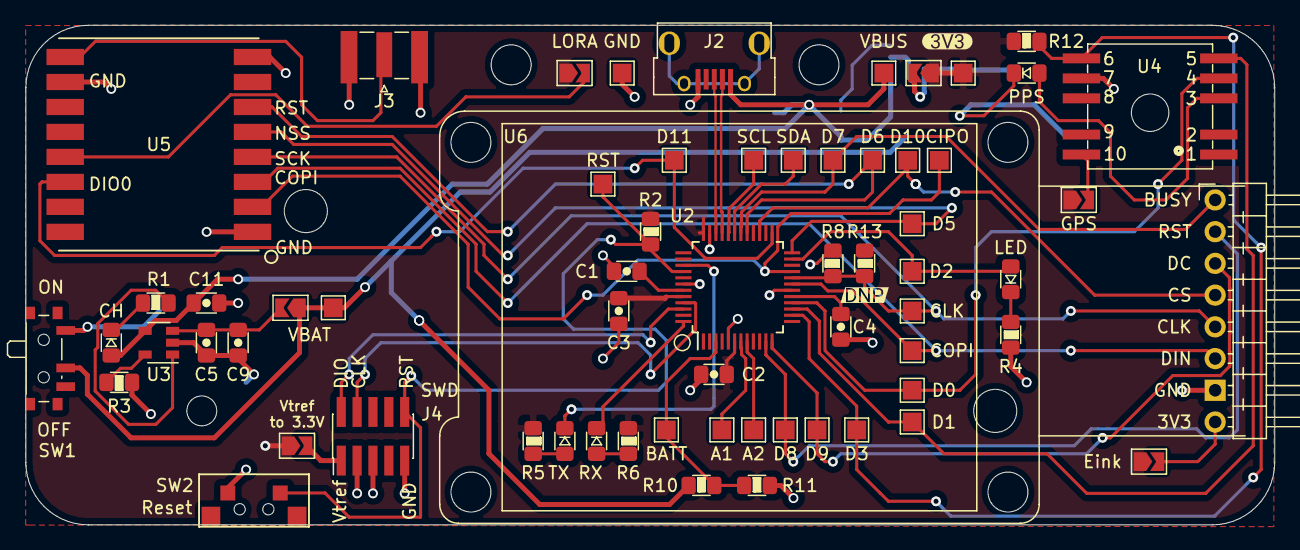
[picture p110: board Oak.kicad_pcb from above]

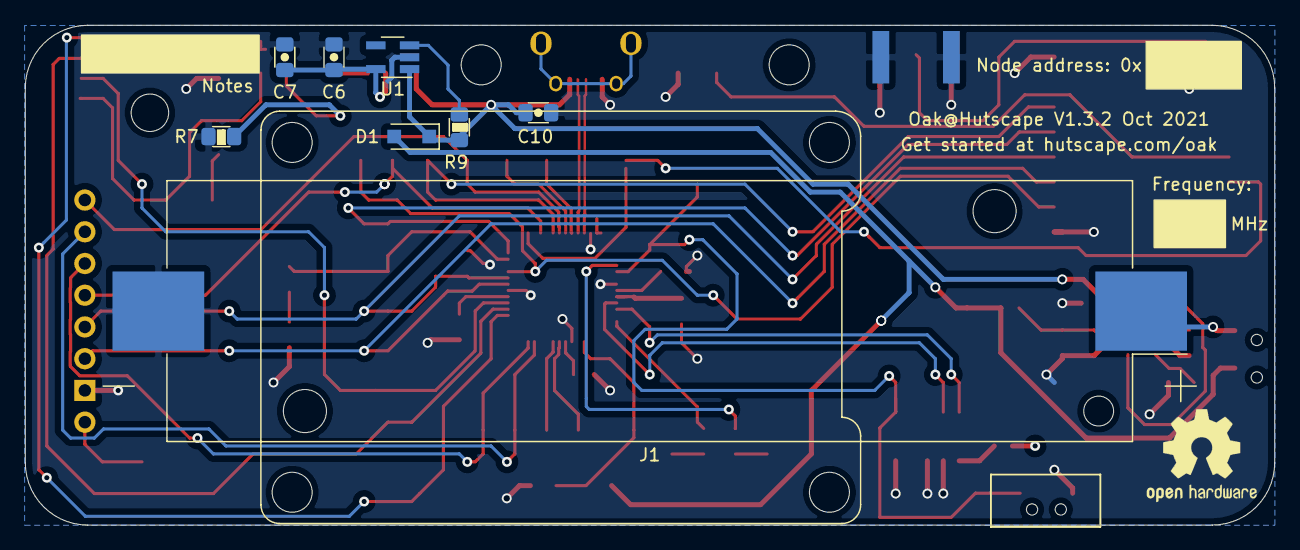
[picture p111: board Oak.kicad_pcb from below]

Board: 2 copper layers, 100.0 x 40.0 mm, 73 parts (8 on the bottom side), 48 nets.

Other parts of the board:
e: G***; label
svg2mod: G***; label
