hutscape/oak/_code/eink/imageData.cpp

/**
 *  @filename   :   imagedata.cpp
 *  @brief      :   data file for epd demo
 *
 *  Copyright (C) Waveshare     September 5 2017
 *
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
 * THE SOFTWARE IS PROVIDED "AS IS", WITHOUT WARRANTY OF ANY KIND, EXPRESS OR
 * IMPLIED, INCLUDING BUT NOT LIMITED TO THE WARRANTIES OF MERCHANTABILITY,
 * FITNESS OR A PARTICULAR PURPOSE AND NONINFRINGEMENT. IN NO EVENT SHALL THE
 * AUTHORS OR COPYRIGHT HOLDERS BE LIABLE FOR ANY CLAIM, DAMAGES OR OTHER
 * LIABILITY WHETHER IN AN ACTION OF CONTRACT, TORT OR OTHERWISE, ARISING FROM,
 * OUT OF OR IN CONNECTION WITH THE SOFTWARE OR THE USE OR OTHER DEALINGS IN
 * THE SOFTWARE.
 */

#include "imagedata.h"

#include <avr/pgmspace.h>

const unsigned char IMAGE_DATA[] PROGMEM = {
    /* 0X00,0X01,0XC8,0X00,0XC8,0X00, */
    0XFF,
    0XFF,
    0XFF,
    0XFF,
    0XFF,
    0XFF,
    0XFF,
    0XFF,
    0X8F,
    0XFF,
    0XFF,
    0XFF,
    0XFF,
    0XFF,
    0XFF,
    0XFF,
    0XF1,
    0XFF,
    0XFF,
    0XFF,
    0XFF,
    0XFF,
    0XFF,
    0XFF,
    0XFF,
    0XFF,
    0XFF,
    0XFF,
    0XFF,
    0XFF,
    0XFF,
    0XFF,
    0XFF,
    0X8F,
    0XFF,
    0XFF,
    0XFF,
    0XFF,
    0XFF,
    0XFF,
    0XFF,
    0XF1,
    0XFF,
    0XFF,
    0XFF,
    0XFF,
    0XFF,
    0XFF,
    0XFF,
    0XFF,
    0XFF,
    0XFF,
    0XFF,
    0XFF,
    0XFF,
    0XFF,
    0XFF,
    0XFF,
    0X8F,
    0XFF,
    0XFF,
    0XFF,
    0XFF,
    0XFF,
    0XFF,
    0XFF,
    0XF1,
    0XFF,
    0XFF,
    0XFF,
    0XFF,
    0XFF,
    0XFF,
    0XFF,
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
    0XFF,
    0XFF,
    0XFF,
    0XFF,
    0XFF,
    0XFF,
    0XFF,
    0XFF,
    0XFF,
    0XFF,
    0XFF,
    0XFF,
    0X8F,
    0XFF,
    0XFF,
    0XFF,
    0XFF,
    0XFF,
    0XFF,
    0XFF,
    0XF1,
    0XFF,
    0XFF,
    0XFF,
    0XFF,
    0XFF,
    0XFF,
    0XFF,
    0XFF,
};
