hutscape/oak/(commit log)

2019-11-09 feat: add schematic for LoRa module and antenna
    [Oak.kicad_pcb, Oak.sch]
2019-11-09 chore: rearrange folders
    [Oak.kicad_pcb, Oak.sch]
2019-11-10 feat: add bill of materials page for lora module and antenna
    [Oak.sch, bill_of_materials.csv]
2019-11-13 fix: change to SAMD21E 32 pin
2019-11-14 docs: add reference for E-Ink schematic
2019-11-15 chore: update kicad library with new symbols
2020-02-22 docs: update library
    [Oak.sch]
2020-10-10 docs: add link to LoRa antennas
2020-10-12 feat: add debug prints
2020-10-13 docs: add a note and references for SPI conflicts in LoRa and E-ink
2020-10-13 docs: add hardware page with breadboard prototype photo
2020-10-13 feat: add schematic for breadboard prototype
    [Oak.sch]
2020-10-13 refactor: gitignore kicad backup file
2020-10-13 fix: e-ink is no longer printing extra char with null character. close #4
2020-10-20 feat: add pin mapping info for Arduino Zero and SAMD21G
    [Oak.sch]
2020-10-20 feat: replace Arduino Zero dev board with just the mcu in schematic
    [Oak.sch]
2020-10-21 feat: add reset and TX/RX LEDs
    [Oak.sch]
2020-10-21 feat: add SWD program connector in schematic:
    [Oak.sch]
2020-10-26 refactor: remove enable SPI functions not required
2020-10-26 fix: solve SPI conflict with a pull-down resistor. #6
    [Oak.sch]
2020-11-17 feat: add lipo charging, micro-usb and breakout lora to schematic
    [Oak.sch]
2020-11-18 refactor: update SPI pin names
    [Oak.sch]
2020-11-18 refactor: update schematic PDF
2020-11-18 fix: fix SPI pin connections
    [Oak.sch]
2020-11-18 refactor: update new schematic PDF
2020-11-23 feat: add extension headers, more decoupling caps + pullup/down resistors
    [Oak.sch]
2020-11-23 refactor: add decoupling caps and fix net labels
    [Oak.sch]
2020-11-24 refactor: add pullup / pulldown resistor for SPI CLK
    [Oak.sch]
2020-12-09 feat: associate some parts with footprints
    [Oak.sch]
2021-01-20 data: add BOM columns for capacitors and schottky diode
    [Oak.sch]
2021-01-20 data: add BOM columns for LEDs and associate footprints for all 0805
    [Oak.sch]
2021-01-20 docs: add more BOM info for parts
    [Oak.sch]
2021-01-20 feat: explort netlist and create rats nest
    [Oak.kicad_pcb, Oak.sch]
2021-01-21 feat: add complete BOM
    [Oak.sch, bill_of_materials.csv]
2021-01-21 docs: update BOM
    [Oak.sch]
2021-01-22 docs: add mechanical, antenna, battery and PCB to BOM
    [bill_of_materials.csv]
2021-01-25 chore: update kicad xml
2021-04-06 refactor: change from LiPo to 18650 battery
    [Oak.sch, bill_of_materials.csv]
2021-04-06 refactor: change to 18650 SMD battery holder
    [Oak.kicad_pcb, Oak.sch, bill_of_materials.csv]
2021-04-06 feat: add XH2.54 JST 2.54mm Pitch 8pin connector for e-ink
    [bill_of_materials.csv]
2021-04-06 fix: fix spelling, submodule https url and extra BOM
    [Oak.sch, bill_of_materials.csv]
2021-04-07 feat: place components on PCB
    [Oak.kicad_pcb]
2021-04-07 feat: remove all traces to focus on placement first
    [Oak.kicad_pcb]
2021-04-08 feat: add more routes and traces for PCB Layout
    [Oak.kicad_pcb]
2021-04-29 feat: new netlist, new PCB layout
    [Oak.kicad_pcb]
2021-04-29 feat: import new ratsnest
    [Oak.kicad_pcb]
2021-04-29 feat: move logical block power components into a seperate block
    [Oak.kicad_pcb]
2021-04-29 feat: move logical block lipo charging components into a seperate block
    [Oak.kicad_pcb]
2021-05-04 feat: move logical block gps components into a seperate block
    [Oak.kicad_pcb]
2021-05-04 feat: move logical block led components into a seperate block
    [Oak.kicad_pcb]
2021-05-05 feat: move logical block lora components into a seperate block
    [Oak.kicad_pcb]
2021-05-05 feat: move logical block eink components into a seperate block
    [Oak.kicad_pcb]
2021-05-05 feat: move logical block mcu components into a seperate block
    [Oak.kicad_pcb]
2021-05-06 feat: move all components nearer
    [Oak.kicad_pcb]
2021-05-07 refactor: change pin headers to test points for mcu pins
    [Oak.kicad_pcb, Oak.sch]
2021-05-09 feat: place all components on PCB with silkscreen labels
    [Oak.kicad_pcb]
2021-05-10 feat: confirm component placement with silkscreen
    [Oak.kicad_pcb, Oak.sch]
2021-05-10 feat: fix all clearance issues with local clearance settings
    [Oak.kicad_pcb]
2021-05-13 feat: add inverted labels with more routes (33 unconnected). close #18
    [Oak.kicad_pcb]
2021-05-14 feat: add more routes (22 remaining unconnected)
    [Oak.kicad_pcb, Oak.sch]
2021-05-15 feat: add more routes (14 remaining unconnected)
    [Oak.kicad_pcb, Oak.sch]
2021-05-15 feat: add more routes (11 remaining unconnected)
    [Oak.kicad_pcb]
2021-05-15 feat: add more routes (10 remaining unconnected)
    [Oak.kicad_pcb]
2021-05-15 feat: add more routes (0 remaining unconnected)
    [Oak.kicad_pcb]
2021-05-15 feat: complete all routes with rendered documents and images
    [Oak.kicad_pcb]
2021-05-16 refactor: enable courtyard check for M3 mounting holes
    [Oak.kicad_pcb, Oak.sch]
2021-05-16 refactor: use functional net label names instead of Arduino pin names. #19
    [Oak.kicad_pcb, Oak.sch]
2021-05-16 chore: update all images and docs
    [Oak.kicad_pcb]
2021-05-18 refactor: connect both TX and RX of GPS module (4 unconnected)
    [Oak.kicad_pcb, Oak.sch]
2021-05-18 feat: connect GPS RX (2 remaining unconnected)
    [Oak.kicad_pcb]
2021-05-19 feat: complete route for LORA data and connect both TX and RX to GPS module
    [Oak.kicad_pcb, Oak.sch]
2021-05-19 feat: generate BOM with updated schematics and layout. #19
    [bill_of_materials.csv]
2021-05-21 feat: add bill of material info on extra items and stats. #19
    [Oak.kicad_pcb, Oak.sch, bill_of_materials.csv]
2021-05-21 refactor: add more info in BOM. #19
    [bill_of_materials.csv]
2021-05-21 feat: generate iBOM
    [Oak.kicad_pcb]
2021-05-21 refactor: simplify trace bends
    [Oak.kicad_pcb]
2021-05-23 feat: add 2 M3 mechanical NPTH holes for hanging/mounting the PCB. #19
    [Oak.kicad_pcb]
2021-05-24 feat: generate drill map table
    [Oak.kicad_pcb]
2021-05-26 docs: change power to 18650
2021-05-26 docs: change RED LED in Bill of Materials
    [bill_of_materials.csv]
2021-05-29 docs: add internal stock references to Bill of Materials
    [bill_of_materials.csv]
2021-05-29 chore: update files
    [Oak.sch]
2021-05-30 refactor: associate angled pin header for the e-ink display in 3D viewer
    [Oak.kicad_pcb]
2021-05-30 docs: add U6 pin header and U7 E-ink display for BOM
    [bill_of_materials.csv]
2021-05-30 chore: update bulma and docs for generating bom stats
2021-05-31 fix: change SMA connector to 0.25 inch
    [Oak.kicad_pcb, Oak.sch]
2021-05-31 refactor: regenerate drill map files
    [Oak.kicad_pcb]
2021-06-02 feat: add antenna received in stock
    [bill_of_materials.csv]
2021-06-04 chore: add right-angled pin header delivery
    [bill_of_materials.csv]
2021-06-04 fix: add more info about DNP part
    [bill_of_materials.csv]
2021-06-09 fix: fix DNP R13 in BOM and iBOM
    [Oak.sch]
2021-06-24 refactor: rotate symbol name and delete extra track on uUSB J2
    [Oak.kicad_pcb, Oak.sch]
2021-06-25 docs: Change Q to Qty in bill_of_materials.csv
    [bill_of_materials.csv]
2021-06-26 refactor: use Qty instead of Q for BOM display
2021-06-26 refactor: Improve Mouser link in BOM for kitspace
    [bill_of_materials.csv]
2021-06-29 docs: add steps for bringing up the board
2021-06-29 refactor: change track width to power net class for VOUT 3.3V of LDO
    [Oak.kicad_pcb]
2021-06-29 docs: add a note on putting ground as a test point with clip
2021-06-29 refactor: add RST on silkscreen for SWD connector and delete extra tracks on pads
    [Oak.kicad_pcb]
2021-06-30 docs: change 10k resistor from Mouser to Element14 Farnell
    [bill_of_materials.csv]
2021-07-02 refactor: add an option to not connect Vtref for SWD for J-Link Edu mini
    [Oak.kicad_pcb, Oak.sch]
2021-07-22 refactor: align net label
    [Oak.sch]
2021-07-23 feat: add silkscreen writable area for LoRa node address and frequency. close #25
    [Oak.kicad_pcb]
2021-07-23 fix: amend a 90deg track
    [Oak.kicad_pcb]
2021-08-12 feat: add first code example of serial prints
2021-08-23 refactor: combine design, power and mechanical into design
2021-09-09 fix: fix circuit for measuring VBAT
    [Oak.kicad_pcb, Oak.sch]
2021-09-09 docs: explain the requirement for button-top 18560 batteries
    [bill_of_materials.csv]
2021-09-10 feat: test hello world blinky code with bodged LED circuit
    [Oak.kicad_pcb, Oak.sch]
2021-09-10 feat: add blinky LED hello world photos
2021-09-10 feat: add serial prints for hello world example
2021-09-10 fix: reset fonts after inserting iBom
2021-09-22 feat: add blinky LED for measuring batt
2021-09-28 docs: add example on uploading Arduino Zero bootloader with J-Link edu mini
2021-10-05 fix: change LoRa CIPO pin from PA19 (D12) to PA12
    [Oak.kicad_pcb, Oak.sch]
2021-10-05 refactor: fix lora tx code
    [lora-tx.ino]
2021-10-05 fix: correct notes on SPI COPI as PA12 pin
    [Oak.sch]
2021-10-05 fix: add back download buttons
2021-10-06 refactor: add 1cm height for standoff and remove hex nuts for mounting E-Ink module
    [bill_of_materials.csv]
2021-10-08 feat: add code example for GPS fix
    [gps-fix-parsed.ino]
2021-10-19 refactor: rename LED on silkscreen
    [Oak.kicad_pcb]
2021-10-20 docs: add examples on how to create custom Arduino board
2021-10-23 docs: add more details to how to create custom Arduino boards
2021-10-23 docs: add more details to custom board
2021-10-24 docs: add more images for custom Arduino board installation
2021-11-11 docs: add lora-related prototype setup image
2021-11-11 docs: add GPS prototype setup photos
2021-11-11 docs: add image for custom arduino board
2021-11-11 docs: add eink prototype image
2021-11-11 refactor: put the prototype image at the top of examples
2021-12-01 feat: add demo code to get a GPS fix and display on E-Ink
    [demo.ino]
2021-12-02 feat: serial print more GPS info
2021-12-03 refactor: remove all serial prints to prepare for debug toggle print
2021-12-03 feat: display absolute time of GPS Fix on the E-Ink module
    [demo.ino]
2021-12-03 refactor: do not display milliseconds time on E-Ink
2021-12-03 fix: print the correct timezone adjusted time
    [demo.ino]
2021-12-03 feat: add toggle for printing debug messages
2021-12-04 docs: add more options to upload code in the board
2021-12-10 refactor: improve LoRa duplex examples to run them battery-powered with LED blinking
2021-12-15 refactor: distinguish between no GPS fix and no new GPS location
    [lora-gps-duplex-a.ino, lora-gps-duplex-b.ino]
2021-12-15 refactor: initialise GPSRST pin to HIGH
2021-12-16 refactor: remove Software page as it replaces Examples
    [lora.cpp, lora.h]
2021-12-16 fix: use the correct SerialUSB for printing
    [eink.ino]
2021-12-18 refactor: remove serial prints
2021-12-23 refactor: add led and other fixes
    [demo.ino]
2021-12-23 feat: add 3 levels of printing debug messages
2021-12-26 refactor: debug print local and destination addresses
2021-12-28 refactor: insert more debug prints on the node addresses
2021-12-31 refactor: display initial messages on the E-Ink without a fix or peer
    [demo.ino]
2021-12-31 refactor: standardise all variable names to latLong and add a valid fix bool
    [demo.ino]
2022-01-03 fix: calculate Haversine only if peer node has a valid GPS fix
    [demo.ino]
2022-01-05 feat: add fast blink LED function
2022-01-05 feat: fast blink the LED when waiting for GPS fix
    [demo.ino]
2022-01-08 docs: add power section
2022-01-08 docs: add charging and dicharging graphs
2022-01-13 fix: process peer lat-long after receiving in LoRa immediately
    [demo.ino]
2022-01-13 refactor: fast blink and print intermediate GPS info while waiting for fix
    [demo.ino]
2022-03-08 docs: add notes on charging and discharging batt
2022-03-14 chore: upgrade to KiCad 6
    [Oak.kicad_pcb, Oak.kicad_sch]
2022-03-16 chore: update symbol table after KiCad 6
2022-04-13 docs: add gerber download link and completed status
2022-04-20 refactor: make a parent data node for download buttons and add demo code link
2022-04-21 refactor: remove gerber_url to link to GitHub releases page
2022-04-21 fix: add missing interative BOM
2022-04-21 "refactor: seperate BOM page into more partials"
2022-04-22 chore: add measurement in user comments layer and kfix 3D model paths for KiCad 6
    [Oak.kicad_pcb]
2022-04-22 feat: add initial FreeCAD files for enclosure
    [oak_case.FCStd]
2022-05-11 feat: add switch, button, usb connector shapes in 3D design
    [Oak.kicad_pcb, oak_case.FCStd]
2022-05-13 feat: add antenna connector and E-Ink screen slots
    [Oak.kicad_pcb, oak_case.FCStd]
2022-05-13 feat: add LED charging and PPS slots
    [Oak.kicad_pcb, oak_case.FCStd]
2022-05-13 feat: extrude PPS and CH LED texts
    [oak_case.FCStd]
2022-05-14 feat: add project name and emboss all texts on the case
    [oak_case.FCStd]
2022-05-14 feat: cut slots and electronics contents
    [oak_case.FCStd]
2022-05-14 feat: create one external screw lug
    [oak_case.FCStd]
2022-05-15 feat: create one screw lug
    [oak_case.FCStd]
2022-05-16 feat: create 4 external screw lugs
    [Oak.kicad_pcb, oak_case.FCStd]
2022-05-16 refactor: add measurements
    [Oak.kicad_pcb, oak_case.FCStd]
2022-05-17 feat: create 2 internal screw lugs
    [Oak.kicad_pcb, oak_case.FCStd]
2022-05-17 feat: export top and bottom part of the enclosure in STL
    [bottom.stl, oak_case.FCStd, top.stl]
2022-05-18 feat: add 186580 battery in 3D models for battery holder
    [Oak.kicad_pcb]
2022-05-18 feat: add grid origin
    [Oak.kicad_pcb]
2022-05-18 feat: integrate KiCad PCB into FreeCAD
    [oak_case.FCStd]
2022-05-18 chore: export both top and bottom parts of the case
    [case.stl]
2022-05-19 feat: add 3D model of stub antenna
    [Oak.kicad_pcb]
2022-05-19 feat: add 3D model of stub antenna in FreeCAD KiCAD integration
2022-05-19 feat: add 3 hex spacers for eink screen in 3D view
    [Oak.kicad_pcb]
2022-05-19 feat: add Waveshare Eink 1.54in screen as a 3D model
    [Oak.kicad_pcb]
2022-05-19 feat: add Eink screen in KiCAD and FreeCAD integration
2022-05-19 feat: create /case to link CAD and STL files with photos
    [bottom.stl, case.stl, top.stl]
2022-05-19 "feat: add /case layout for projects with enclosure designs"
2022-06-02 fix: add new case design to fix slot holes
    [bottom.stl, case.stl, top.stl]
2022-06-03 fix: change screw diameter to 2.8mm for self-tapping screws
2022-06-03 chore: export new STL files
    [bottom.stl, case.stl, top.stl]
2022-06-06 chore: export bottom STL for the case
    [bottom.stl]
2022-06-28 docs: add improvements for enclosure
2022-07-21 refactor: rename hardware layout to pcb
2022-07-21 refactor: rename directory from hardware to pcb
    [Oak.kicad_pcb, Oak.kicad_sch, Oak.sch]
2022-07-22 chore: change completed date because of 3D printing case
2022-07-22 chore: move images from hardware to pcb directory
2022-07-25 docs: add photos with case
2022-07-25 feat: add 3d printed case photos
2022-07-25 feat: add case photos
2023-12-25 fix: fix bom cost code
2024-02-26 feat: update submodules for unique SMT, DNP and TH BOM parts
2024-02-29 chore: update submodules to seperate /case page into sections
2024-02-29 docs: add manufacturing params for case
2024-03-04 fix: add check for an extra empty empty image slot only if there are odd images
2024-03-15 chore: update submodules to display software bill of materials
2024-04-01 feat: update submodules to display manufactured PCB photos
2024-04-11 feat: add a new power page
2024-04-11 docs (power): remove HTML and convert content to only markdown
2024-05-01 chore: update submodules to sync BOM stats with the manufacturer
2024-11-14 chore: update submodule to conditionally display edit button
