hutscape/oak/(notices)

Notices in the files:
pcb/Oak.kicad_pcb:
License: CC-BY-SA 4.0 or TAPR
